Masaharu41/Midi-Bass-Guitar/Images/Midi Waveform.jpg

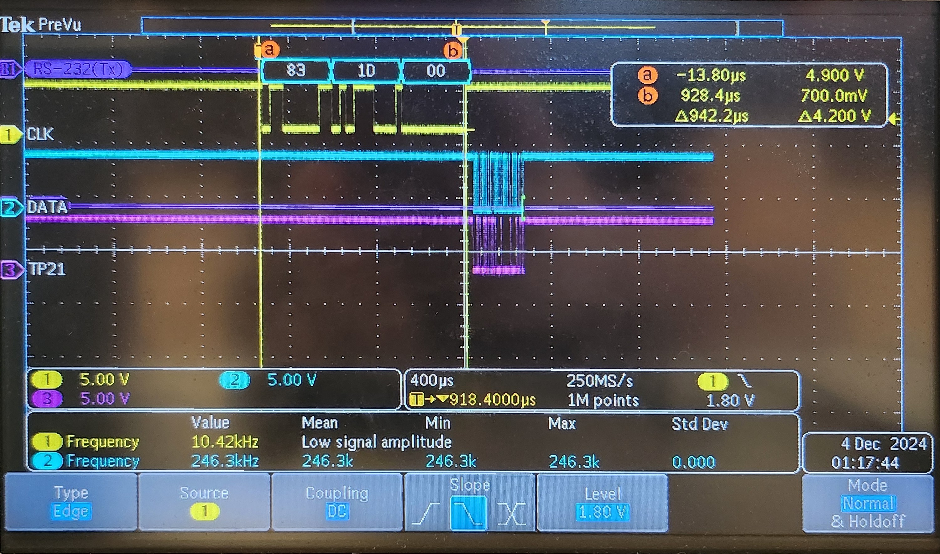
Images/Midi Waveform.jpg
