Masaharu41/Midi-Bass-Guitar/Images/hex switch.jpg

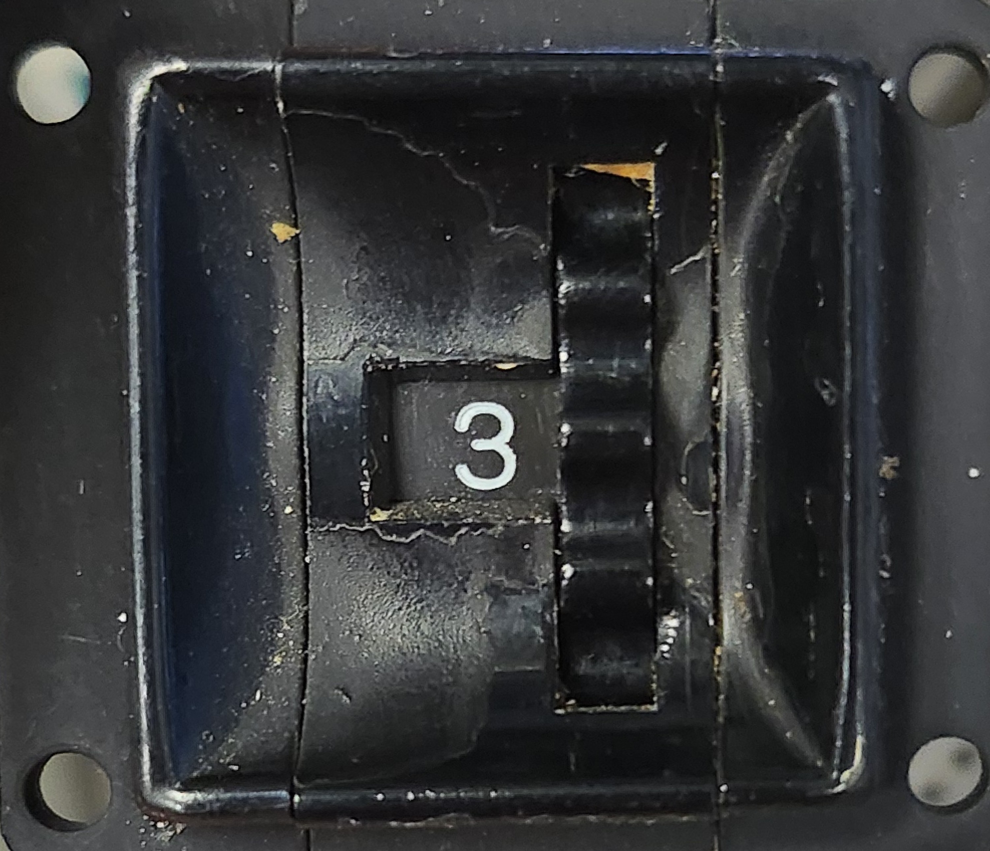
Images/hex switch.jpg
