Masaharu41/Midi-Bass-Guitar/Images/I2C TP.png

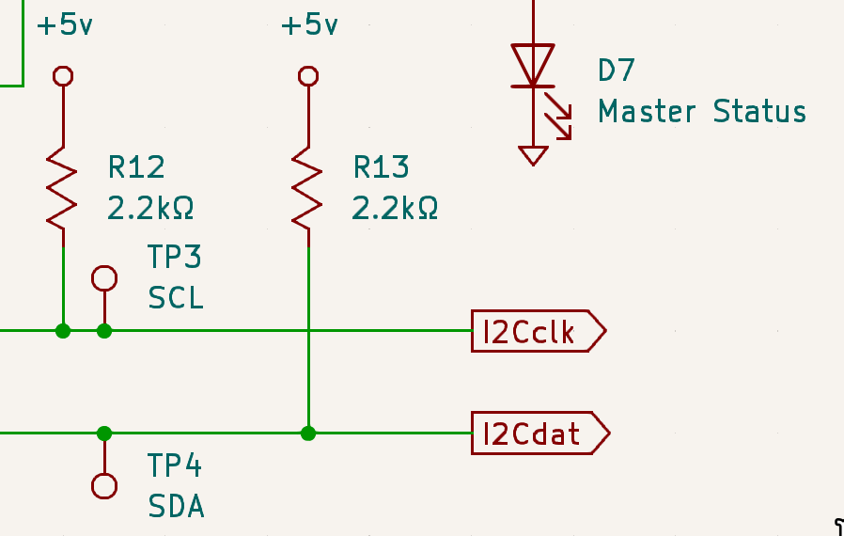
Images/I2C TP.png
