Masaharu41/Midi-Bass-Guitar/Images/I2C waveform.jpg

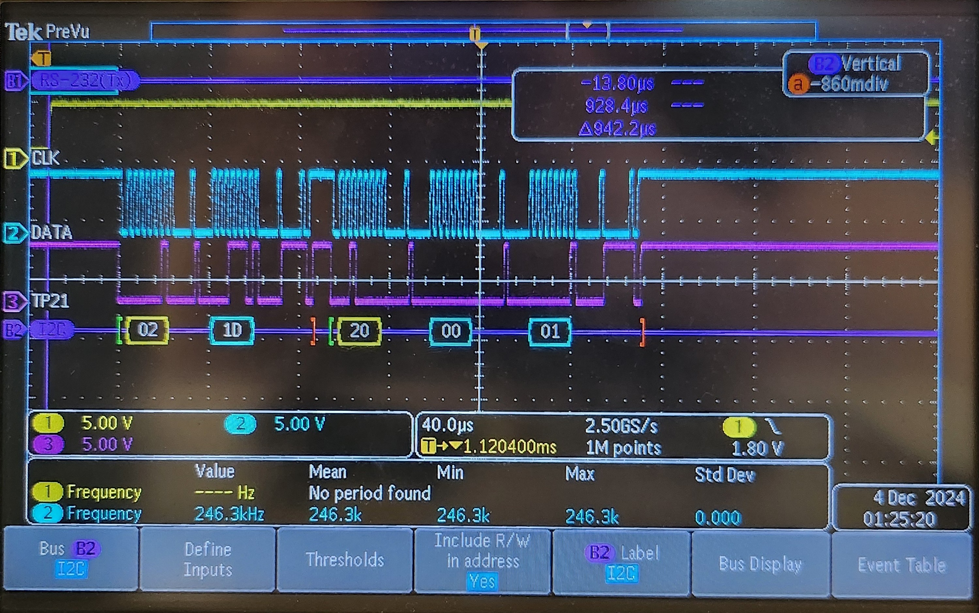
Images/I2C waveform.jpg
