Masaharu41/Midi-Bass-Guitar/Images/MIDI TP.png

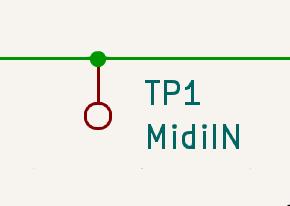
Images/MIDI TP.png
