Masaharu41/Midi-Bass-Guitar/Images/P-bass CAD asm.png

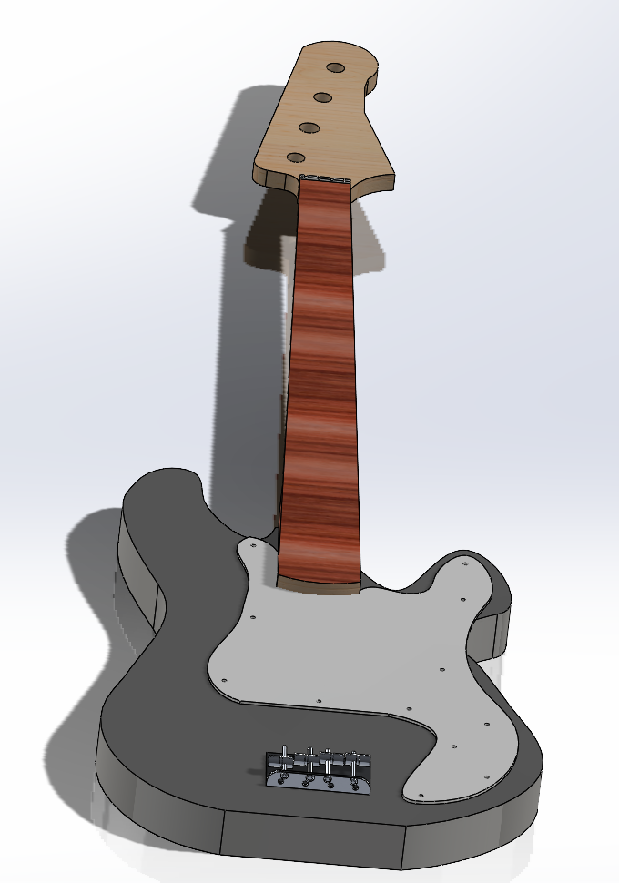
Images/P-bass CAD asm.png
