Masaharu41/Midi-Bass-Guitar/Images/Plucking Output.png

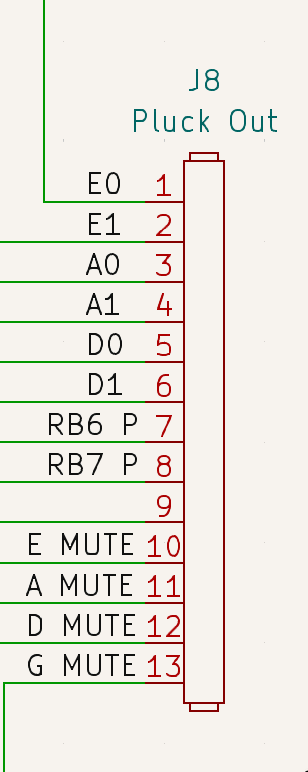
Images/Plucking Output.png
