Masaharu41/Midi-Bass-Guitar/Images/Plucking Program Flowchart.png

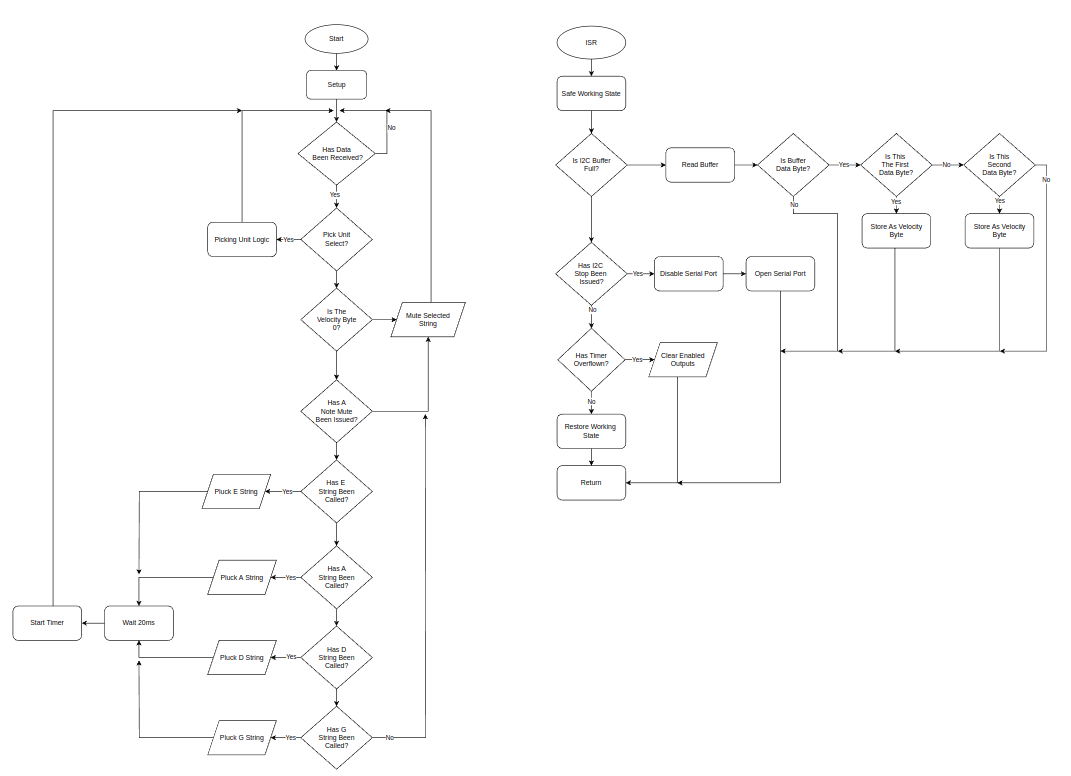
Images/Plucking Program Flowchart.png
