Masaharu41/Midi-Bass-Guitar/Images/Plucking Unit Flowchart.png

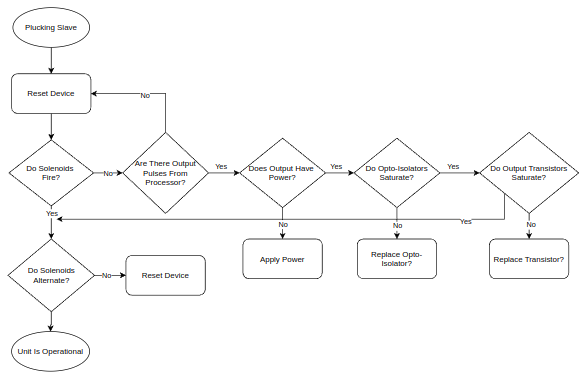
Images/Plucking Unit Flowchart.png
