Masaharu41/Midi-Bass-Guitar/Images/String Output.png

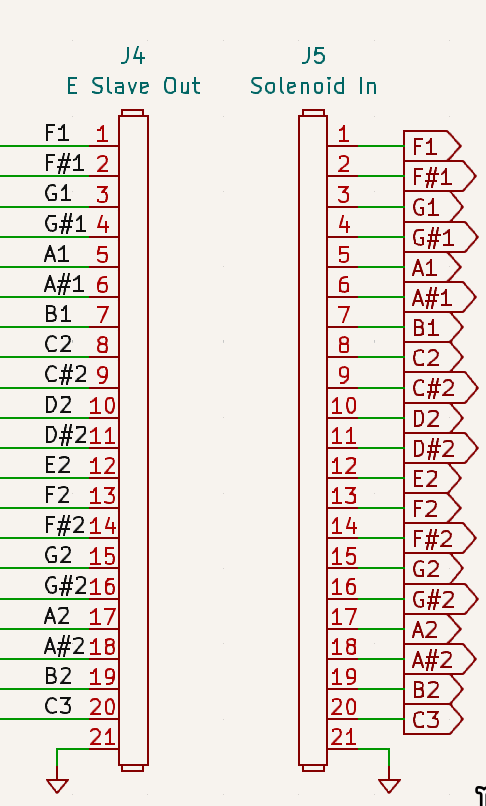
Images/String Output.png
