Masaharu41/Midi-Bass-Guitar/Images/String Slave Flowchart.png

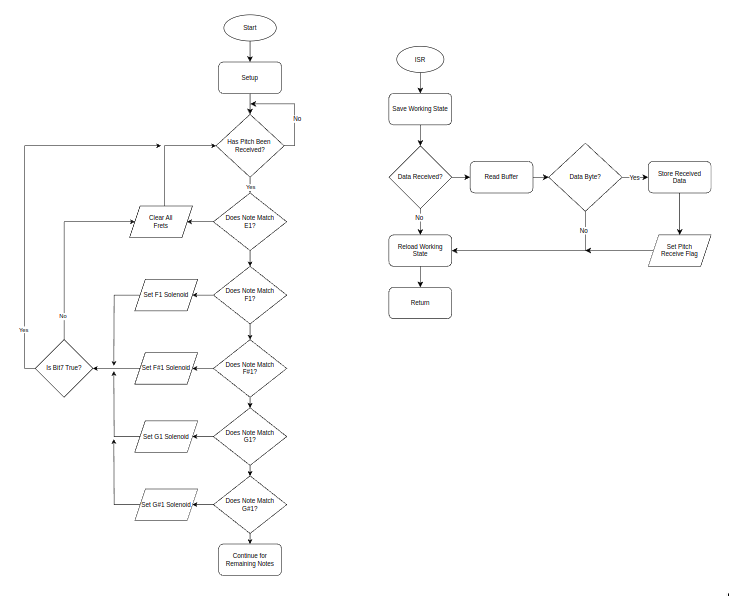
Images/String Slave Flowchart.png
