Masaharu41/Midi-Bass-Guitar/Bass Guitar Cad Models/Electronics/PCB Case Assem.SLDASM

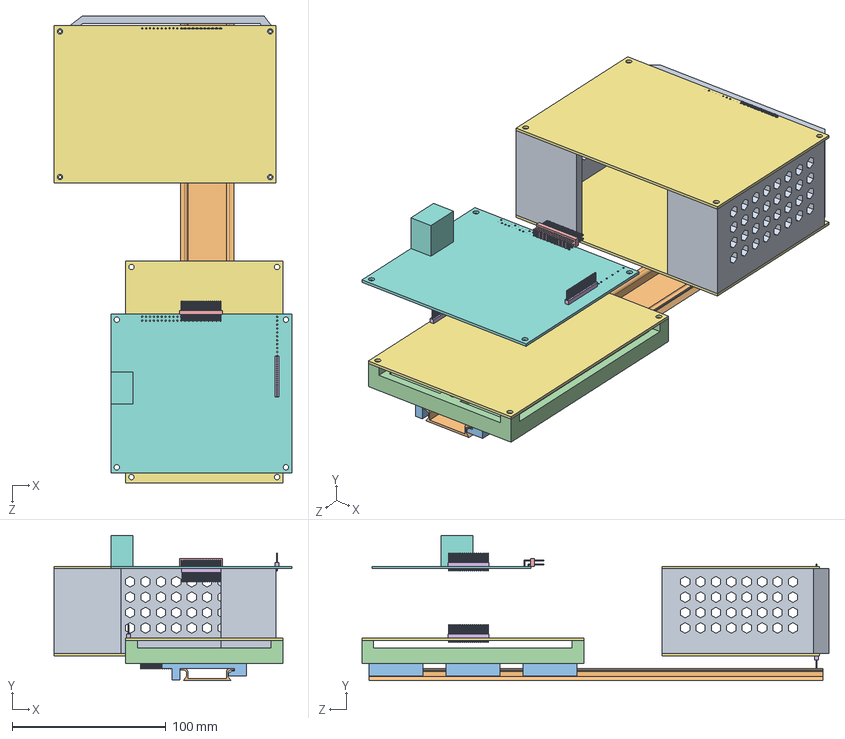
[picture p13: CAD file, 2025-05-04]
Bass Guitar Cad Models/Electronics/PCB Case Assem.SLDASM
154.3 x 94.2 x 303.3 mm
Motherboard PCB BLANK
Solenoid PCB Blank x 3
2.54mm Header 21-pin x 4
2.54mm Right Header 21-pin 2x
Solenoid Hori Mount
DIN Rail Mounts x 3
DIN Mounting Rail
Fret Board Cage
