Masaharu41/Midi-Bass-Guitar/Bass Guitar Cad Models/Electronics/DIN Rail Mounts.SLDPRT

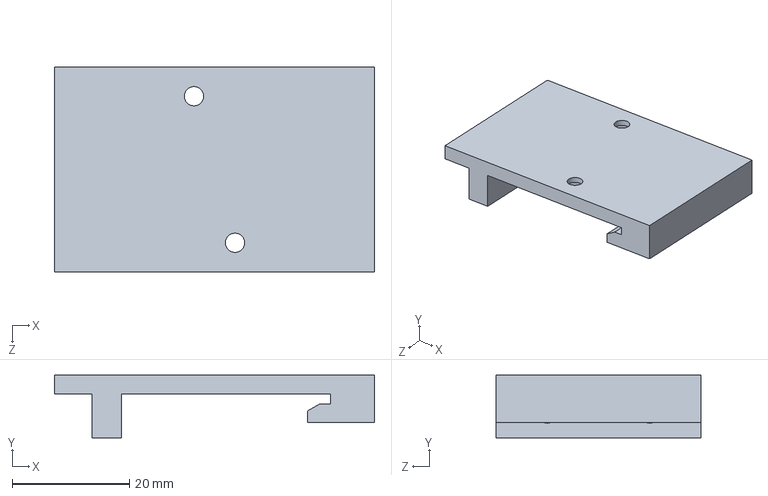
[picture p14: CAD file, 2025-05-07]
Bass Guitar Cad Models/Electronics/DIN Rail Mounts.SLDPRT
54.6 x 10.7 x 35.0 mm
