Masaharu41/Midi-Bass-Guitar/Bass Guitar Cad Models/Fret Bars/20th Fret Bar.SLDPRT

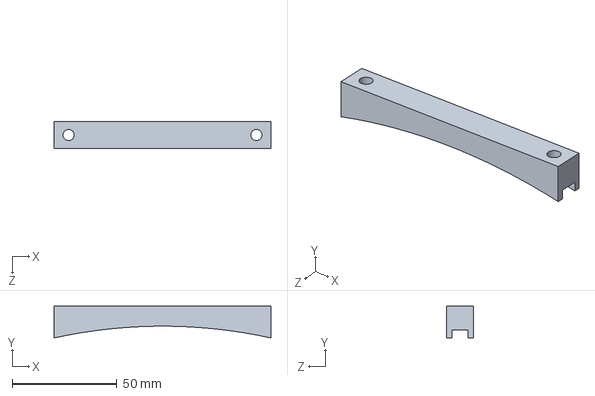
[picture p15: CAD file, 2025-05-01]
Bass Guitar Cad Models/Fret Bars/20th Fret Bar.SLDPRT
103.7 x 15.2 x 12.7 mm
