Masaharu41/Midi-Bass-Guitar/Bass Guitar Cad Models/Small Mounting Bracket A.SLDPRT

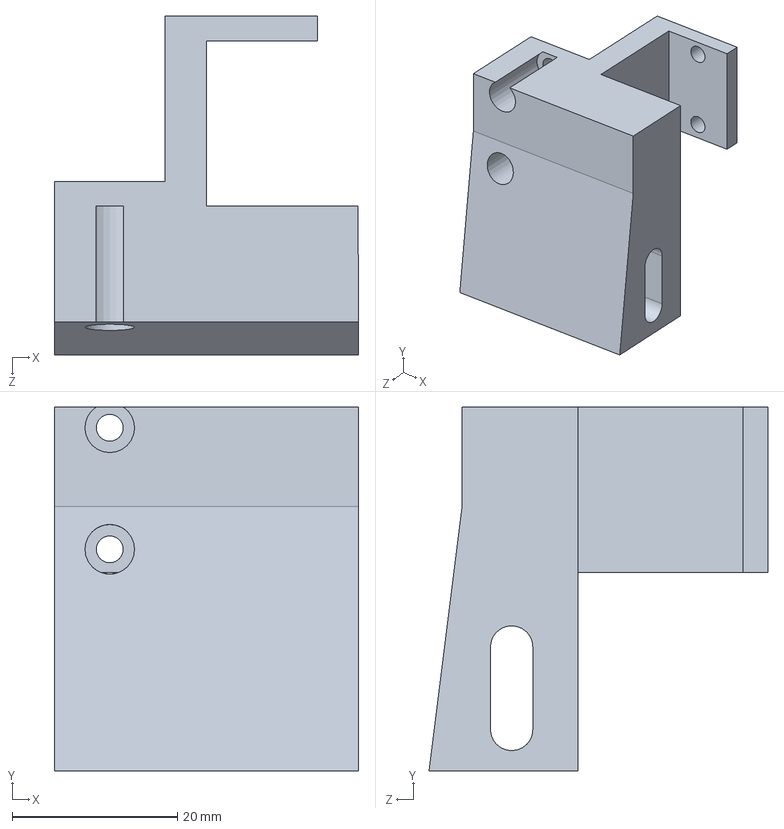
[picture p16: CAD file, 2025-05-07]
Bass Guitar Cad Models/Small Mounting Bracket A.SLDPRT
36.8 x 44.0 x 41.0 mm
