Masaharu41/Midi-Bass-Guitar/Bass Guitar Cad Models/Electronics/Fret Board Cage.SLDPRT

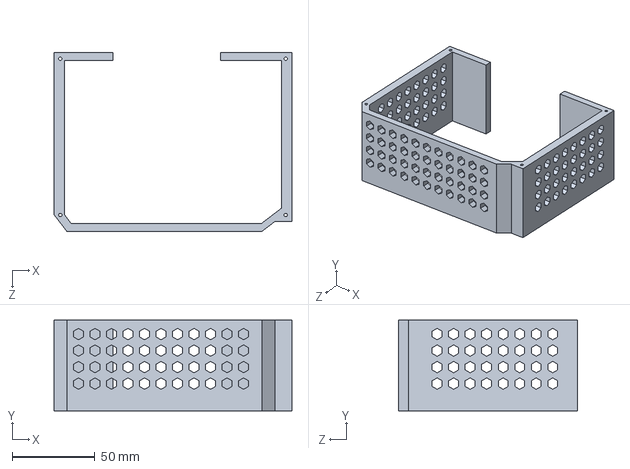
[picture p17: CAD file, 2025-05-04]
Bass Guitar Cad Models/Electronics/Fret Board Cage.SLDPRT
144.1 x 55.0 x 108.4 mm
