Masaharu41/Midi-Bass-Guitar/Bass Guitar Cad Models/Muting Finger.SLDPRT

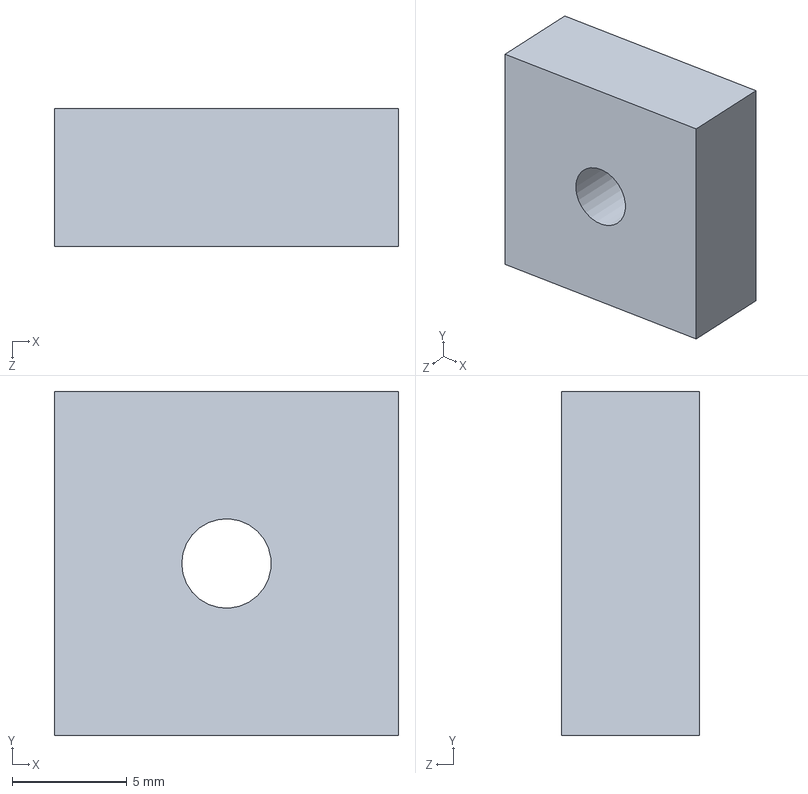
[picture p18: CAD file, 2025-05-07]
Bass Guitar Cad Models/Muting Finger.SLDPRT
15.0 x 15.0 x 6.00 mm
