Masaharu41/Midi-Bass-Guitar/Bass Guitar Cad Models/STLs/Solenoid Hori Mount.STL

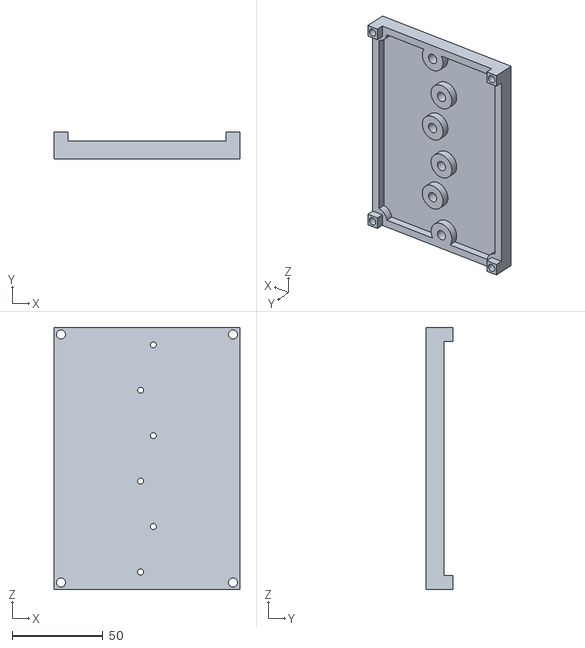
[picture p19: CAD file, 2025-05-04]
Bass Guitar Cad Models/STLs/Solenoid Hori Mount.STL
102.2 x 15.0 x 144.1
