Masaharu41/Midi-Bass-Guitar/Bass Guitar Cad Models/Electronics/DIN Mounting Rail.SLDPRT

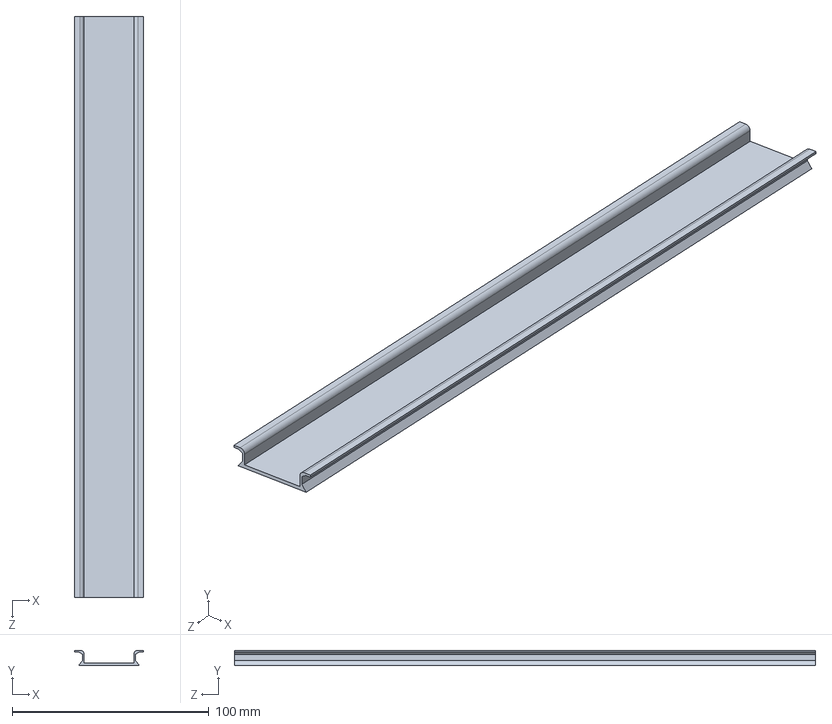
[picture p20: CAD file, 2025-05-04]
Bass Guitar Cad Models/Electronics/DIN Mounting Rail.SLDPRT
34.8 x 7.82 x 295.0 mm
