Masaharu41/Midi-Bass-Guitar/Bass Guitar Cad Models/Muting Bracket.SLDPRT

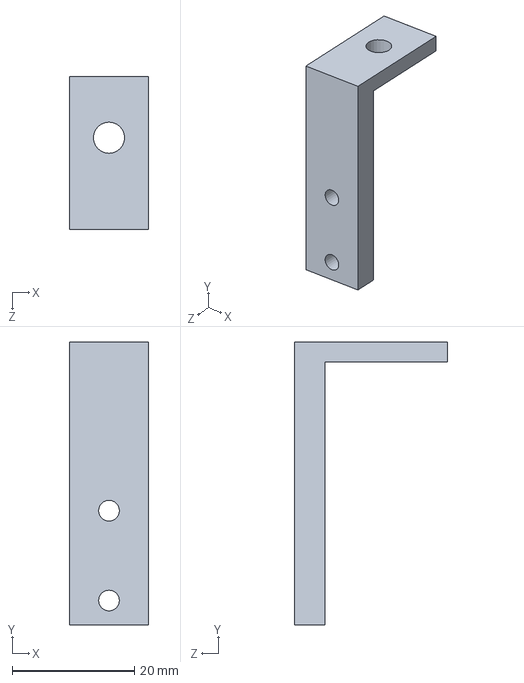
[picture p22: CAD file, 2025-05-07]
Bass Guitar Cad Models/Muting Bracket.SLDPRT
13.0 x 46.3 x 25.0 mm
