Masaharu41/Midi-Bass-Guitar/Bass Guitar Cad Models/Fret Bars/14th Fret Bar.SLDPRT

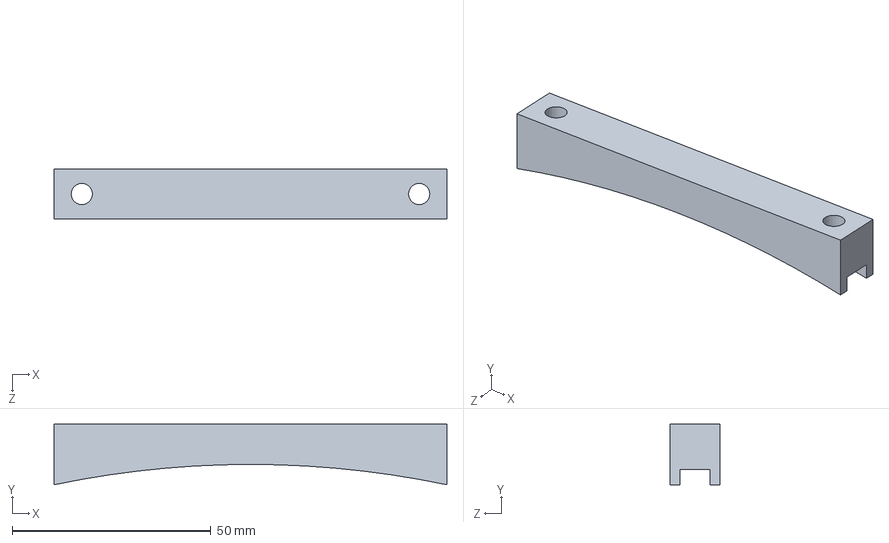
[picture p23: CAD file, 2025-05-01]
Bass Guitar Cad Models/Fret Bars/14th Fret Bar.SLDPRT
98.9 x 15.2 x 12.7 mm
