Masaharu41/Midi-Bass-Guitar/Bass Guitar Cad Models/STLs/PCB Standoff.STL

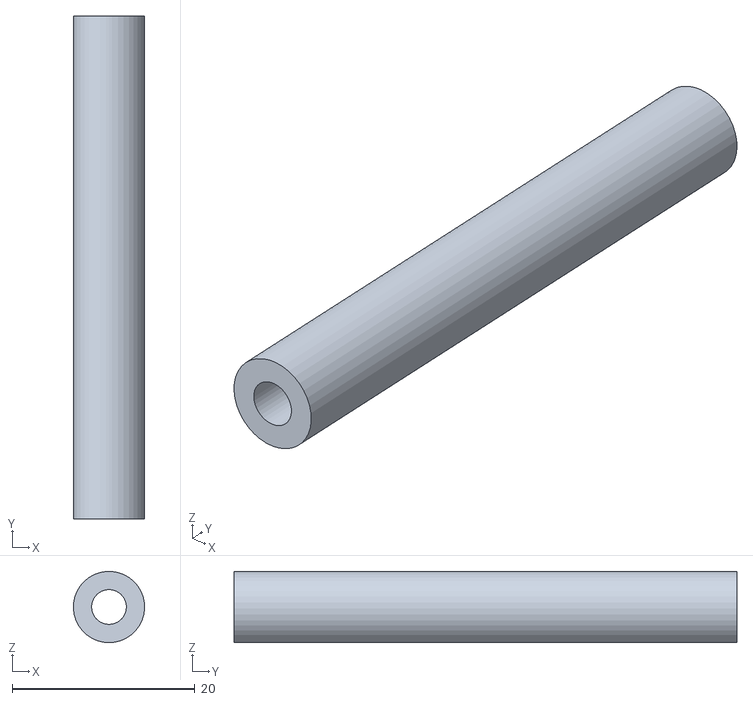
[picture p24: CAD file, 2025-05-03]
Bass Guitar Cad Models/STLs/PCB Standoff.STL
7.79 x 55.0 x 7.80
