Masaharu41/Midi-Bass-Guitar/Bass Guitar Cad Models/2020 Extrusion.SLDPRT

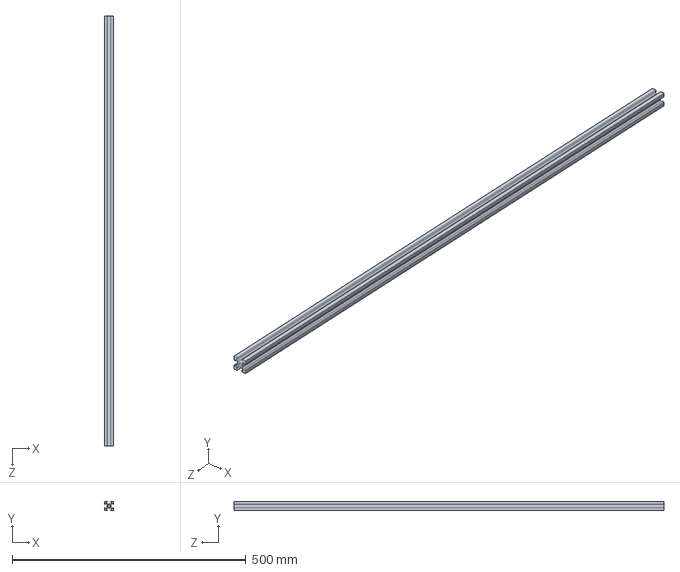
[picture p25: CAD file, 2025-05-06]
Bass Guitar Cad Models/2020 Extrusion.SLDPRT
20.0 x 20.0 x 920.0 mm
