Masaharu41/Midi-Bass-Guitar/Bass Guitar Cad Models/Fret Bars/11th Fret Bar.SLDPRT

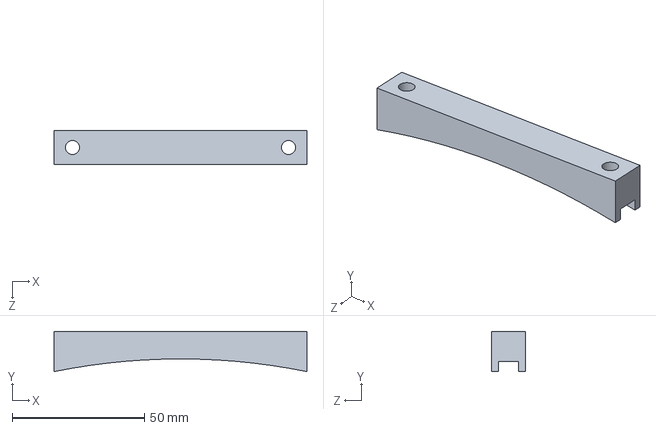
[picture p26: CAD file, 2025-05-01]
Bass Guitar Cad Models/Fret Bars/11th Fret Bar.SLDPRT
95.8 x 15.2 x 12.7 mm
