Masaharu41/Midi-Bass-Guitar/Bass Guitar Cad Models/STLs/14th Fret Bar.STL

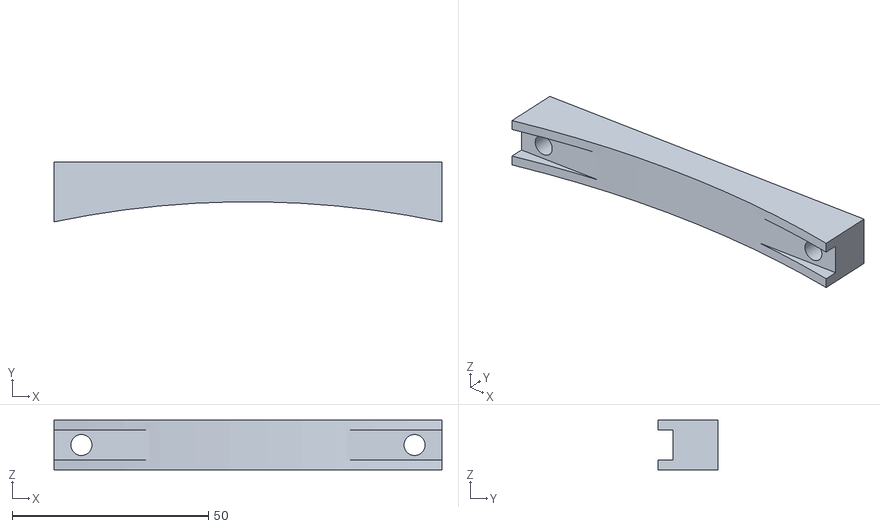
[picture p27: CAD file, 2025-05-02]
Bass Guitar Cad Models/STLs/14th Fret Bar.STL
98.9 x 15.2 x 12.7
