Masaharu41/Midi-Bass-Guitar/Bass Guitar Cad Models/Bottom Support Bracket.SLDPRT

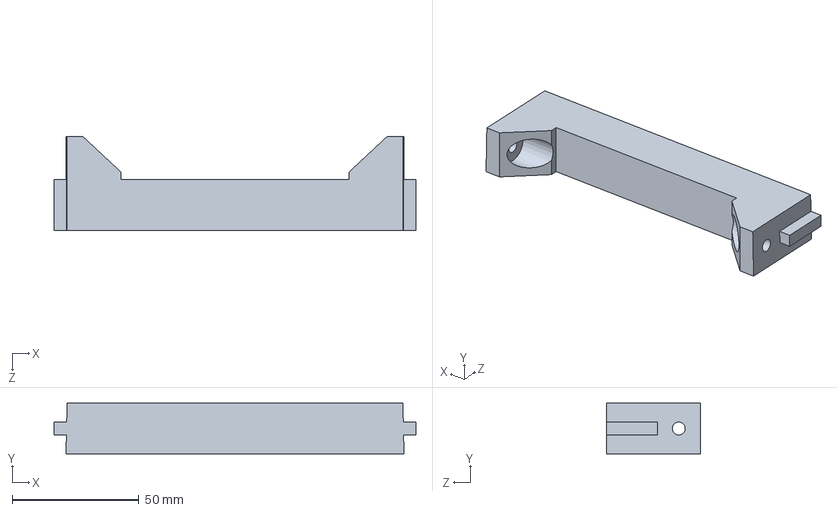
[picture p28: CAD file, 2025-05-06]
Bass Guitar Cad Models/Bottom Support Bracket.SLDPRT
143.0 x 20.0 x 37.0 mm
