Masaharu41/Midi-Bass-Guitar/Bass Guitar Cad Models/Electronics/PCB Mount.SLDPRT

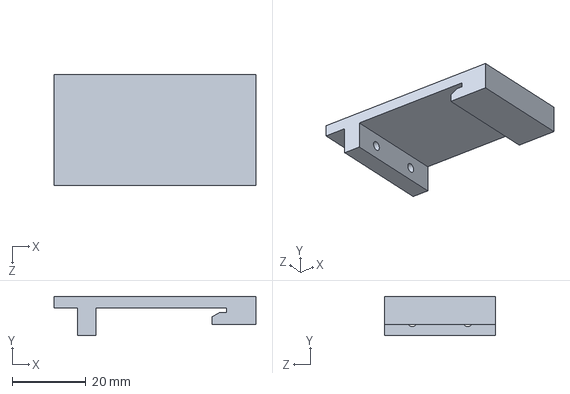
[picture p29: CAD file, 2025-05-04]
Bass Guitar Cad Models/Electronics/PCB Mount.SLDPRT
54.6 x 10.7 x 30.0 mm
