Masaharu41/Midi-Bass-Guitar/Bass Guitar Cad Models/Fret Bars/16th Fret Bar.SLDPRT

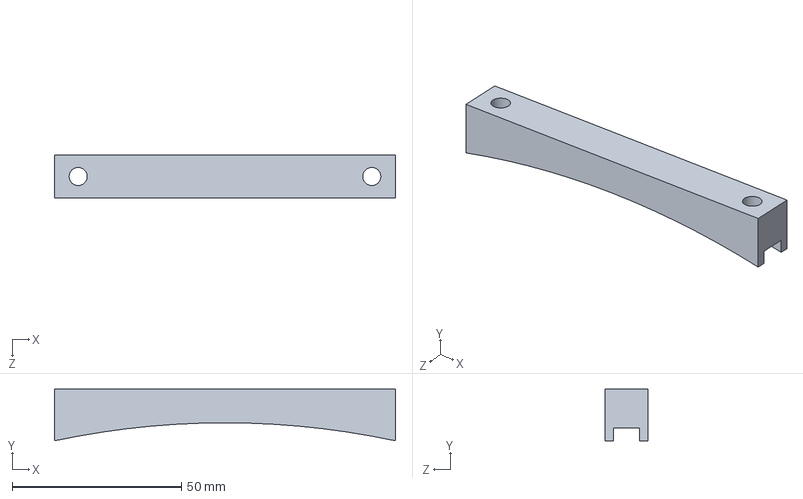
[picture p30: CAD file, 2025-05-01]
Bass Guitar Cad Models/Fret Bars/16th Fret Bar.SLDPRT
100.7 x 15.2 x 12.7 mm
