Masaharu41/Midi-Bass-Guitar/Bass Guitar Cad Models/2020 Extrusion Short.SLDPRT

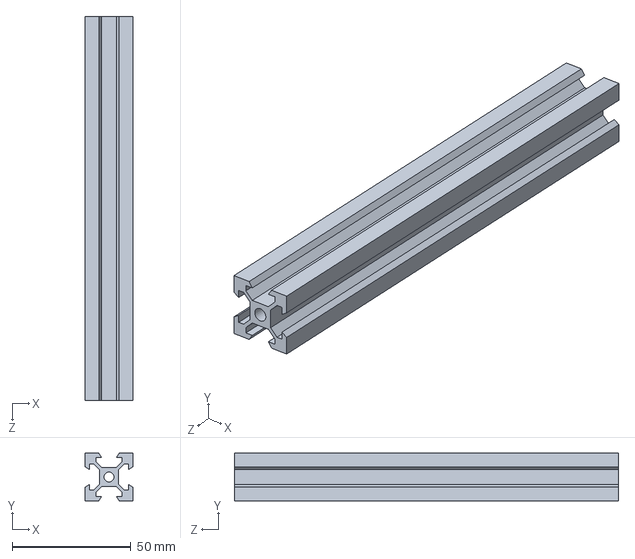
[picture p31: CAD file, 2025-05-06]
Bass Guitar Cad Models/2020 Extrusion Short.SLDPRT
20.0 x 20.0 x 161.5 mm
