Masaharu41/Midi-Bass-Guitar/Bass Guitar Cad Models/Electronics/2.54mm Header Single.SLDPRT

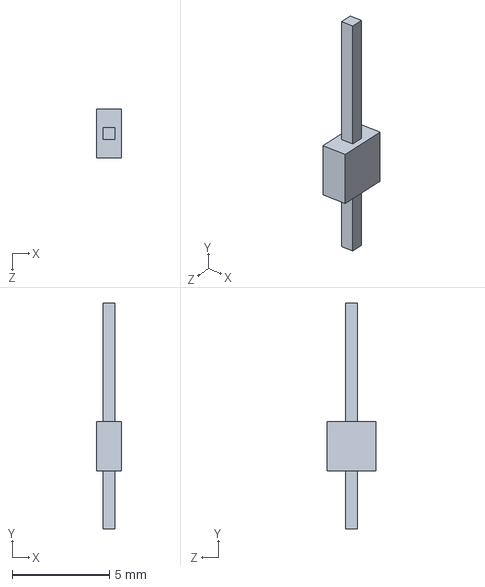
[picture p32: CAD file, 2025-05-03]
Bass Guitar Cad Models/Electronics/2.54mm Header Single.SLDPRT
1.27 x 11.6 x 2.54 mm
