Masaharu41/Midi-Bass-Guitar/Bass Guitar Cad Models/Fret Bars/12th Fret Bar.SLDPRT

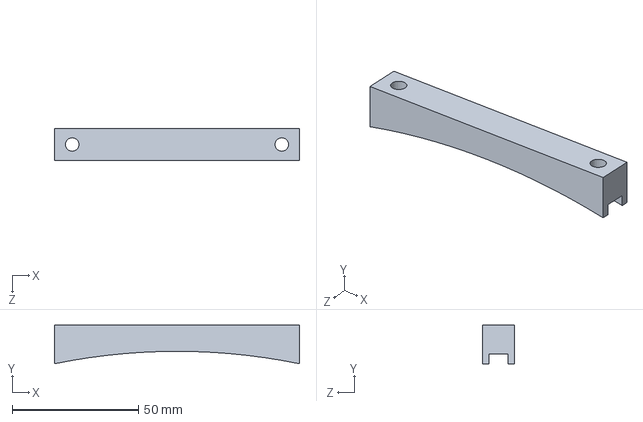
[picture p33: CAD file, 2025-05-01]
Bass Guitar Cad Models/Fret Bars/12th Fret Bar.SLDPRT
97.0 x 15.2 x 12.7 mm
