Masaharu41/Midi-Bass-Guitar/Bass Guitar Cad Models/Bass Mount left.SLDPRT

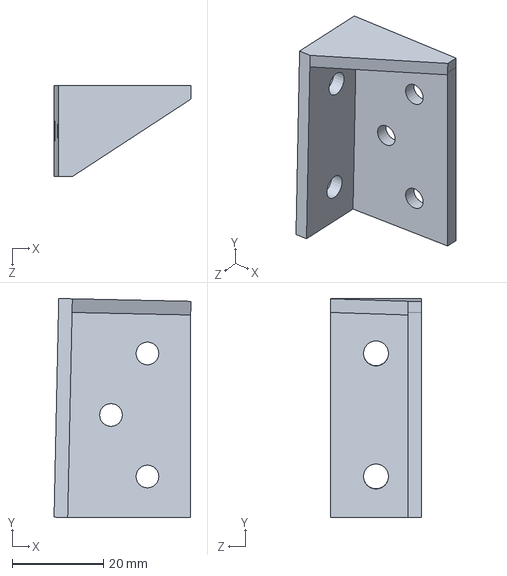
[picture p34: CAD file, 2025-05-06]
Bass Guitar Cad Models/Bass Mount left.SLDPRT
30.1 x 48.1 x 20.0 mm
