Masaharu41/Midi-Bass-Guitar/Bass Guitar Cad Models/Electronics/2.54mm Right Header 21-pin 2x.SLDPRT

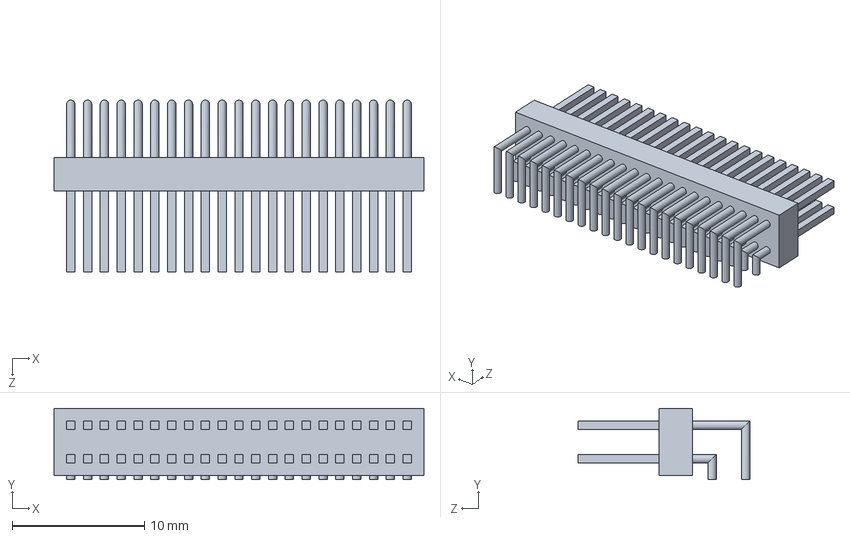
[picture p35: CAD file, 2025-05-03]
Bass Guitar Cad Models/Electronics/2.54mm Right Header 21-pin 2x.SLDPRT
27.9 x 5.38 x 13.0 mm
