Masaharu41/Midi-Bass-Guitar/Bass Guitar Cad Models/Fret Bars/5th Fret Bar.SLDPRT

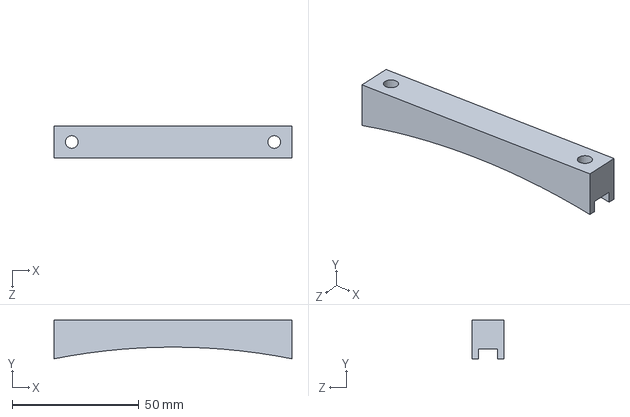
[picture p36: CAD file, 2025-04-30]
Bass Guitar Cad Models/Fret Bars/5th Fret Bar.SLDPRT
93.9 x 15.2 x 12.7 mm
