Masaharu41/Midi-Bass-Guitar/Bass Guitar Cad Models/4n Solenoid Pin.SLDPRT

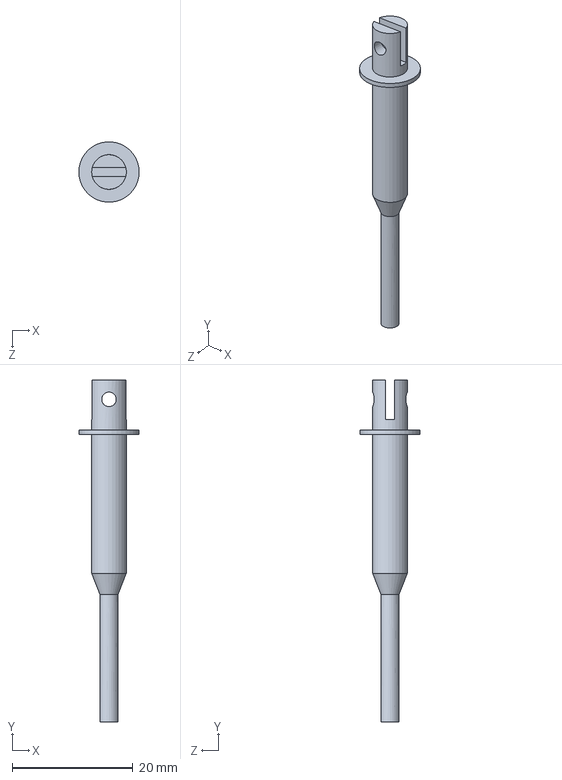
[picture p37: CAD file, 2025-05-06]
Bass Guitar Cad Models/4n Solenoid Pin.SLDPRT
10.0 x 56.6 x 9.97 mm
