Masaharu41/Midi-Bass-Guitar/Bass Guitar Cad Models/Electronics/2.54mm Header 21-pin.SLDPRT

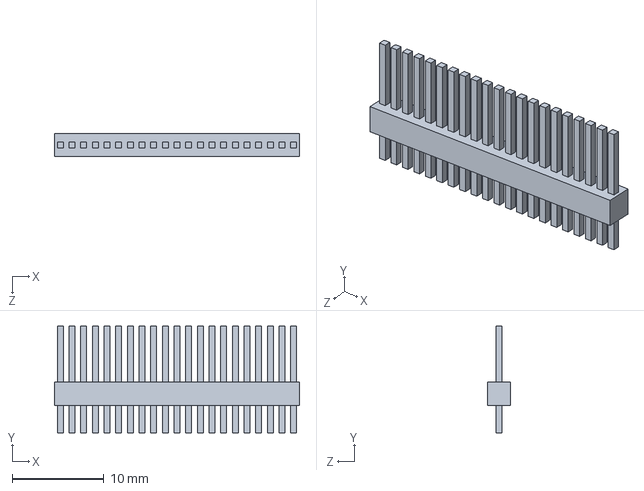
[picture p38: CAD file, 2025-05-03]
Bass Guitar Cad Models/Electronics/2.54mm Header 21-pin.SLDPRT
26.7 x 11.6 x 2.54 mm
