Masaharu41/Midi-Bass-Guitar/Bass Guitar Cad Models/Fret Bars/4th Fret Bar.SLDPRT

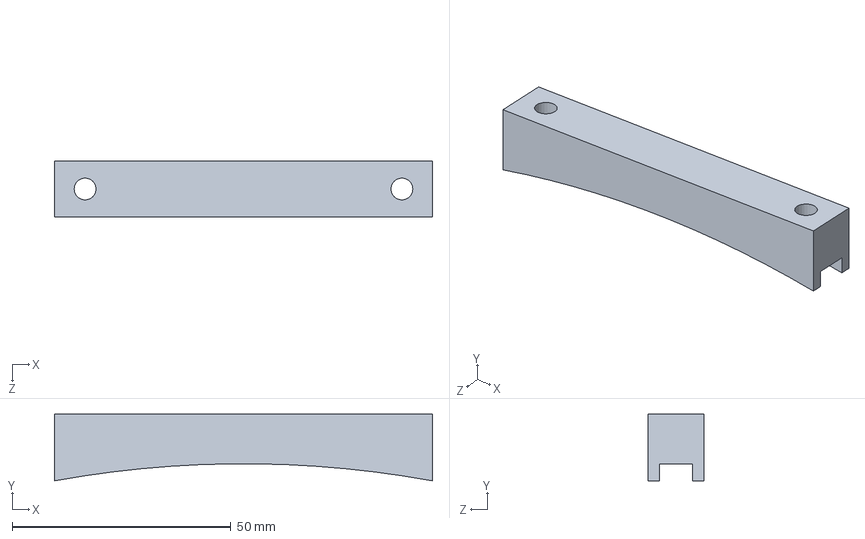
[picture p39: CAD file, 2025-04-30]
Bass Guitar Cad Models/Fret Bars/4th Fret Bar.SLDPRT
86.4 x 15.2 x 12.7 mm
