Masaharu41/Midi-Bass-Guitar/Bass Guitar Cad Models/4n Solenoid Body.SLDPRT

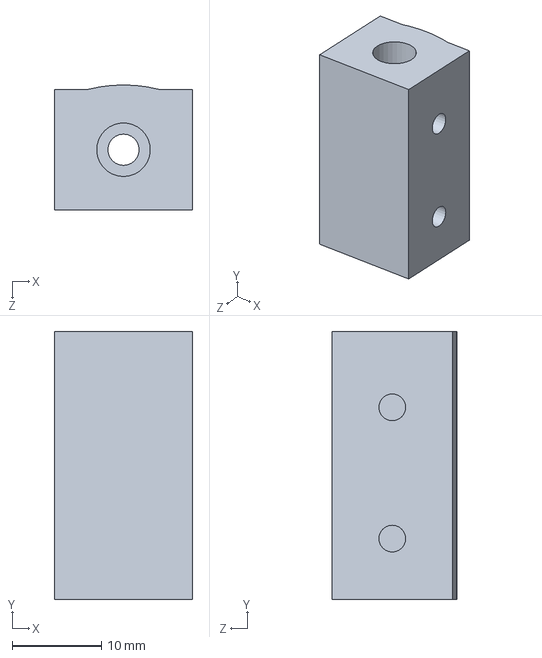
[picture p40: CAD file, 2025-05-06]
Bass Guitar Cad Models/4n Solenoid Body.SLDPRT
15.5 x 30.0 x 14.0 mm
