Masaharu41/Midi-Bass-Guitar/Bass Guitar Cad Models/Fret Bars/7th Fret Bar.SLDPRT

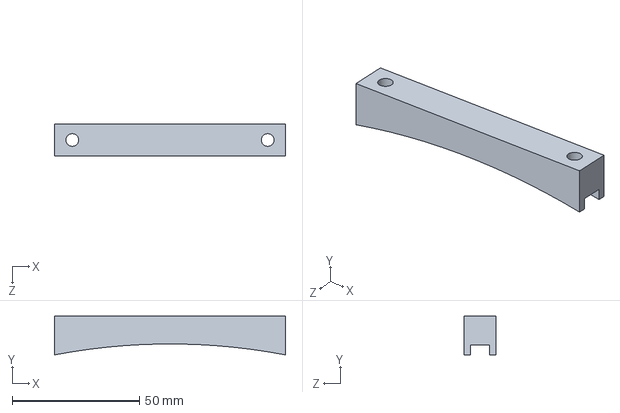
[picture p41: CAD file, 2025-04-30]
Bass Guitar Cad Models/Fret Bars/7th Fret Bar.SLDPRT
90.8 x 15.2 x 12.7 mm
