Masaharu41/Midi-Bass-Guitar/Bass Guitar Cad Models/Electronics/Motherboard PCB BLANK.SLDPRT

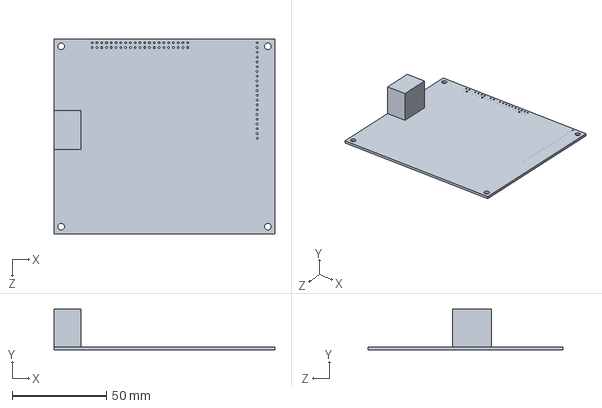
[picture p42: CAD file, 2025-05-03]
Bass Guitar Cad Models/Electronics/Motherboard PCB BLANK.SLDPRT
117.5 x 21.6 x 103.5 mm
