Masaharu41/Midi-Bass-Guitar/Bass Guitar Cad Models/Fret Bars/9th Fret Bar.SLDPRT

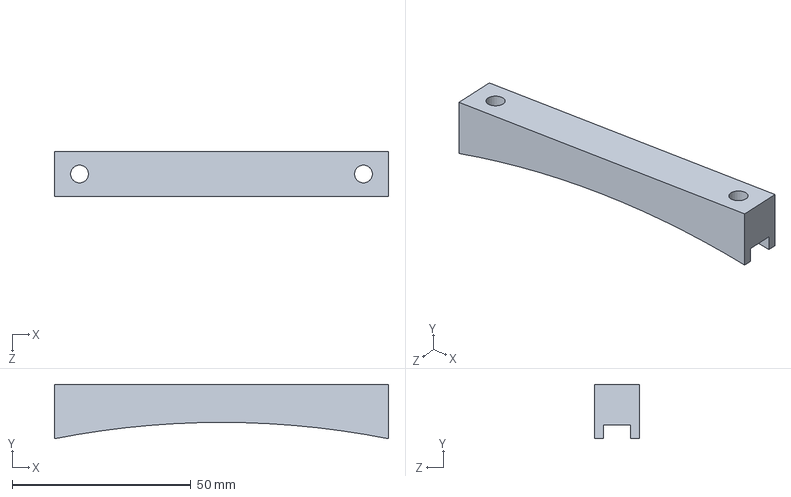
[picture p43: CAD file, 2025-04-30]
Bass Guitar Cad Models/Fret Bars/9th Fret Bar.SLDPRT
93.5 x 15.2 x 12.7 mm
