Masaharu41/Midi-Bass-Guitar/Bass Guitar Cad Models/Small Mounting Bracket.SLDPRT

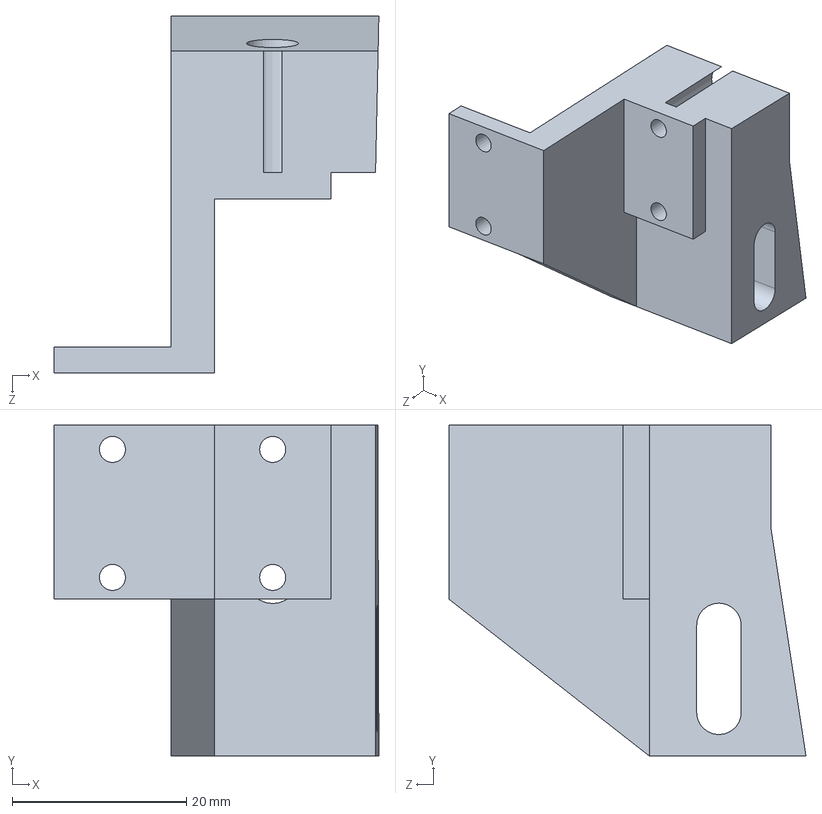
[picture p44: CAD file, 2025-05-06]
Bass Guitar Cad Models/Small Mounting Bracket.SLDPRT
37.3 x 38.0 x 41.0 mm
