Masaharu41/Midi-Bass-Guitar/Bass Guitar Cad Models/Electronics/Solenoid PCB Blank.SLDPRT

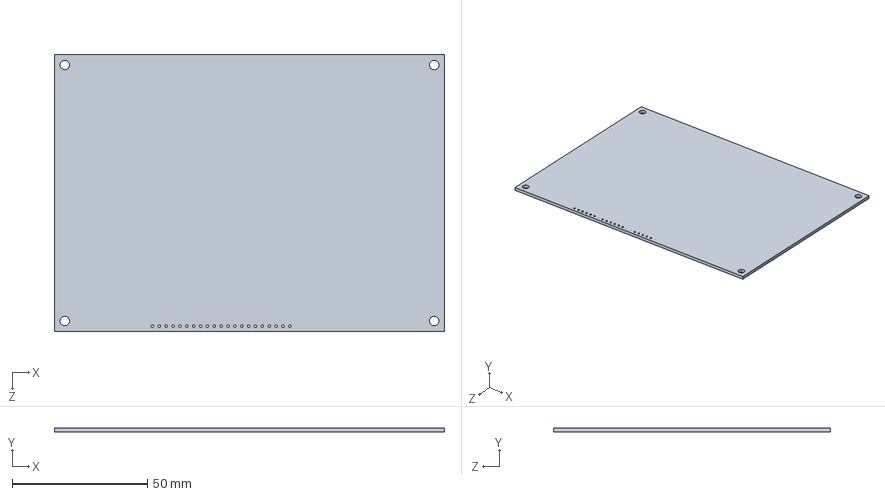
[picture p45: CAD file, 2025-05-03]
Bass Guitar Cad Models/Electronics/Solenoid PCB Blank.SLDPRT
144.1 x 1.60 x 102.2 mm
