Masaharu41/Midi-Bass-Guitar/Bass Guitar Cad Models/STLs/3rd Fret Bar.STL

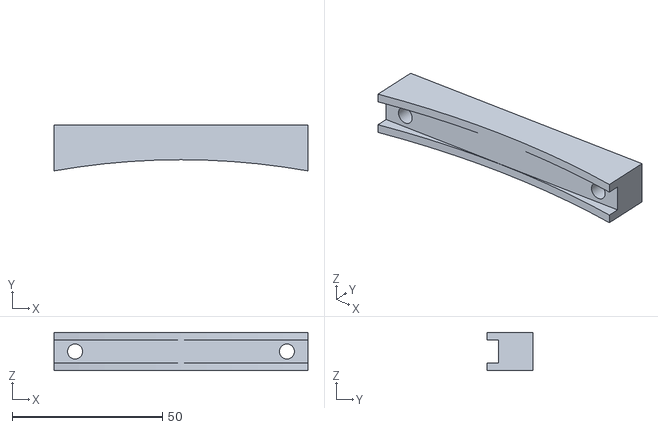
[picture p47: CAD file, 2025-04-30]
Bass Guitar Cad Models/STLs/3rd Fret Bar.STL
84.4 x 15.2 x 12.7
