Masaharu41/Midi-Bass-Guitar/Bass Guitar Cad Models/Top Cross Support.SLDPRT

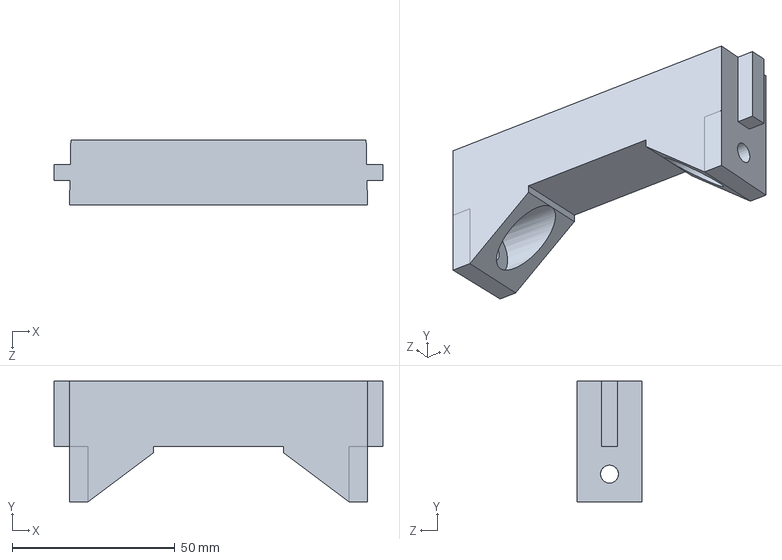
[picture p48: CAD file, 2025-05-06]
Bass Guitar Cad Models/Top Cross Support.SLDPRT
100.9 x 37.0 x 20.0 mm
