Masaharu41/Midi-Bass-Guitar/Bass Guitar Cad Models/Fret Bars/8th Fret Bar.SLDPRT

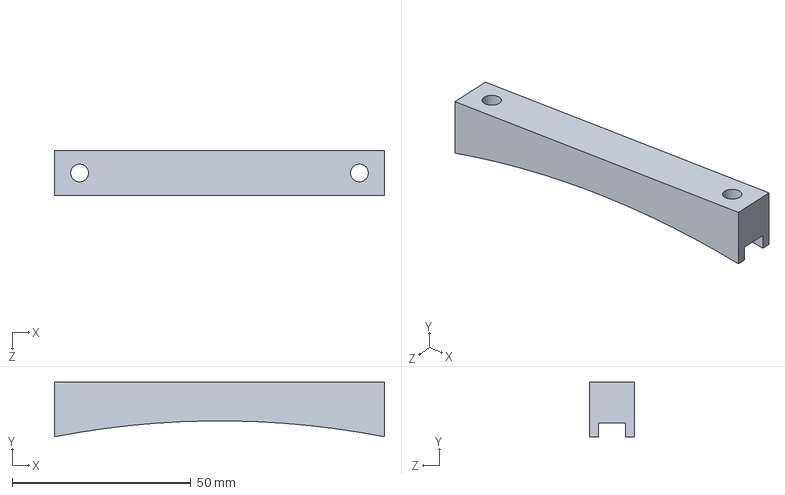
[picture p49: CAD file, 2025-04-30]
Bass Guitar Cad Models/Fret Bars/8th Fret Bar.SLDPRT
92.2 x 15.2 x 12.7 mm
