Masaharu41/Midi-Bass-Guitar/Bass Guitar Cad Models/Neck Support Brace.SLDPRT

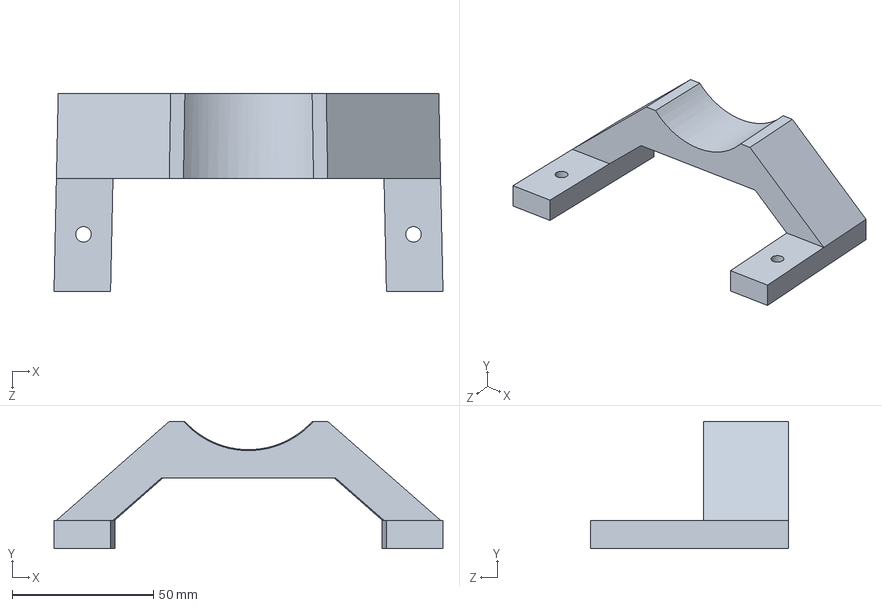
[picture p50: CAD file, 2025-05-06]
Bass Guitar Cad Models/Neck Support Brace.SLDPRT
137.5 x 45.0 x 70.0 mm
