Masaharu41/Midi-Bass-Guitar/Bass Guitar Cad Models/Solenoid 2020 Mount.SLDPRT

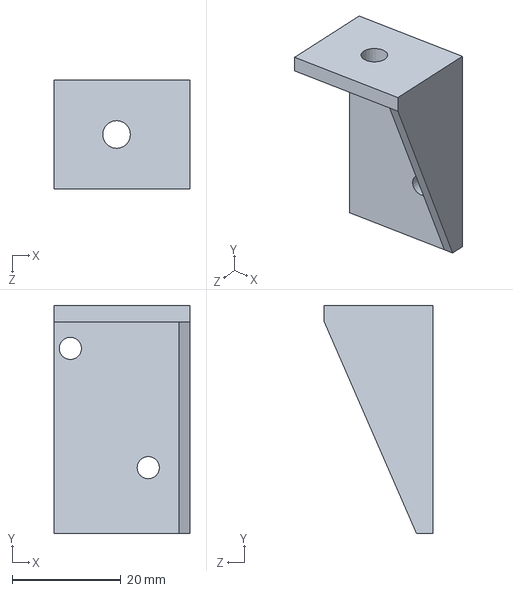
[picture p51: CAD file, 2025-05-06]
Bass Guitar Cad Models/Solenoid 2020 Mount.SLDPRT
25.0 x 42.0 x 20.0 mm
