Masaharu41/Midi-Bass-Guitar/Bass Guitar Cad Models/Fret Bars/2nd Fret Bar.SLDPRT

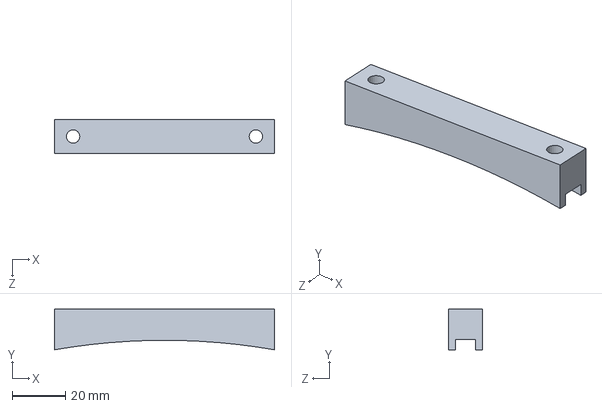
[picture p52: CAD file, 2025-04-29]
Bass Guitar Cad Models/Fret Bars/2nd Fret Bar.SLDPRT
82.6 x 15.2 x 12.7 mm
