Masaharu41/Midi-Bass-Guitar/Bass Guitar Cad Models/Small Mounting Bracket G.SLDPRT

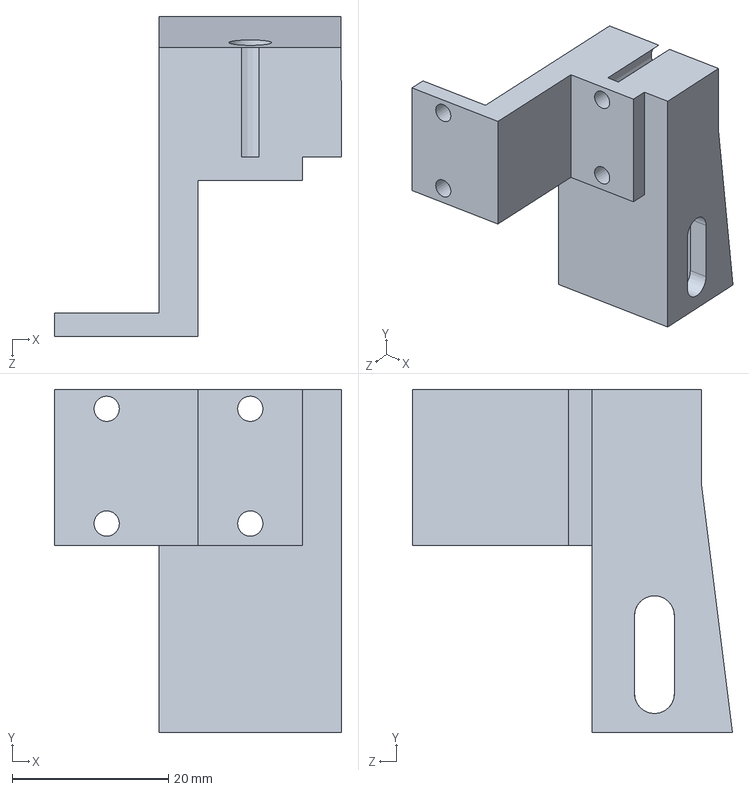
[picture p53: CAD file, 2025-05-01]
Bass Guitar Cad Models/Small Mounting Bracket G.SLDPRT
36.8 x 44.0 x 41.0 mm
