Masaharu41/Midi-Bass-Guitar/Bass Guitar Cad Models/Fret Bars/First Fret Bar.SLDPRT

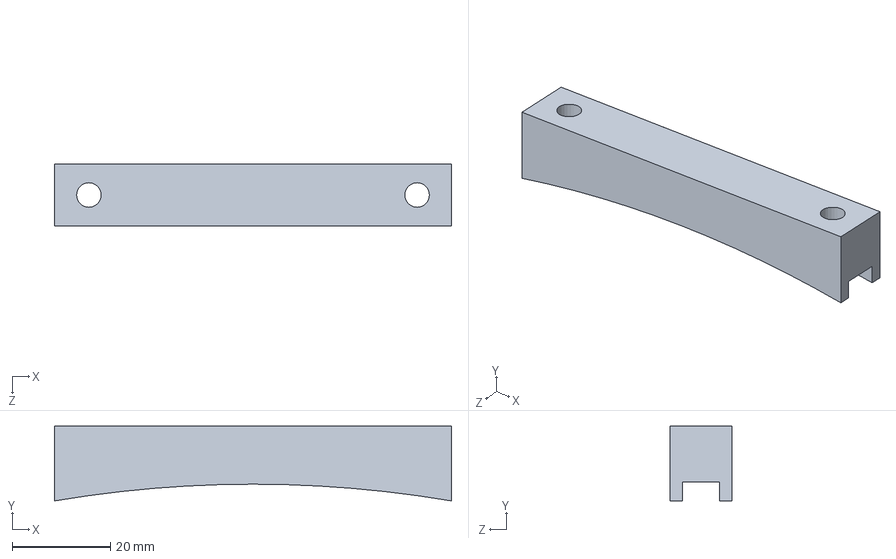
[picture p54: CAD file, 2025-04-16]
Bass Guitar Cad Models/Fret Bars/First Fret Bar.SLDPRT
80.8 x 15.2 x 12.7 mm
