Masaharu41/Midi-Bass-Guitar/Bass Guitar Cad Models/Fret Bars/Sponge Blank.SLDPRT

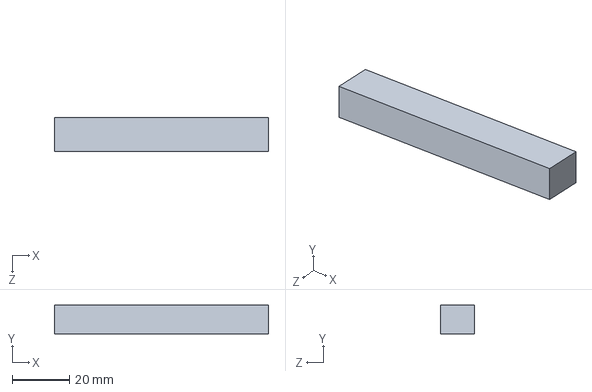
[picture p55: CAD file, 2025-03-18]
Bass Guitar Cad Models/Fret Bars/Sponge Blank.SLDPRT
74.8 x 10.0 x 12.0 mm
