Masaharu41/Midi-Bass-Guitar/Bass Guitar Cad Models/Pick Guard.SLDPRT

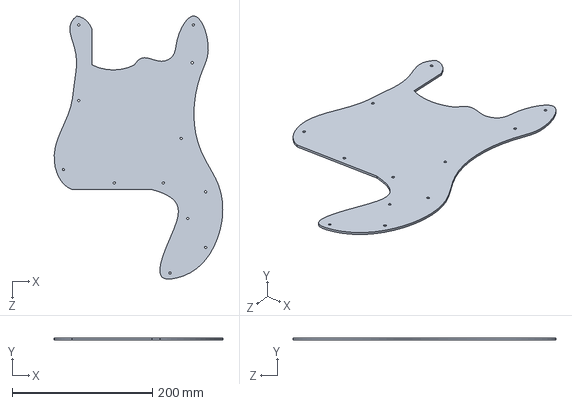
[picture p56: CAD file, 2025-03-18]
Bass Guitar Cad Models/Pick Guard.SLDPRT
240.4 x 2.54 x 375.2 mm
