Masaharu41/Midi-Bass-Guitar/Bass Guitar Cad Models/90 Angle 2020 Bracket.SLDPRT

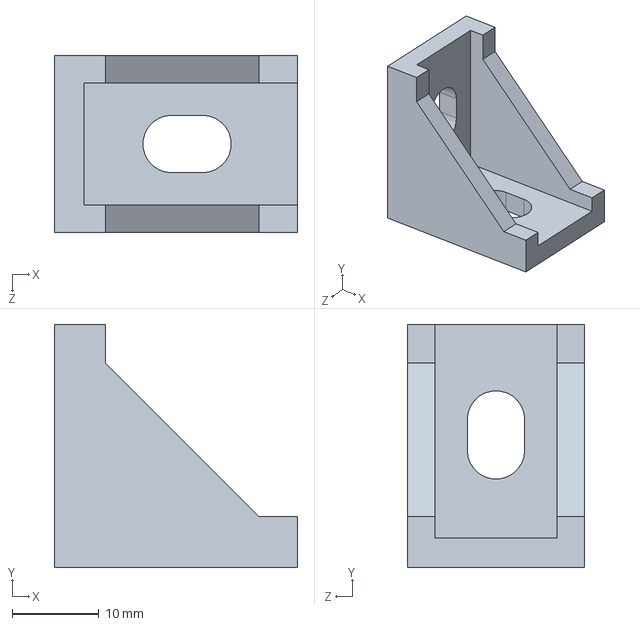
[picture p57: CAD file, 2025-03-14]
Bass Guitar Cad Models/90 Angle 2020 Bracket.SLDPRT
27.9 x 27.9 x 20.3 mm
