Masaharu41/Midi-Bass-Guitar/Bass Guitar Cad Models/STLs/5th Fret Bar.STL

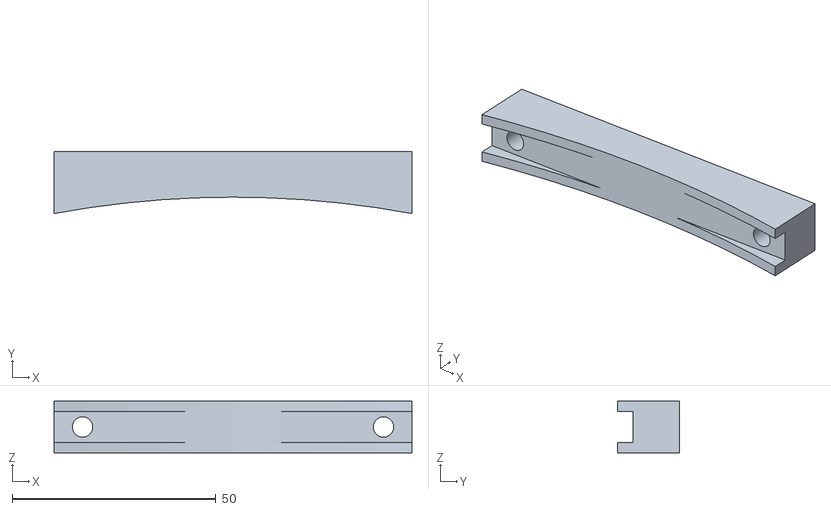
[picture p58: CAD file, 2025-04-30]
Bass Guitar Cad Models/STLs/5th Fret Bar.STL
87.8 x 15.2 x 12.7
