Masaharu41/Midi-Bass-Guitar/Bass Guitar Cad Models/Solenoid Firing pin.SLDPRT

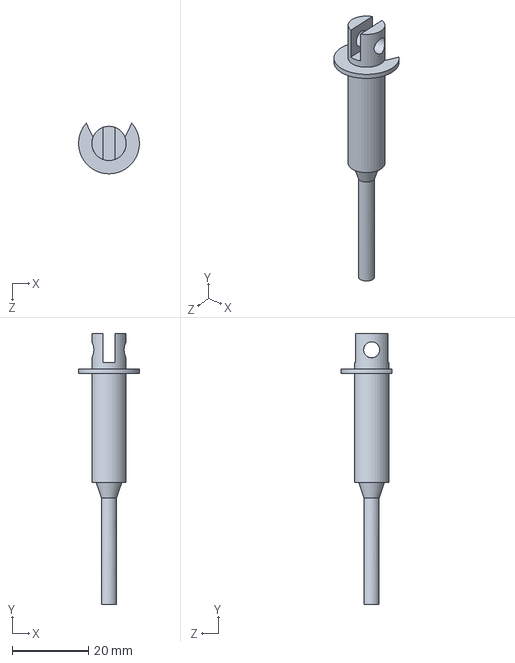
[picture p59: CAD file, 2024-11-15]
Bass Guitar Cad Models/Solenoid Firing pin.SLDPRT
16.0 x 71.1 x 13.3 mm
