Masaharu41/Midi-Bass-Guitar/Bass Guitar Cad Models/25n Solenoid Simple Body.SLDPRT

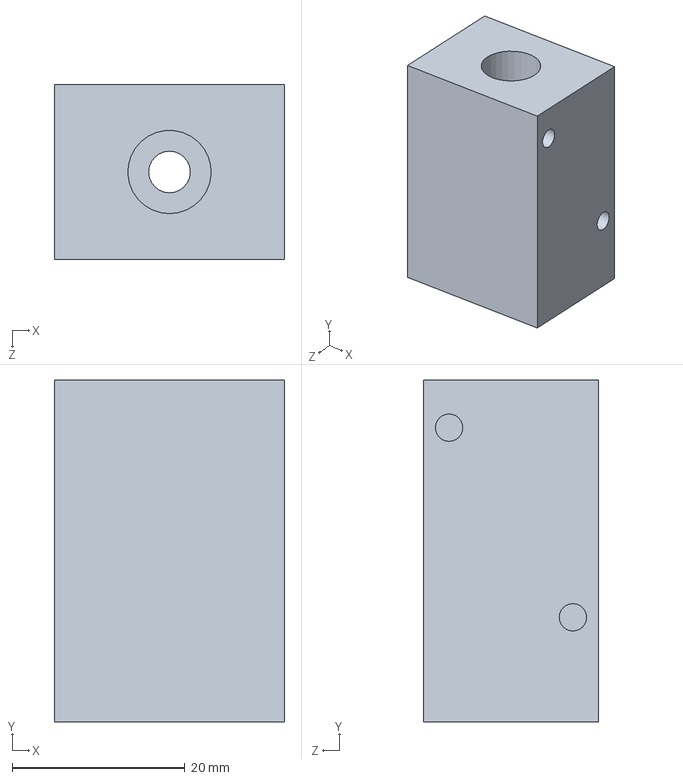
[picture p60: CAD file, 2024-11-15]
Bass Guitar Cad Models/25n Solenoid Simple Body.SLDPRT
26.7 x 39.6 x 20.3 mm
