Masaharu41/Midi-Bass-Guitar/Bass Guitar Cad Models/P-Bass Body.SLDPRT

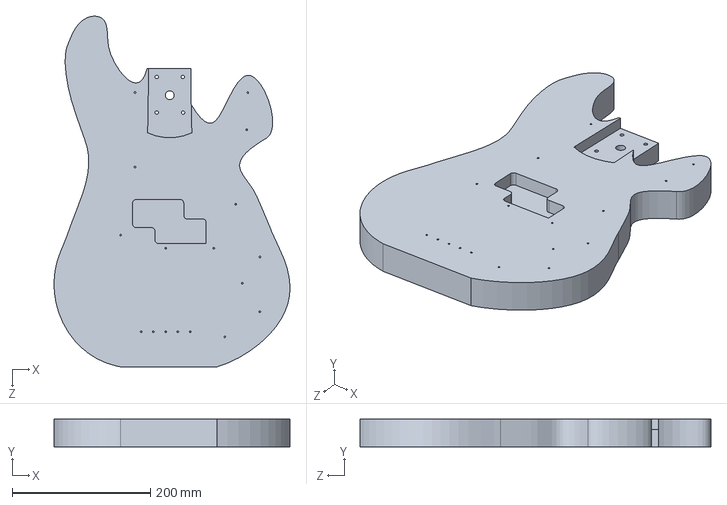
[picture p61: CAD file, 2024-11-14]
Bass Guitar Cad Models/P-Bass Body.SLDPRT
341.8 x 40.0 x 507.9 mm
