Masaharu41/Midi-Bass-Guitar/Bass Guitar Cad Models/P-Bass Neck.SLDPRT

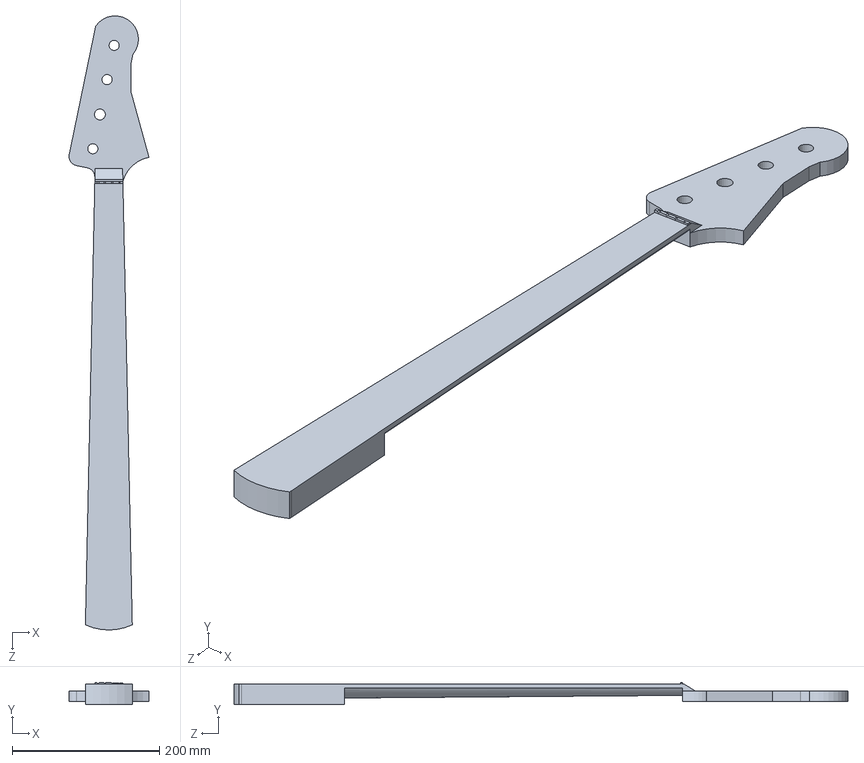
[picture p62: CAD file, 2024-11-12]
Bass Guitar Cad Models/P-Bass Neck.SLDPRT
108.5 x 30.2 x 832.8 mm
