Masaharu41/Midi-Bass-Guitar/Bass Guitar Cad Models/Simplified Bridge.SLDPRT

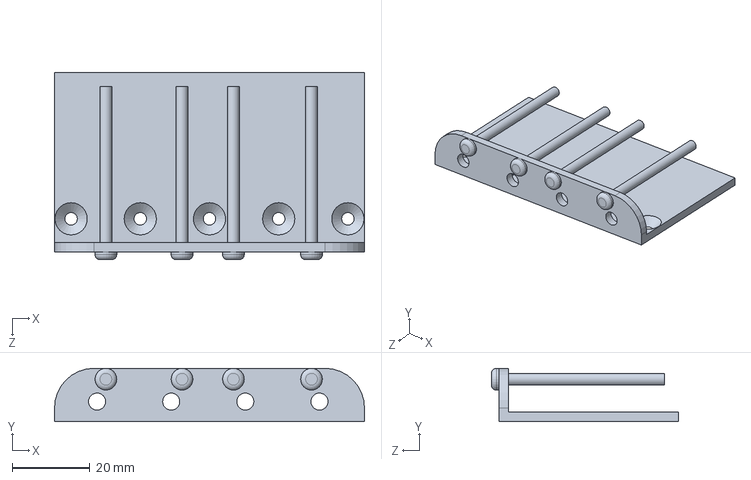
[picture p63: CAD file, 2024-11-12]
Bass Guitar Cad Models/Simplified Bridge.SLDPRT
79.7 x 13.7 x 48.1 mm
