Masaharu41/Midi-Bass-Guitar/Bass Guitar Cad Models/Bridge Saddle.SLDPRT

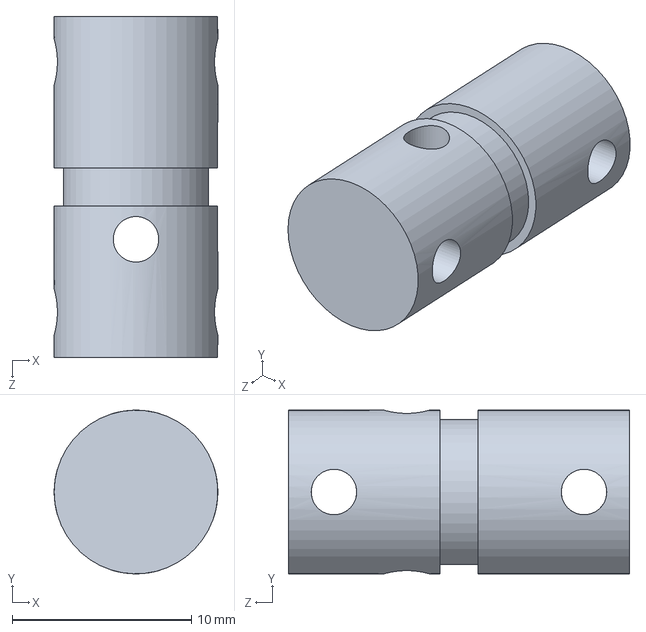
[picture p64: CAD file, 2024-11-11]
Bass Guitar Cad Models/Bridge Saddle.SLDPRT
9.14 x 9.14 x 19.1 mm
