Masaharu41/Midi-Bass-Guitar/(list of files, cad)

Other CAD files:
Bass Guitar Cad Models/STLs/DIN Rail Mounts.STL
Bass Guitar Cad Models/Fret Bars/18th Fret Bar.SLDPRT
Bass Guitar Cad Models/STLs/Fret Board Cage.STL
Bass Guitar Cad Models/Electronics/Solenoid Hori Mount.SLDPRT
Bass Guitar Cad Models/STLs/16th Fret Bar.STL
Bass Guitar Cad Models/STLs/20th Fret Bar.STL
Bass Guitar Cad Models/STLs/18th Fret Bar.STL
Bass Guitar Cad Models/STLs/11th Fret Bar.STL
Bass Guitar Cad Models/Electronics/PCB Standoff.SLDPRT
Bass Guitar Cad Models/STLs/10th Fret Bar.STL
Bass Guitar Cad Models/STLs/12th Fret Bar.STL
Bass Guitar Cad Models/STLs/6th Fret Bar.STL
Bass Guitar Cad Models/Fret Bars/3rd Fret Bar.SLDPRT
Bass Guitar Cad Models/STLs/7th Fret Bar.STL
Bass Guitar Cad Models/STLs/4th Fret Bar.STL
Bass Guitar Cad Models/Small Mounting Bracket D.SLDPRT
Bass Guitar Cad Models/STLs/8th Fret Bar.STL
Bass Guitar Cad Models/STLs/2nd Fret Bar.STL
Bass Guitar Cad Models/STLs/9th Fret Bar.STL
Bass Guitar Cad Models/STLs/First Fret Bar.STL
Bass Guitar Cad Models/STLs/Bass Mount.STL
Bass Guitar Cad Models/Drawings/2020 Extrusion 970mm Drawing.SLDDRW
Bass Guitar Cad Models/Drawings/2020 Extrusion Short Drawing.SLDDRW
Bass Guitar Cad Models/Drawings/25n Solenoid Simple Body Drawing.SLDDRW
Bass Guitar Cad Models/Drawings/4n Solenoid Body Drawing.SLDDRW
Bass Guitar Cad Models/Drawings/4n Solenoid Pin Drawings.SLDDRW
Bass Guitar Cad Models/Drawings/Bass Mount Drawing.SLDDRW
Bass Guitar Cad Models/Drawings/Bottom Support Bracket Drawing.SLDDRW
Bass Guitar Cad Models/Drawings/Bridge Saddle Drawing.SLDDRW
Bass Guitar Cad Models/Drawings/Muting Bracket Drawing.SLDDRW
Bass Guitar Cad Models/Drawings/Neck Support Brace Drawing.SLDDRW
Bass Guitar Cad Models/Drawings/P-Bass Body Drawing.SLDDRW
Bass Guitar Cad Models/Drawings/P-Bass Neck Drawing.SLDDRW
Bass Guitar Cad Models/Drawings/Pick Guard Drawing.SLDDRW
Bass Guitar Cad Models/Drawings/Simplified Bridge Drawing.SLDDRW
Bass Guitar Cad Models/Drawings/Small Mounting Bracket Drawing.SLDDRW
Bass Guitar Cad Models/Drawings/Solenoid 2020 Mount Drawing.SLDDRW
Bass Guitar Cad Models/Drawings/Solenoid Firing pin Drawing.SLDDRW
Bass Guitar Cad Models/Drawings/Top Cross Support Drawing.SLDDRW
Bass Guitar Cad Models/STLs/90 Angle 2020 Bracket.STL
Bass Guitar Cad Models/STLs/Bottom Support Bracket.STL
Bass Guitar Cad Models/STLs/Muting Bracket.STL
Bass Guitar Cad Models/STLs/Muting Finger.STL
Bass Guitar Cad Models/STLs/Neck Support Brace.STL
Bass Guitar Cad Models/STLs/Small Mounting Bracket A.STL
Bass Guitar Cad Models/STLs/Small Mounting Bracket D.STL
Bass Guitar Cad Models/STLs/Small Mounting Bracket G.STL
Bass Guitar Cad Models/STLs/Small Mounting Bracket.STL
Bass Guitar Cad Models/STLs/Solenoid 2020 Mount.STL
Bass Guitar Cad Models/STLs/Top Cross Support.STL
