Masaharu41/Midi-Bass-Guitar/Images/High Level Troubleshooting.png

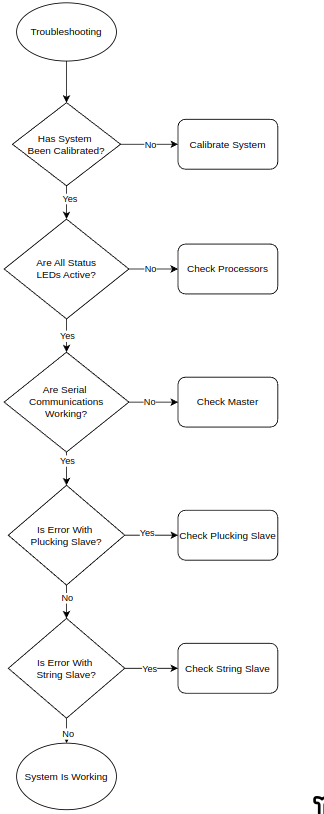
Images/High Level Troubleshooting.png
