Masaharu41/Midi-Bass-Guitar/Images/Processor Troubleshooting.png

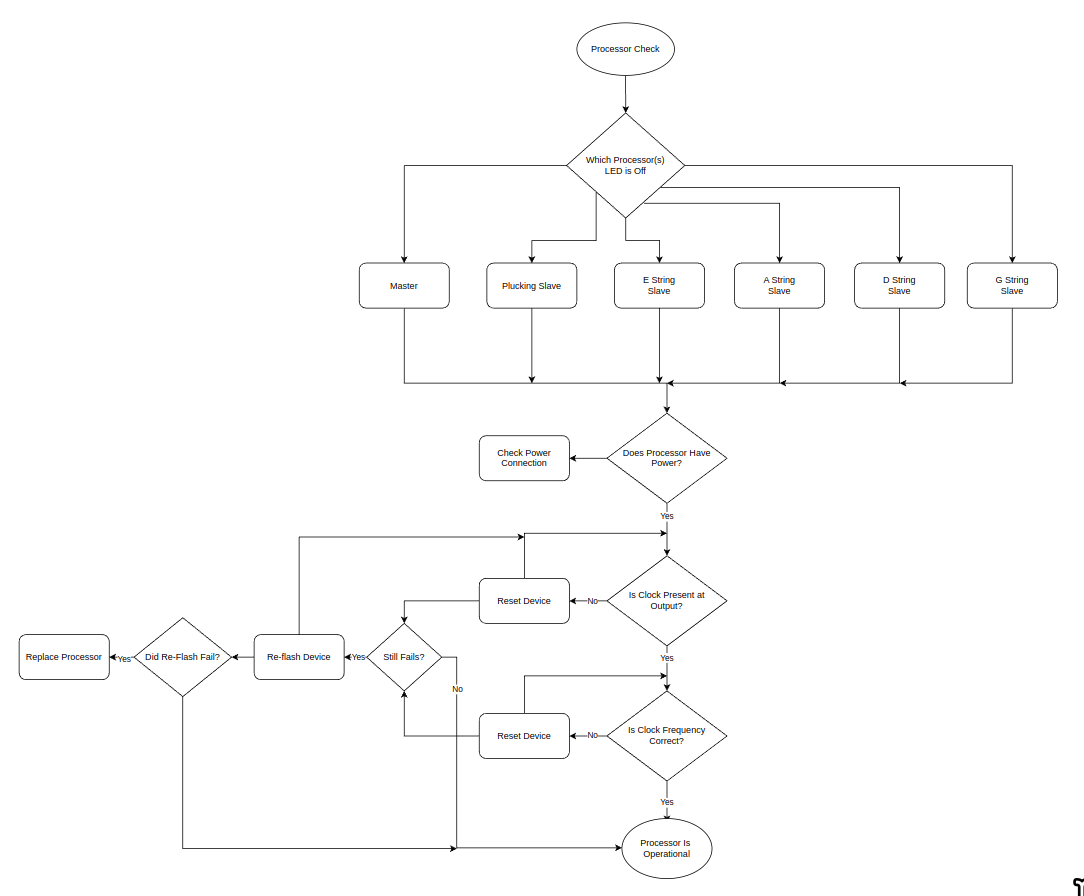
Images/Processor Troubleshooting.png
