Masaharu41/Midi-Bass-Guitar/Images/Serial Troubleshooting.png

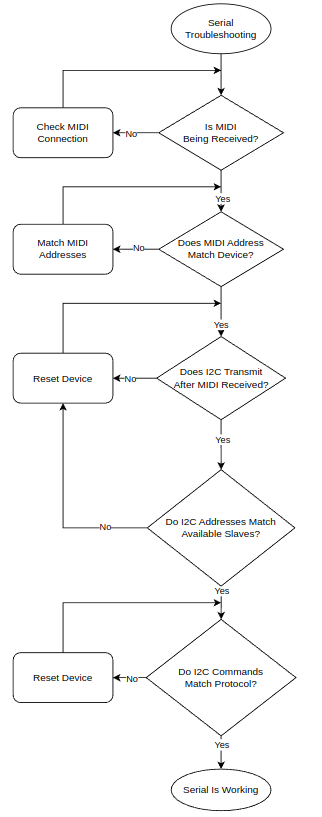
Images/Serial Troubleshooting.png
