Masaharu41/Midi-Bass-Guitar/Images/String Unit Troubleshooting.png

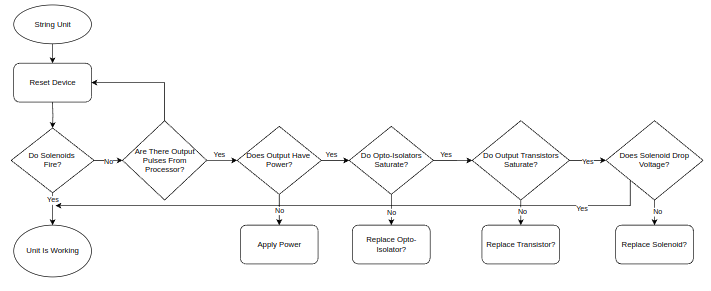
Images/String Unit Troubleshooting.png
