Masaharu41/Midi-Bass-Guitar/Bass Guitar Cad Models/Drawing PDFs/4n Solenoid Pin Drawings.pdf

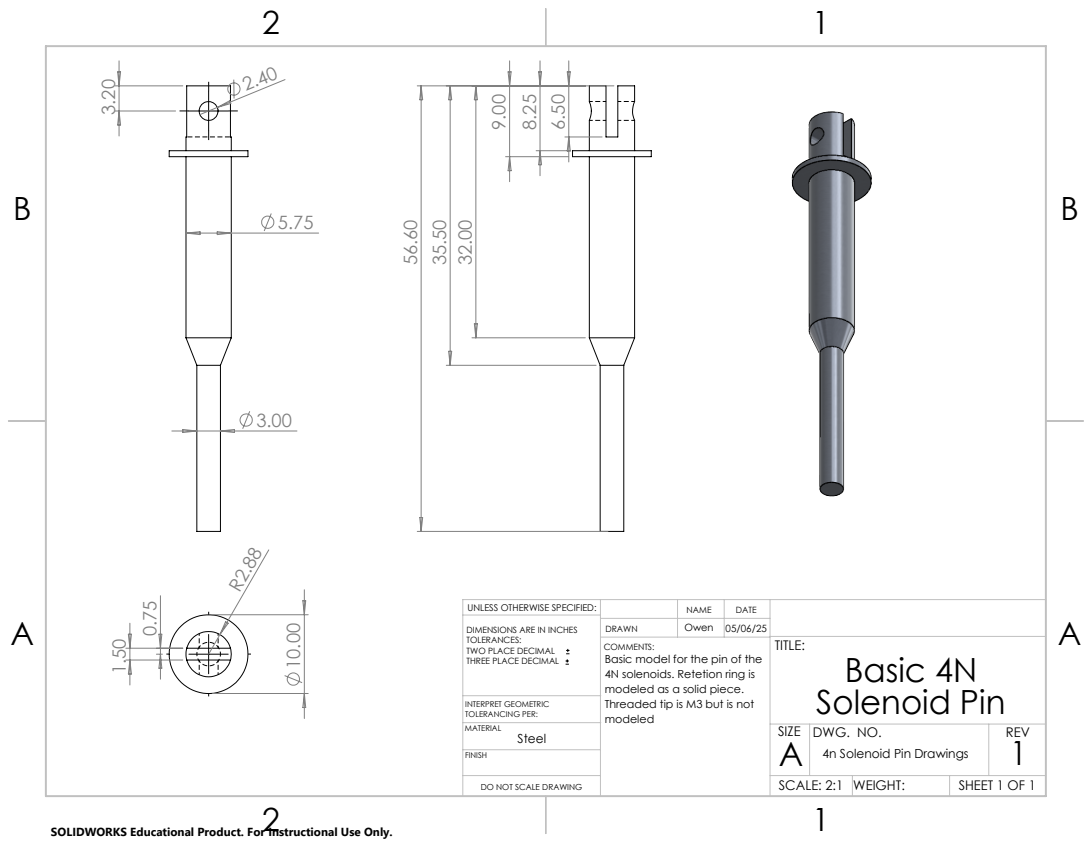
[picture p73: page 1]
SHEET 1 OF 1; SCALE: 2:1; WEIGHT:; INTERPRET GEOMETRIC TOLERANCING PER:

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

COMMENTS: Basic model for the pin of the 4N solenoids. Retetion ring is modeled as a solid piece. Threaded tip is M3 but is not modeled | | | TITLE: Basic 4N Solenoid Pin

MATERIAL Steel | | SIZE A | DWG. NO. 4n Solenoid Pin Drawings | REV 1

DO NOT SCALE DRAWING

SOLIDWORKS Educational Product. For Instructional Use Only.
