Masaharu41/Midi-Bass-Guitar/Bass Guitar Cad Models/Drawing PDFs/Top Cross Support Drawing.pdf

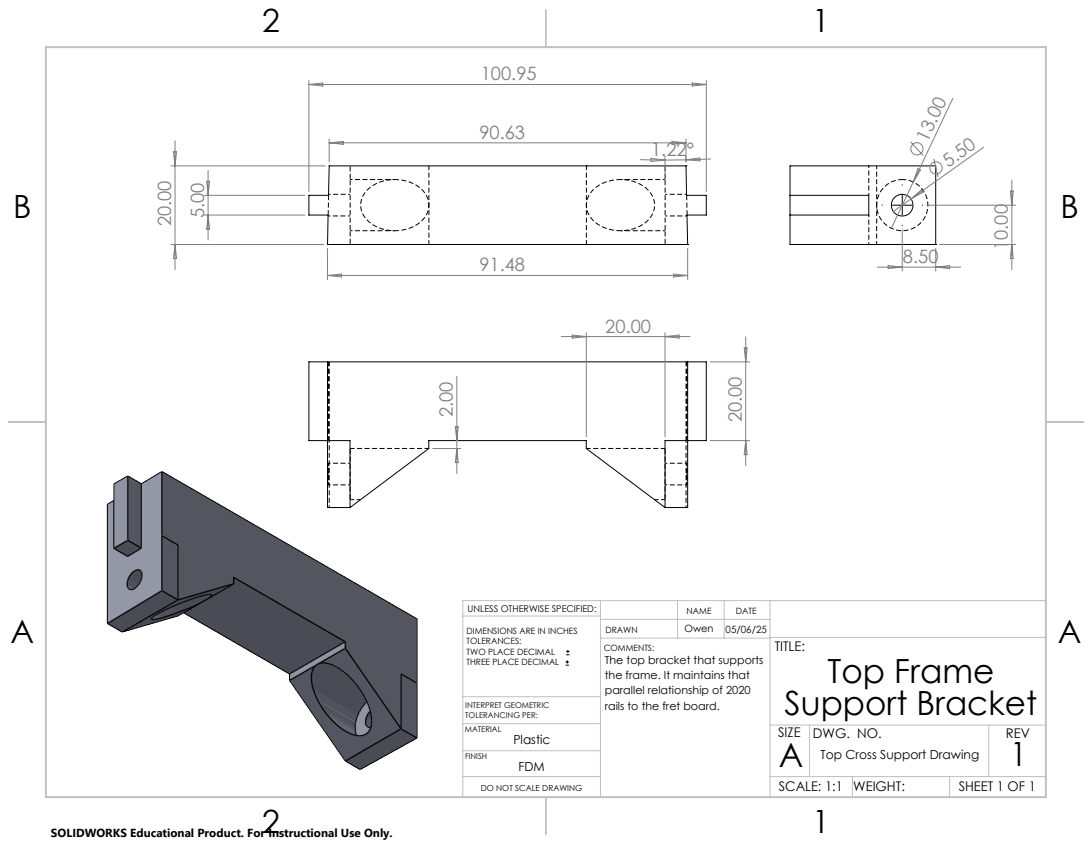
[picture p74: page 1]
SHEET 1 OF 1; SCALE: 1:1; WEIGHT:; FDM FINISH; INTERPRET GEOMETRIC TOLERANCING PER:

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

COMMENTS: The top bracket that supports the frame. It maintains that parallel relationship of 2020 rails to the fret board. | | | TITLE: Top Frame Support Bracket

MATERIAL Plastic | | SIZE A | DWG. NO. Top Cross Support Drawing | REV 1

DO NOT SCALE DRAWING

SOLIDWORKS Educational Product. For Instructional Use Only.
