Masaharu41/Midi-Bass-Guitar/Bass Guitar Cad Models/Drawing PDFs/Muting Bracket Drawing.pdf

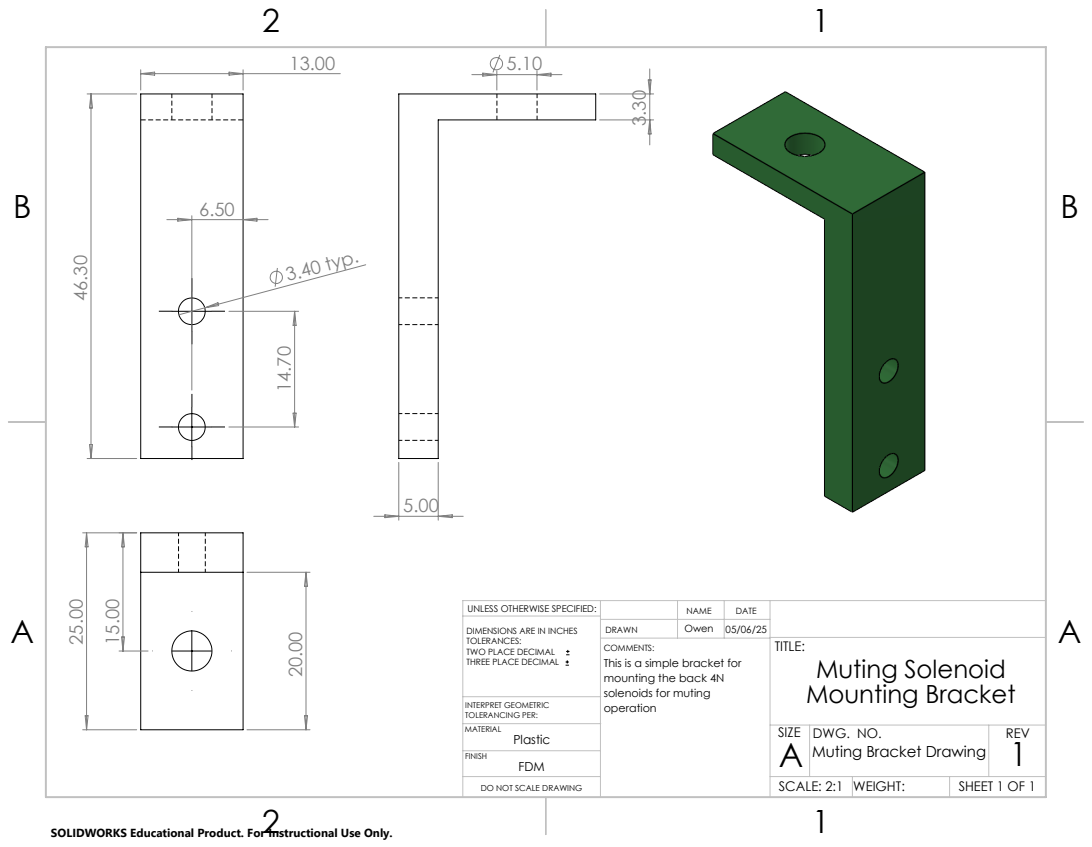
[picture p75: page 1]
3.40 typ.; SHEET 1 OF 1; SCALE: 2:1; WEIGHT:; FDM FINISH; INTERPRET GEOMETRIC TOLERANCING PER:

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

COMMENTS: This is a simple bracket for mounting the back 4N solenoids for muting operation | | | TITLE: Muting Solenoid Mounting Bracket

MATERIAL Plastic | | SIZE A | DWG. NO. Muting Bracket Drawing | REV 1

DO NOT SCALE DRAWING

SOLIDWORKS Educational Product. For Instructional Use Only.
