Masaharu41/Midi-Bass-Guitar/Bass Guitar Cad Models/Drawing PDFs/25n Solenoid Simple Body Drawing.pdf

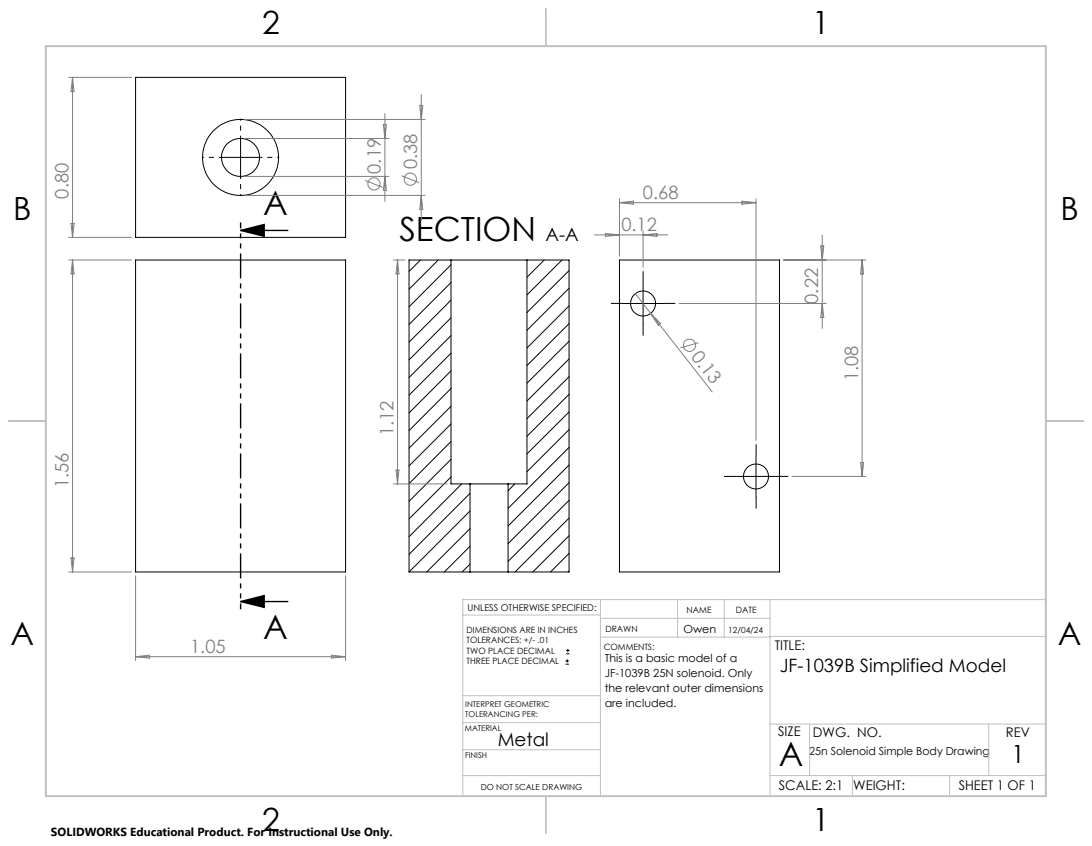
[picture p77: page 1]
SECTION A-A; SHEET 1 OF 1; SCALE: 2:1; WEIGHT:; INTERPRET GEOMETRIC TOLERANCING PER:

UNLESS OTHERWISE SPECIFIED:

DIMENSIONS ARE IN INCHES TOLERANCES: +/- .01 TWO PLACE DECIMAL THREE PLACE DECIMAL | DRAWN | Owen | 12/04/24

COMMENTS: This is a basic model of a JF-1039B 25N solenoid. Only the relevant outer dimensions are included. | TITLE: JF-1039B Simplified Model

MATERIAL Metal | | SIZE A | DWG. NO. 25n Solenoid Simple Body Drawing | REV 1

DO NOT SCALE DRAWING

SOLIDWORKS Educational Product. For Instructional Use Only.
