Masaharu41/Midi-Bass-Guitar/Solenoid Breakout Board/PCB Sheet.pdf

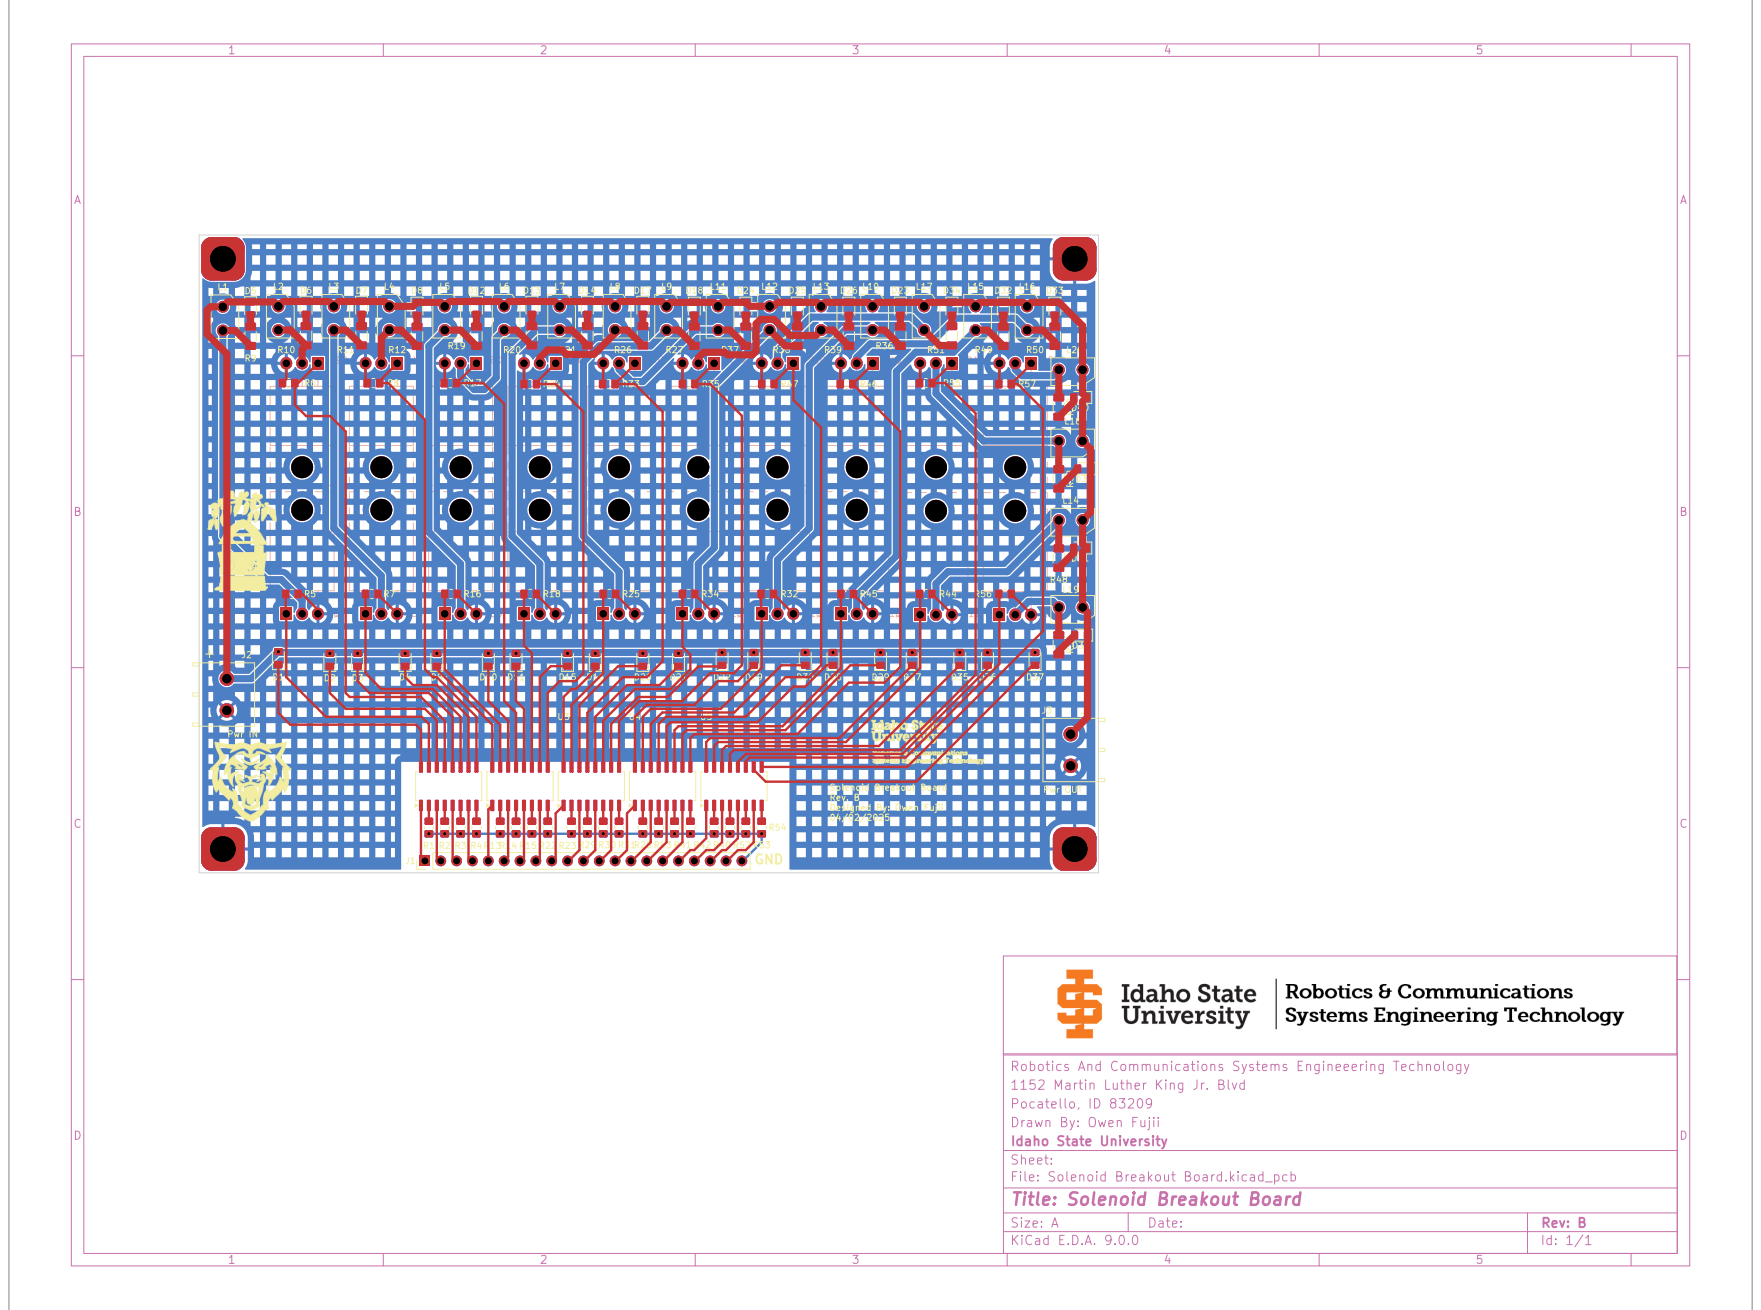
[picture p82: page 1]
