Masaharu41/Midi-Bass-Guitar/Solenoid Breakout Board/Breakout P1.pdf

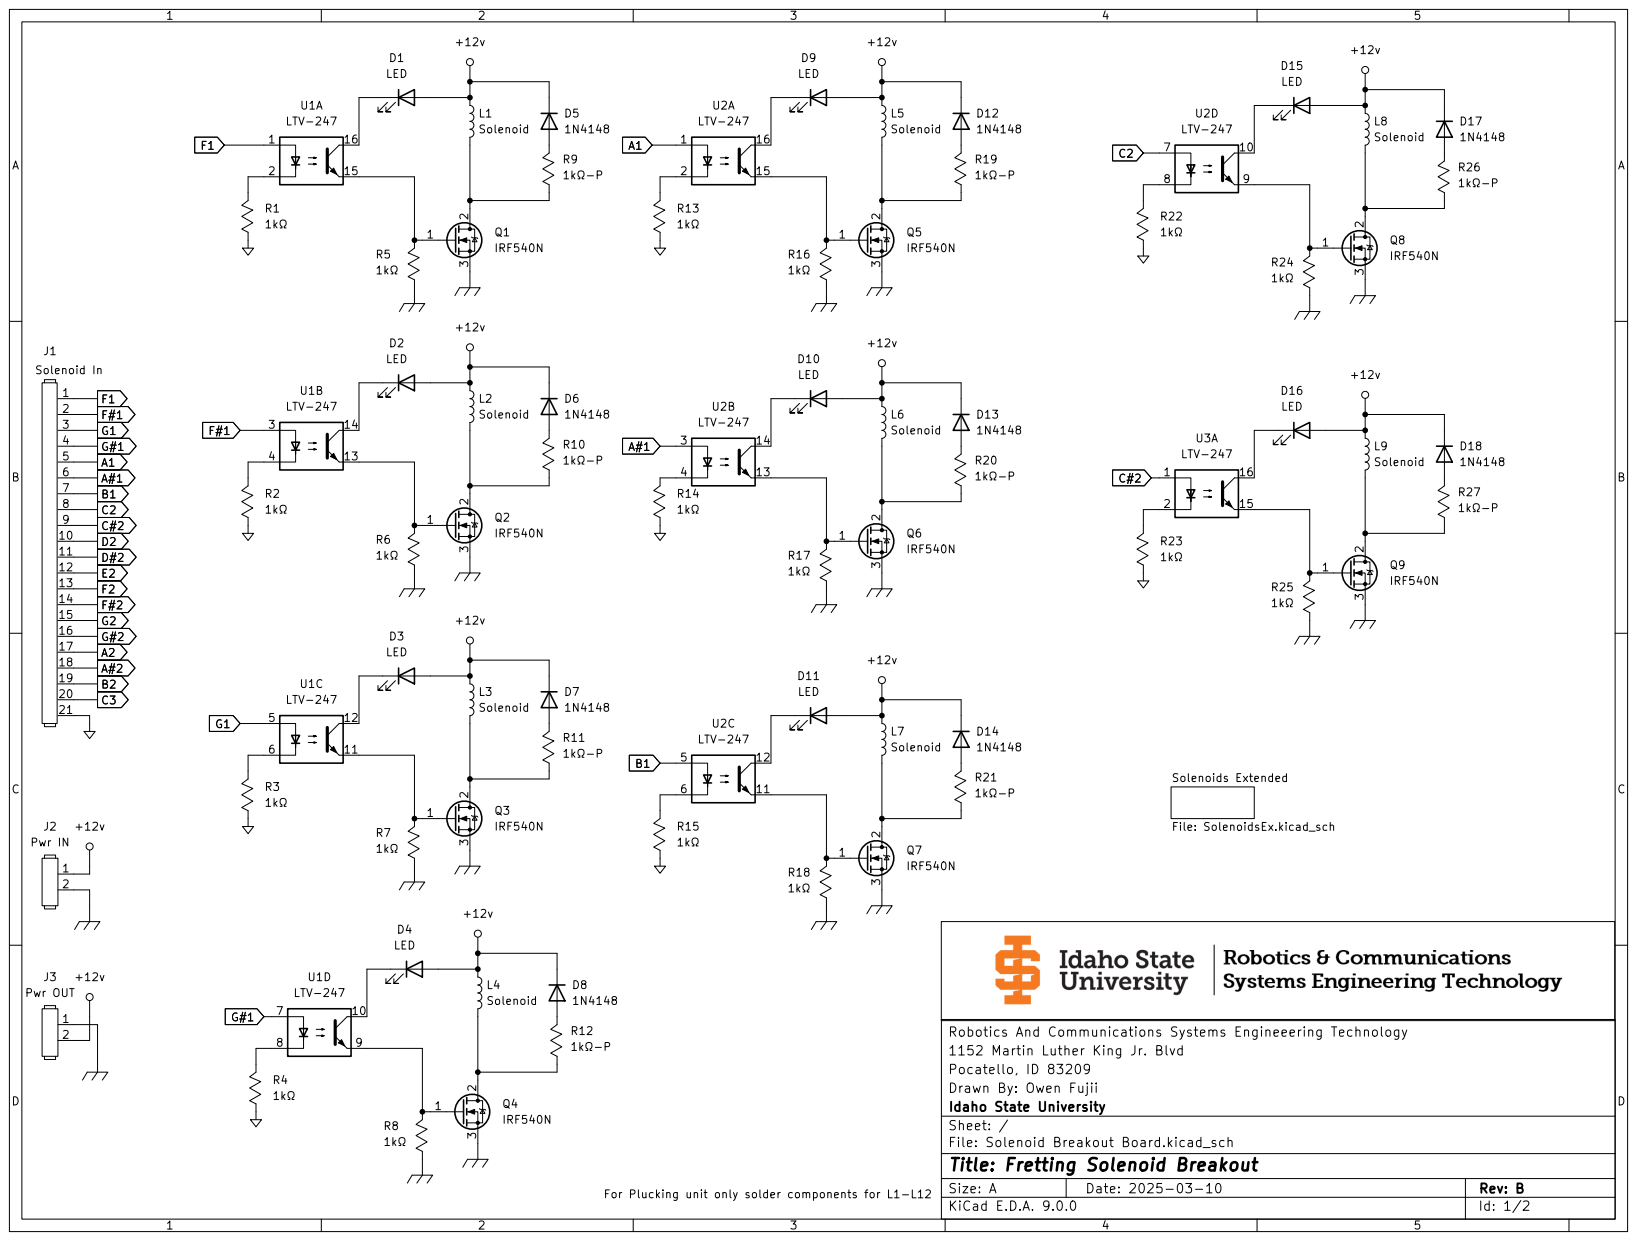
[picture p83: page 1]
