Masaharu41/Midi-Bass-Guitar/Solenoid Breakout Board/Breakout P2.pdf

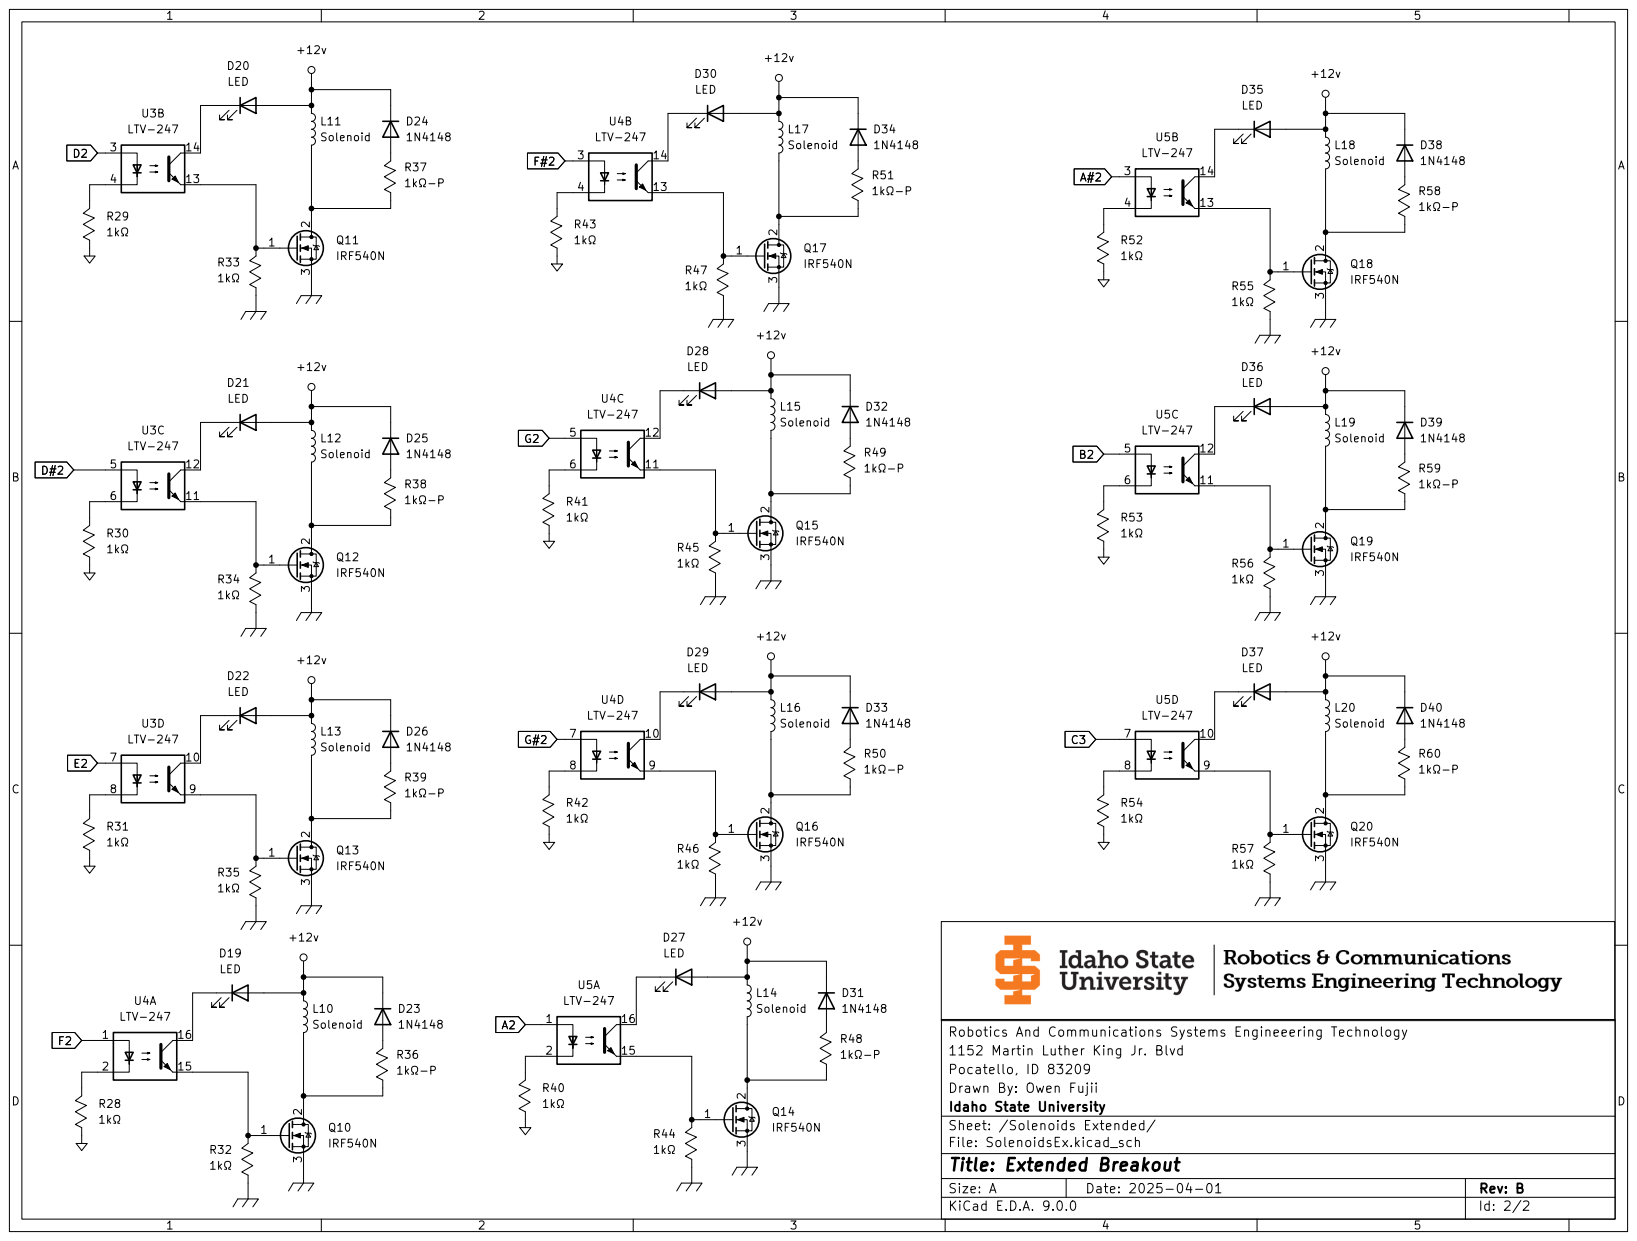
[picture p84: page 1]
