Masaharu41/Midi-Bass-Guitar/Small Unit Breakout/Small Breakout.pdf

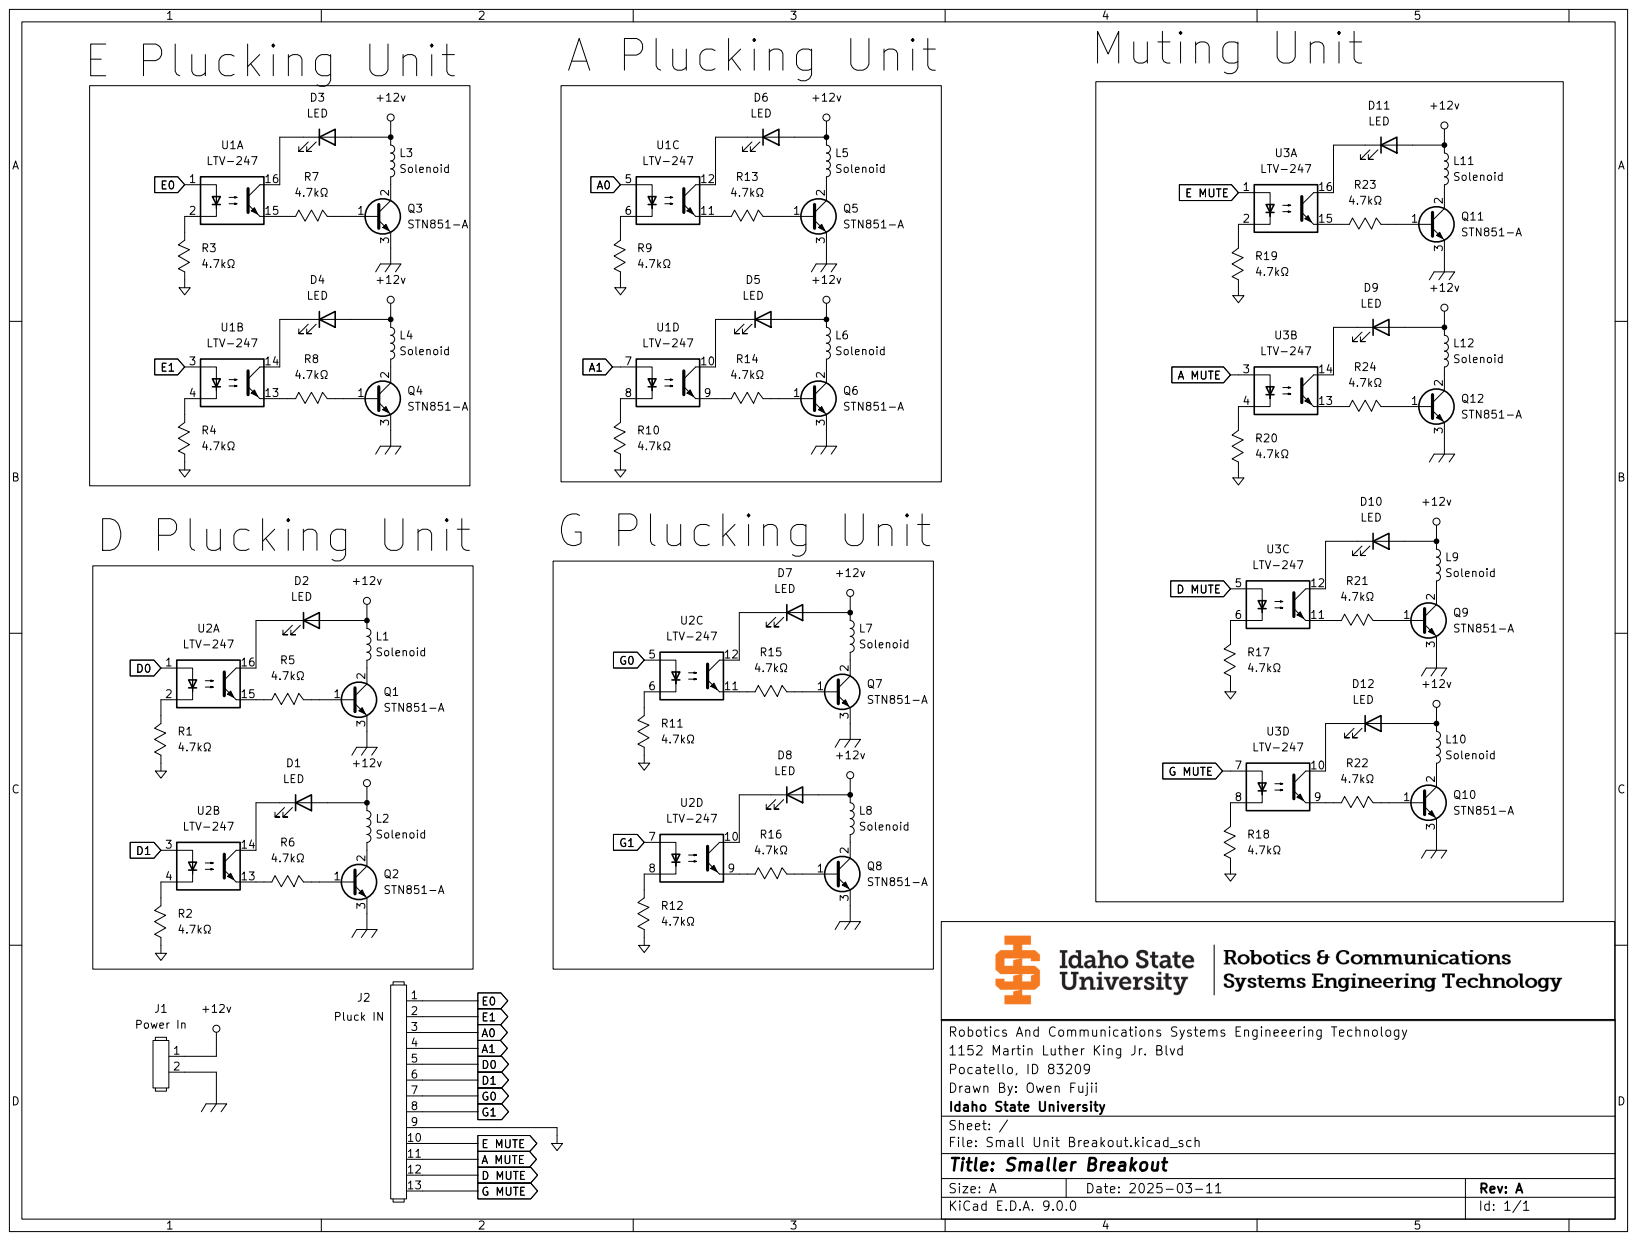
[picture p85: page 1]
