Masaharu41/Midi-Bass-Guitar/Solenoid Breakout Board/Single Slave Out.pdf

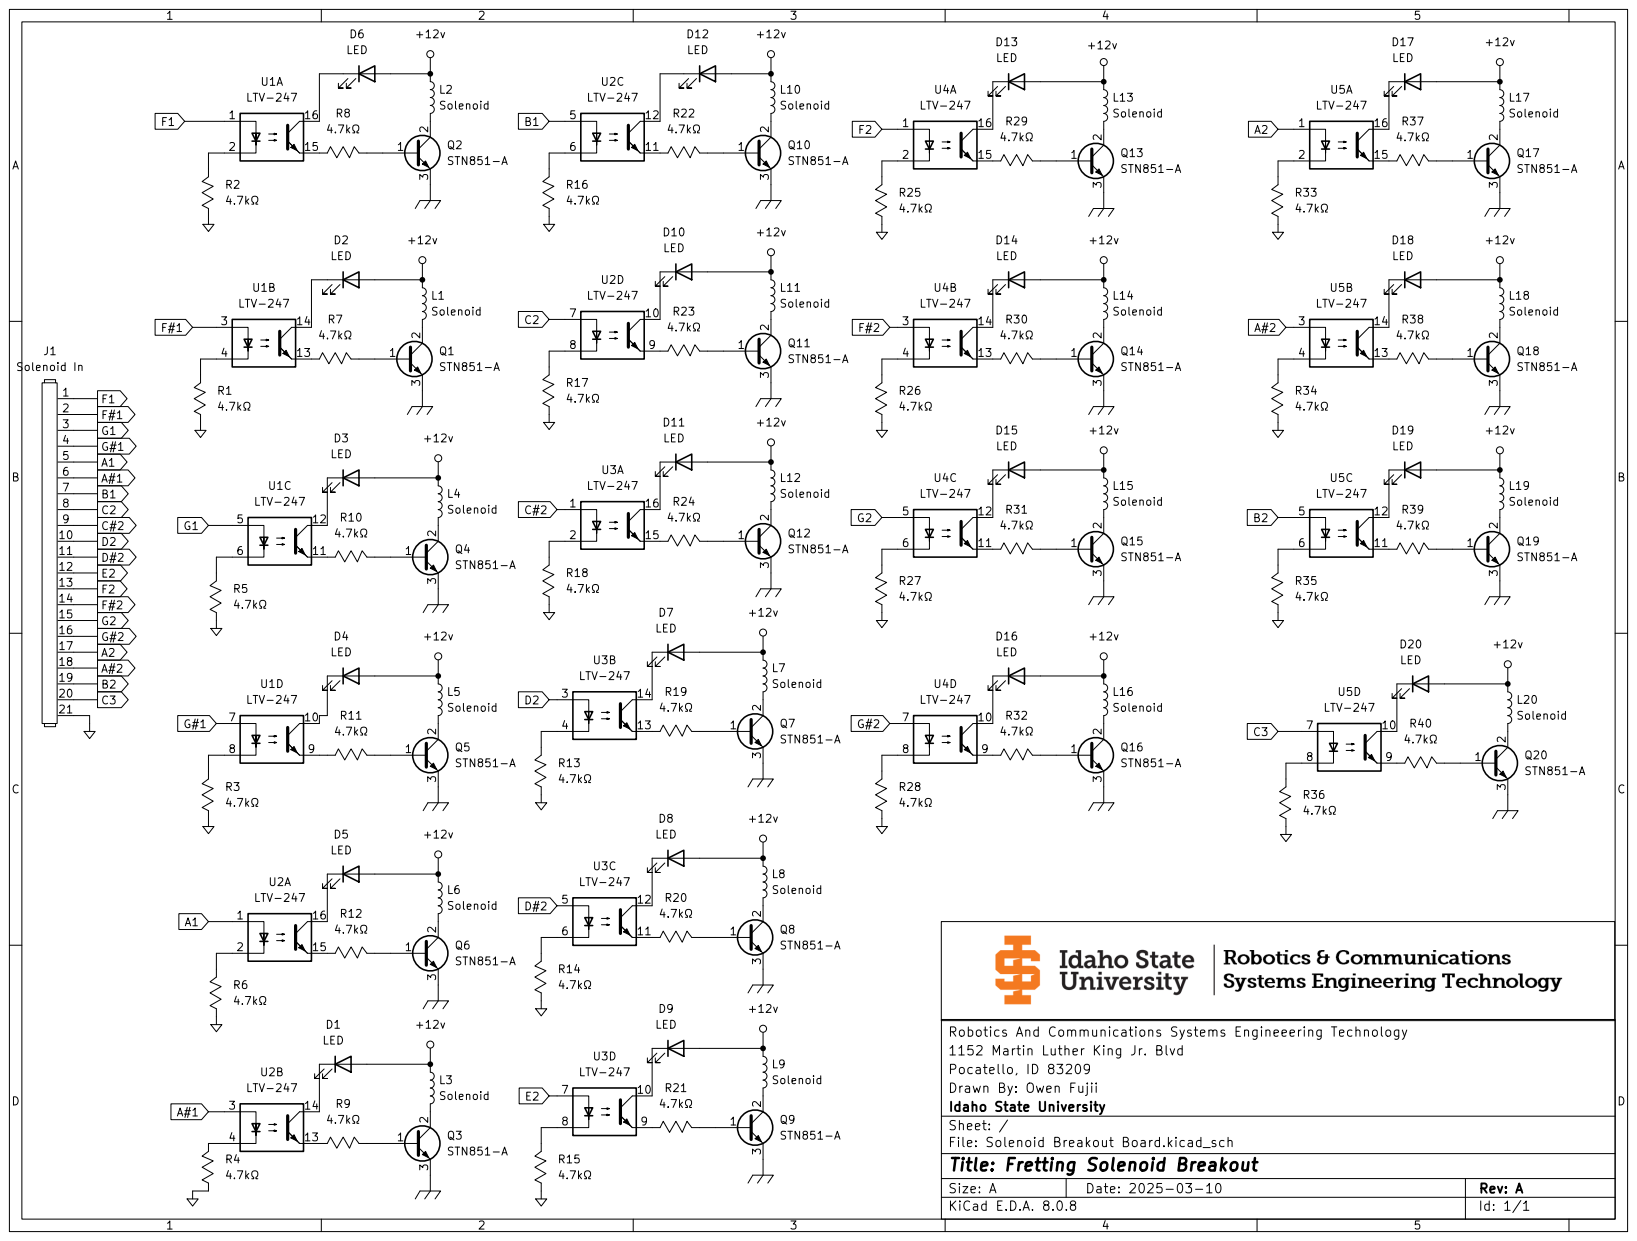
[picture p86: page 1]
