Masaharu41/Midi-Bass-Guitar/Motherboard Sch/Single Pages/Cover Page.pdf

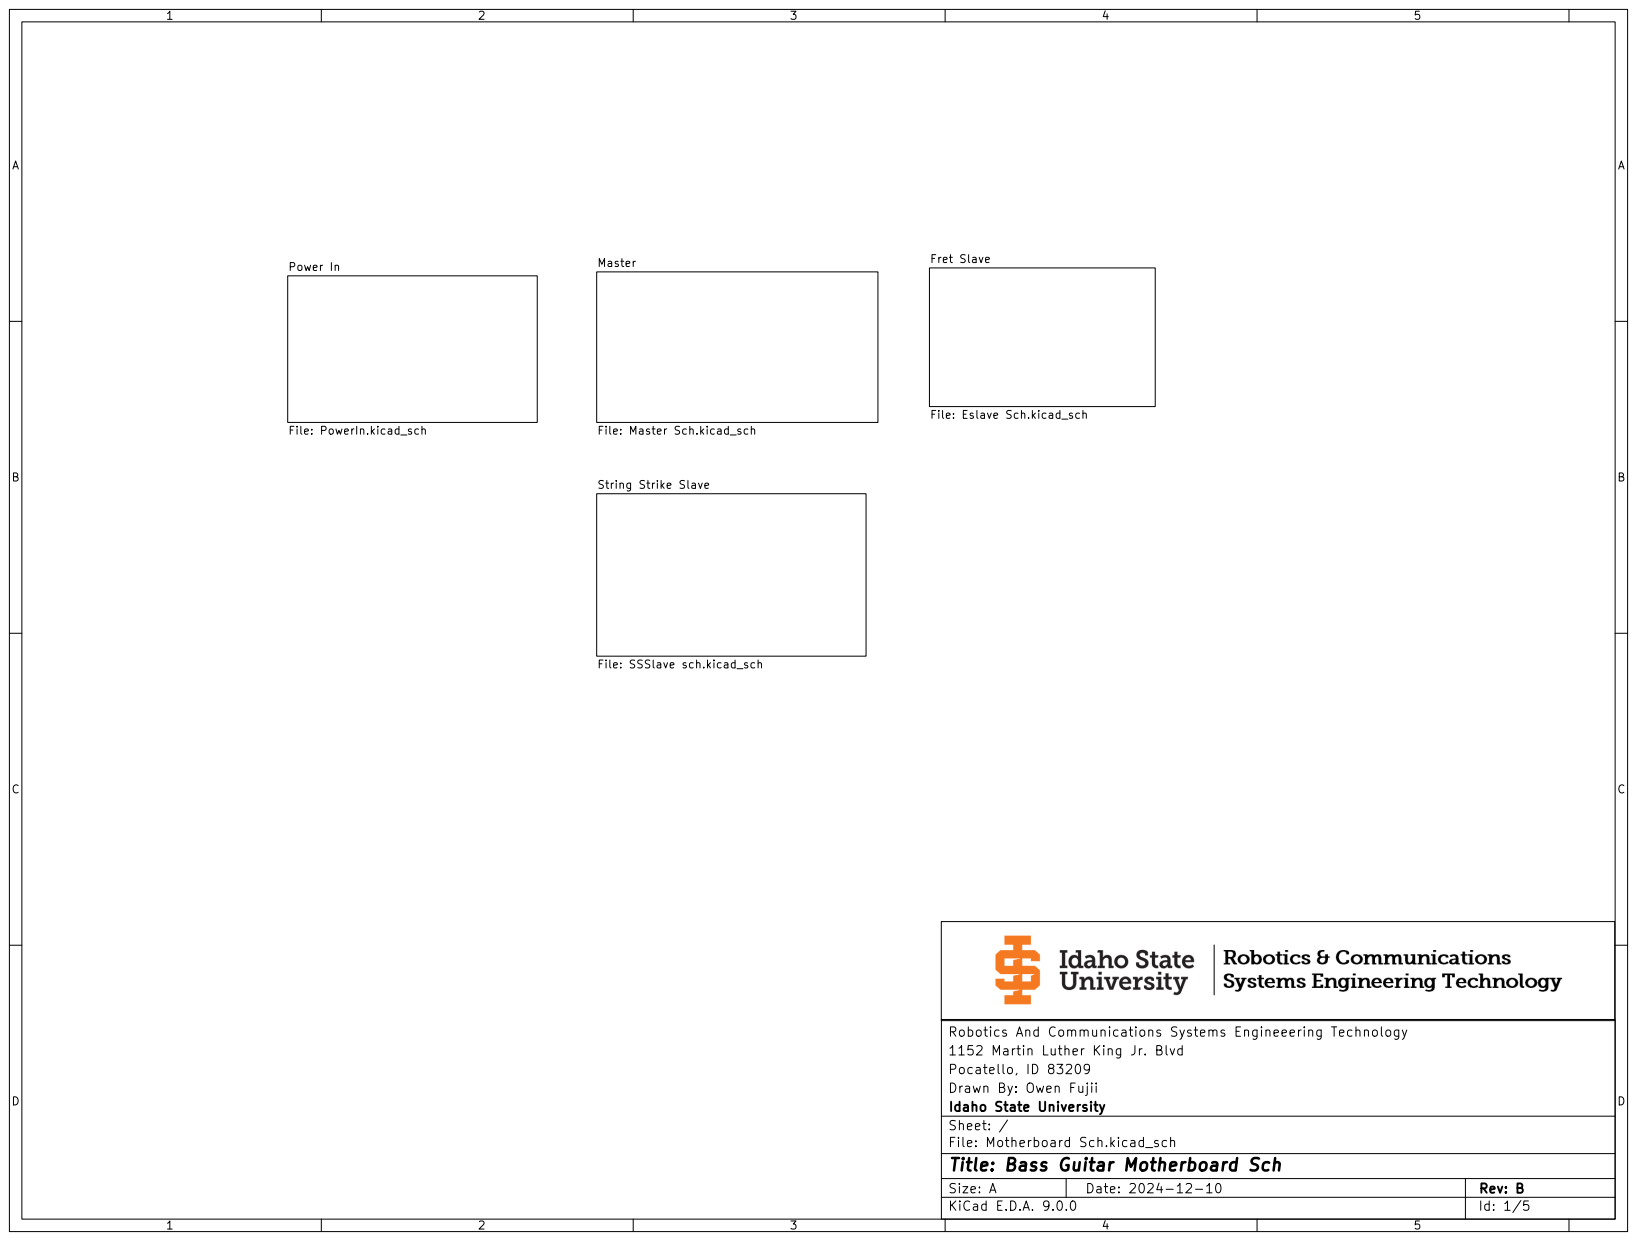
[picture p87: page 1]
