Masaharu41/Midi-Bass-Guitar/Motherboard Sch/Single Pages/Fret Sch.pdf

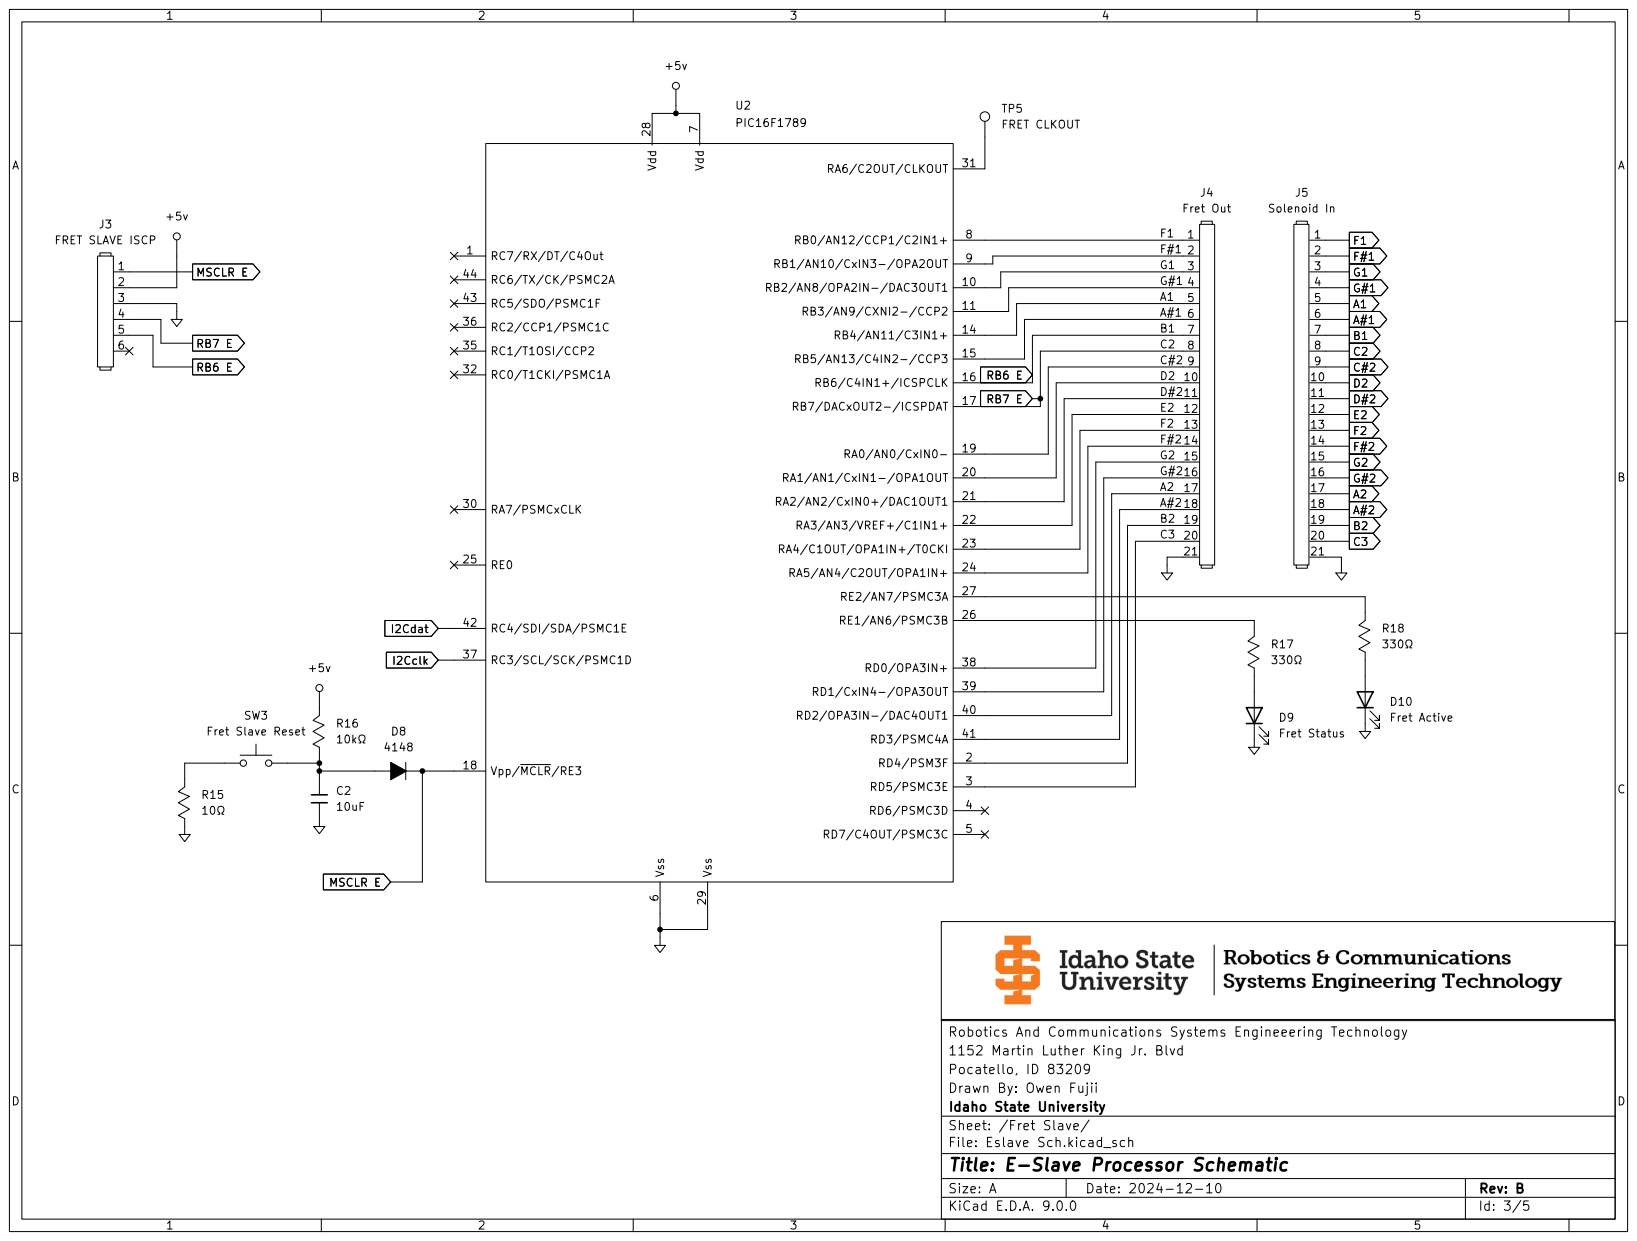
[picture p88: page 1]
