Masaharu41/Midi-Bass-Guitar/Motherboard Sch/Single Pages/Master Sch.pdf

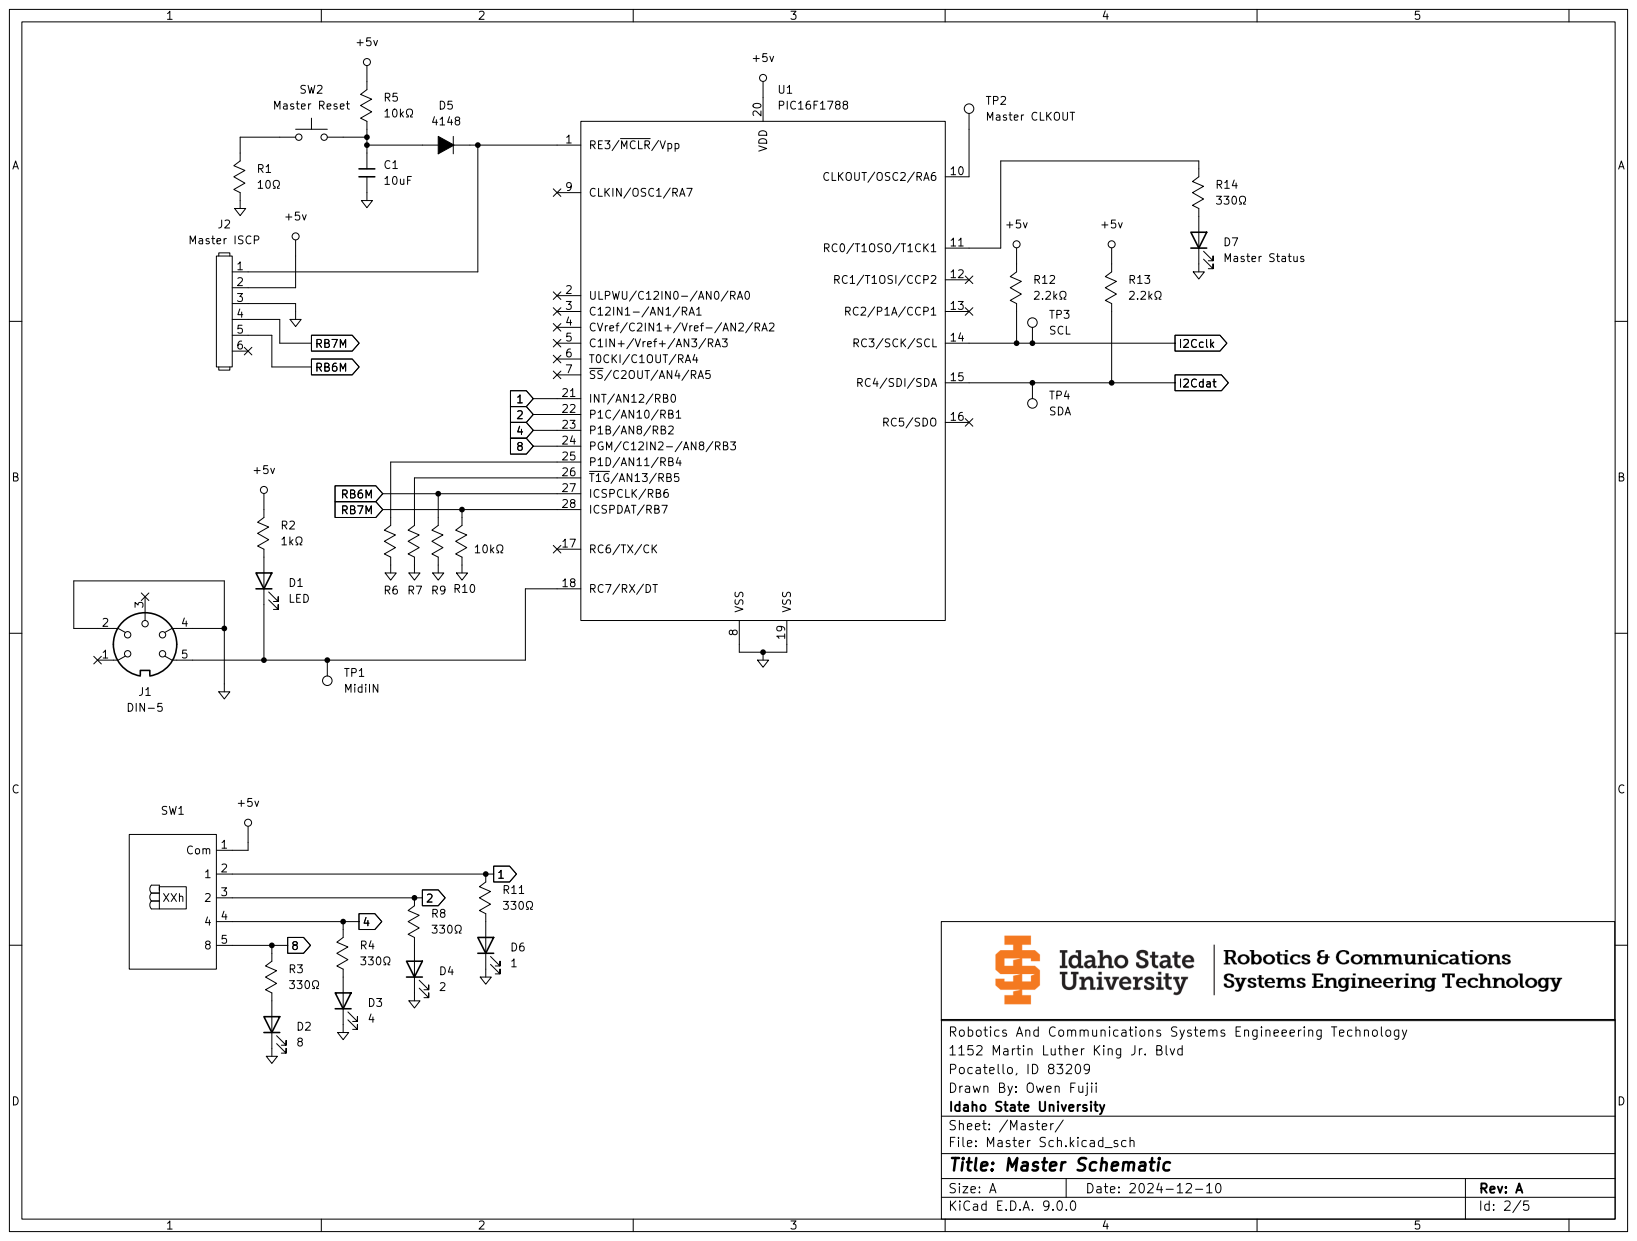
[picture p89: page 1]
