Masaharu41/Midi-Bass-Guitar/Motherboard Sch/Single Pages/Pluck Sch.pdf

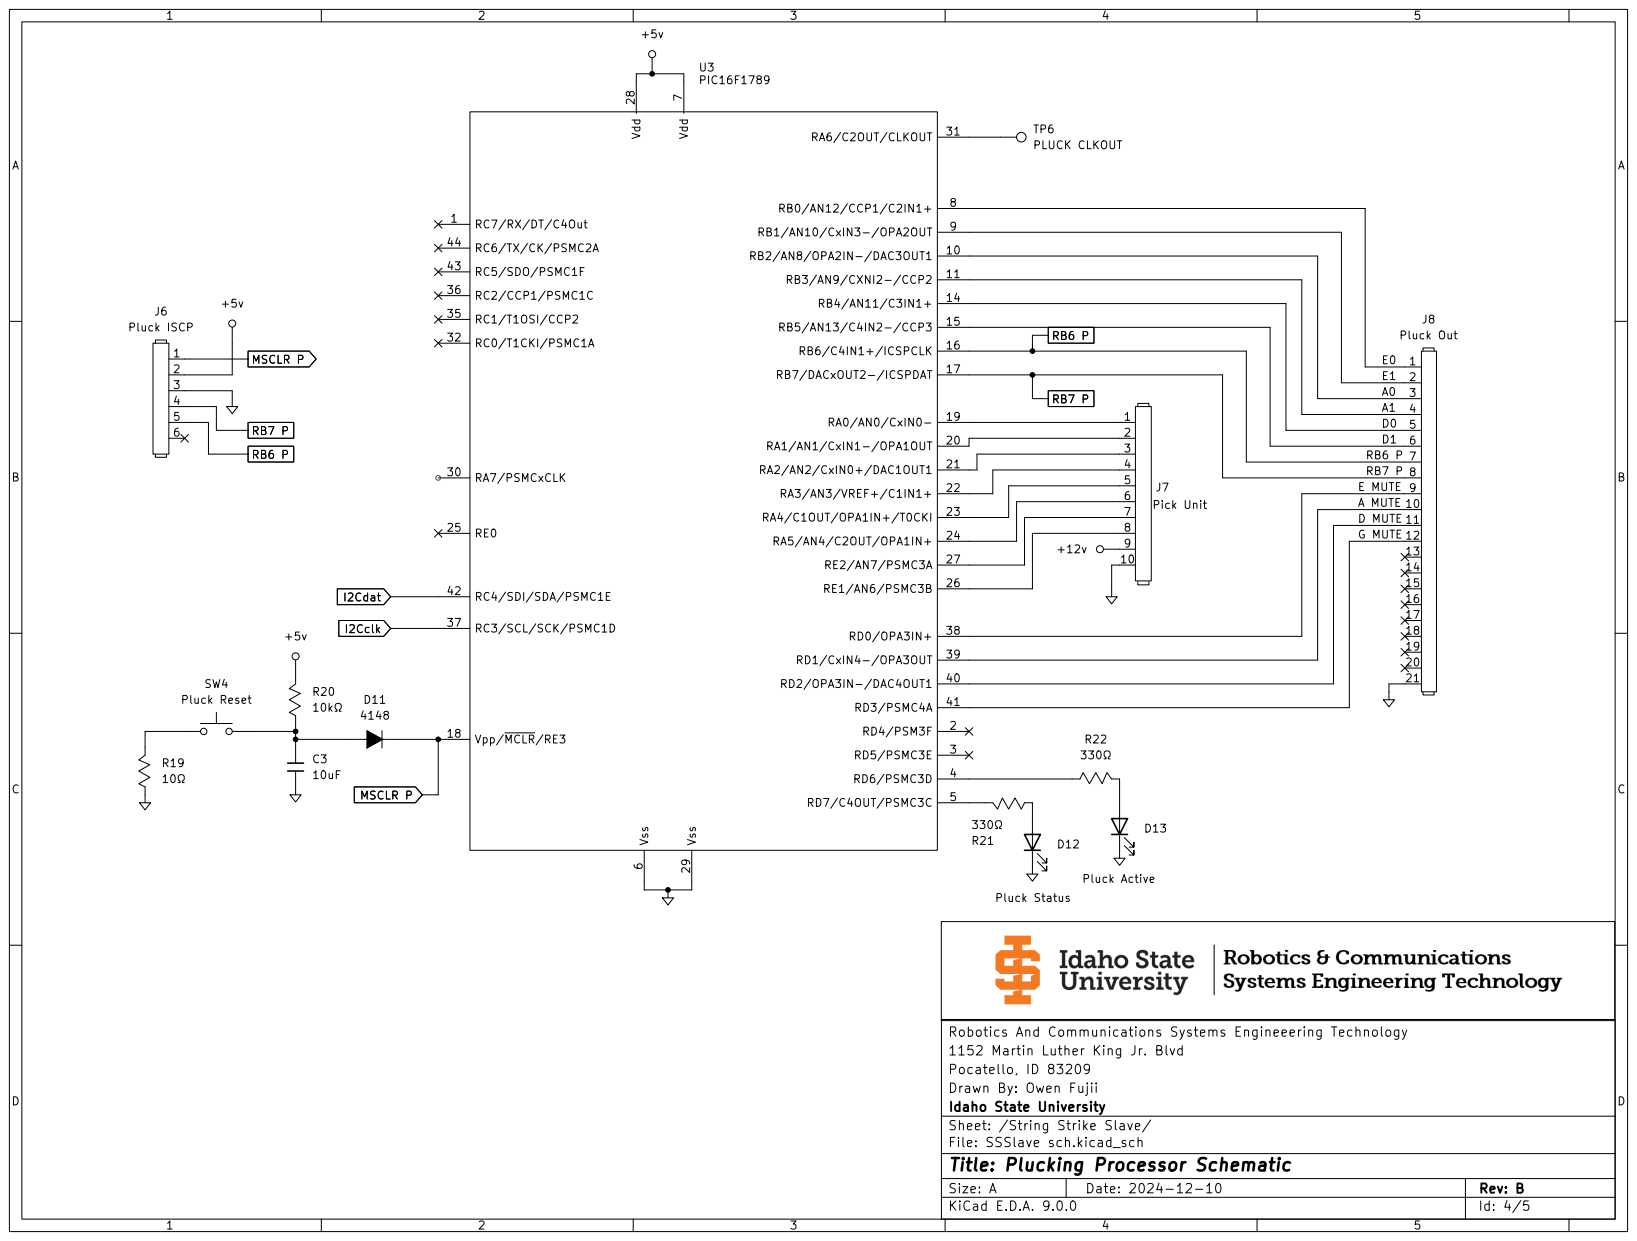
[picture p90: page 1]
