Masaharu41/Midi-Bass-Guitar/Motherboard Sch/Single Pages/Power Sch.pdf

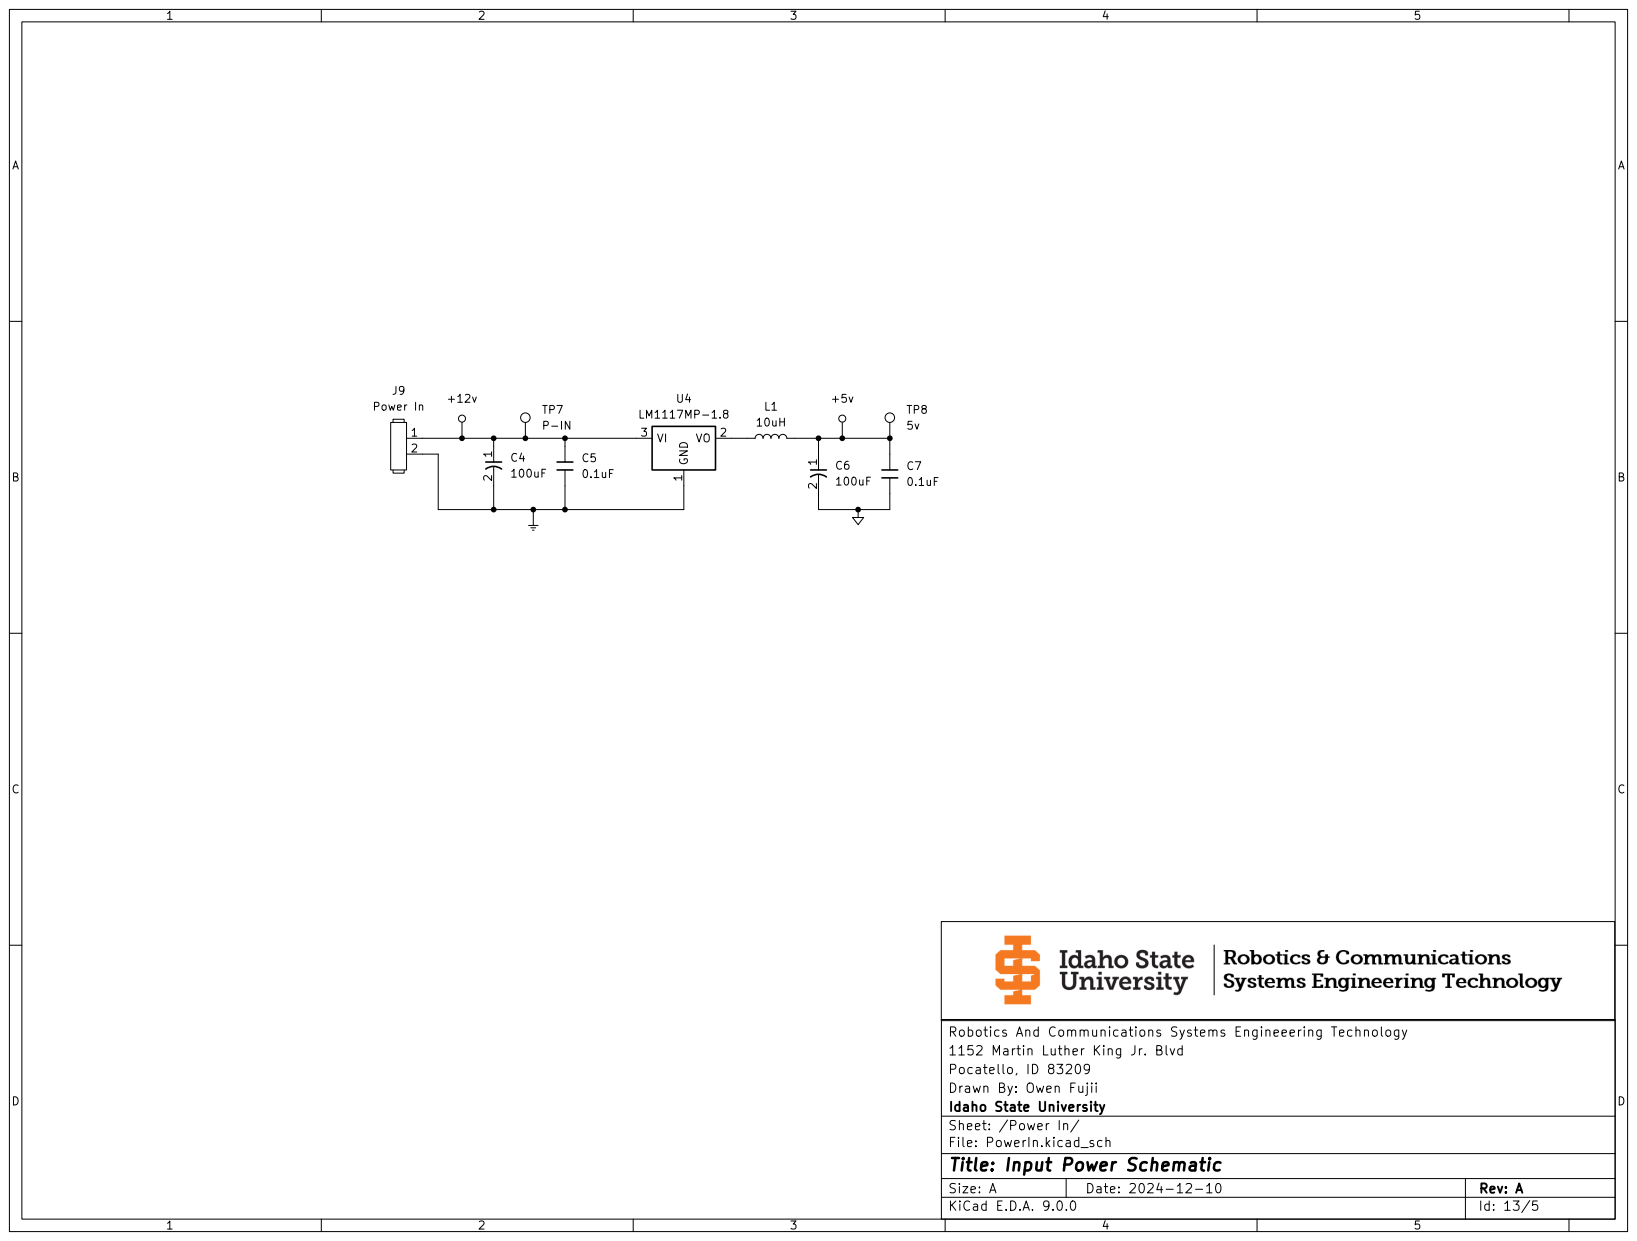
[picture p91: page 1]
