Masaharu41/Midi-Bass-Guitar/IR_MIDI/Midi_IR_Rx/IR_MIDI_Rx.pdf

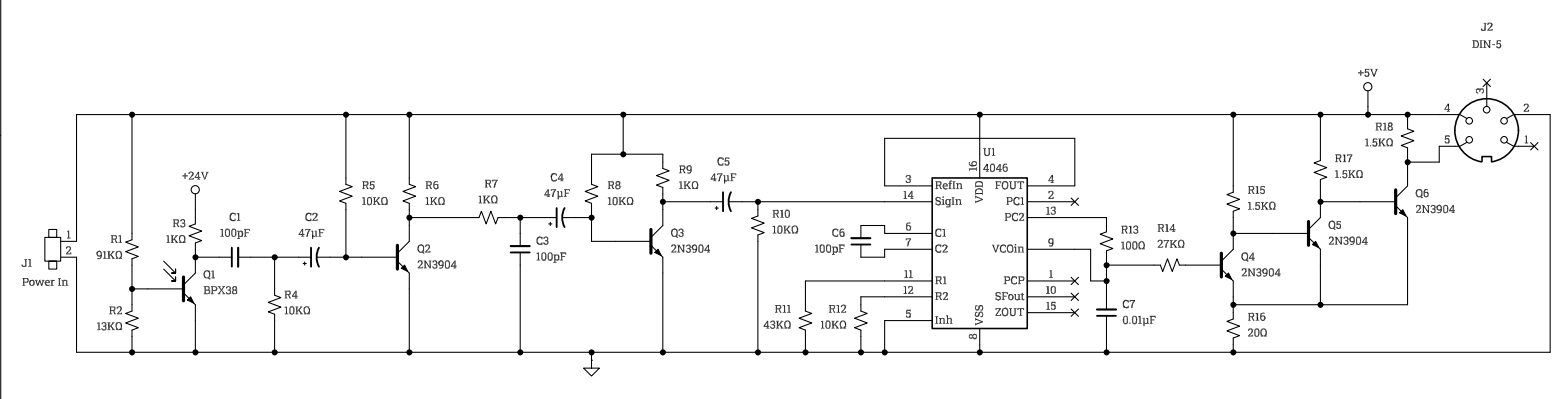
[picture p92: page 1]
