Masaharu41/Midi-Bass-Guitar/IR_MIDI/Midi_IR_Tx/IR_MIDI_Tx.pdf

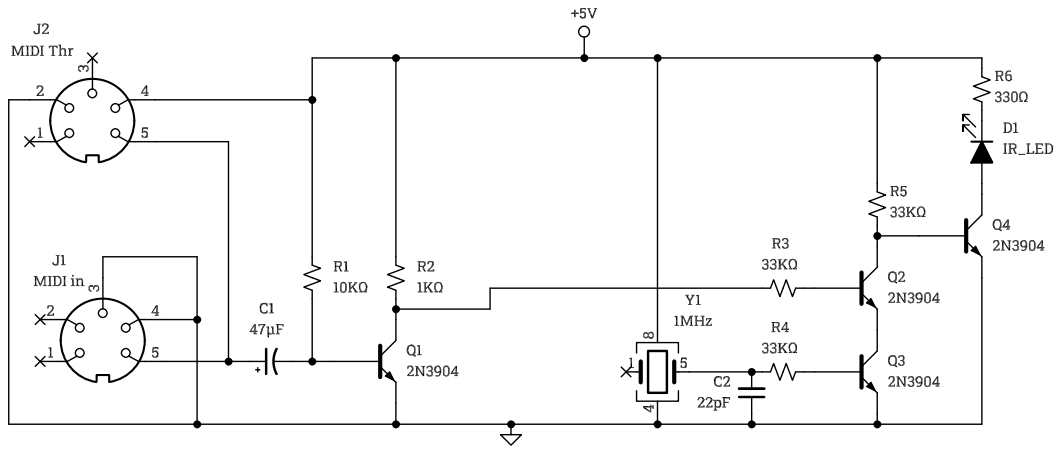
[picture p93: page 1]
