Masaharu41/Midi-Bass-Guitar/Motherboard Sch/Motherboard Sch.kicad_pcb

## KiCad design Motherboard Sch/Motherboard Sch.kicad_pcb (2025-05-07)

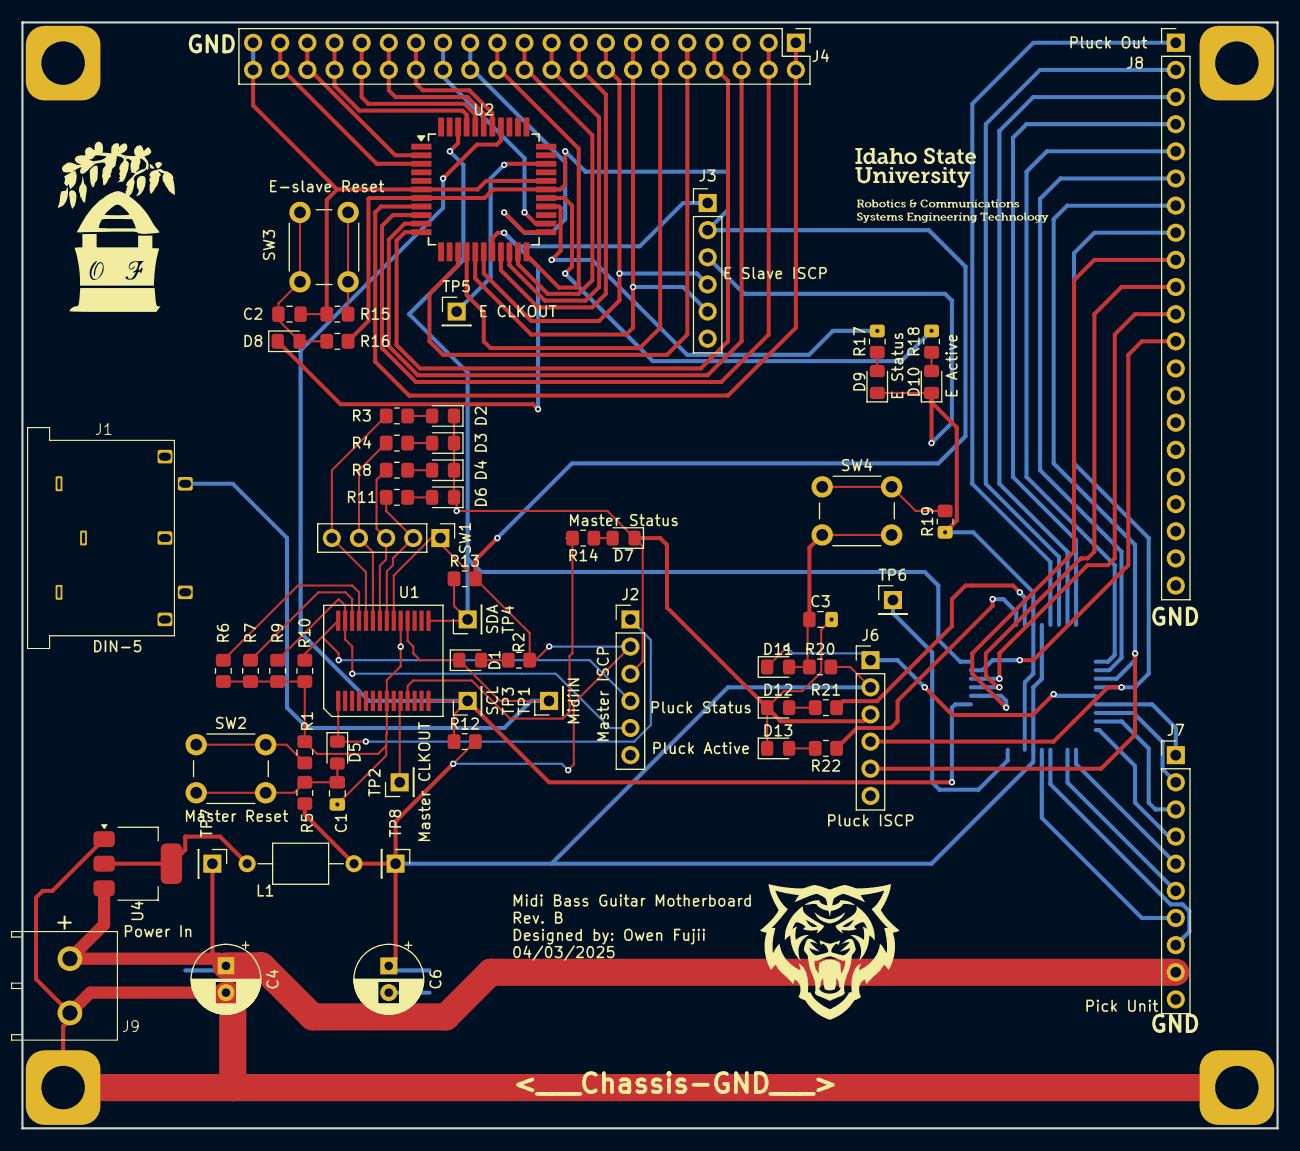
[picture p94: board Motherboard Sch.kicad_pcb from above]

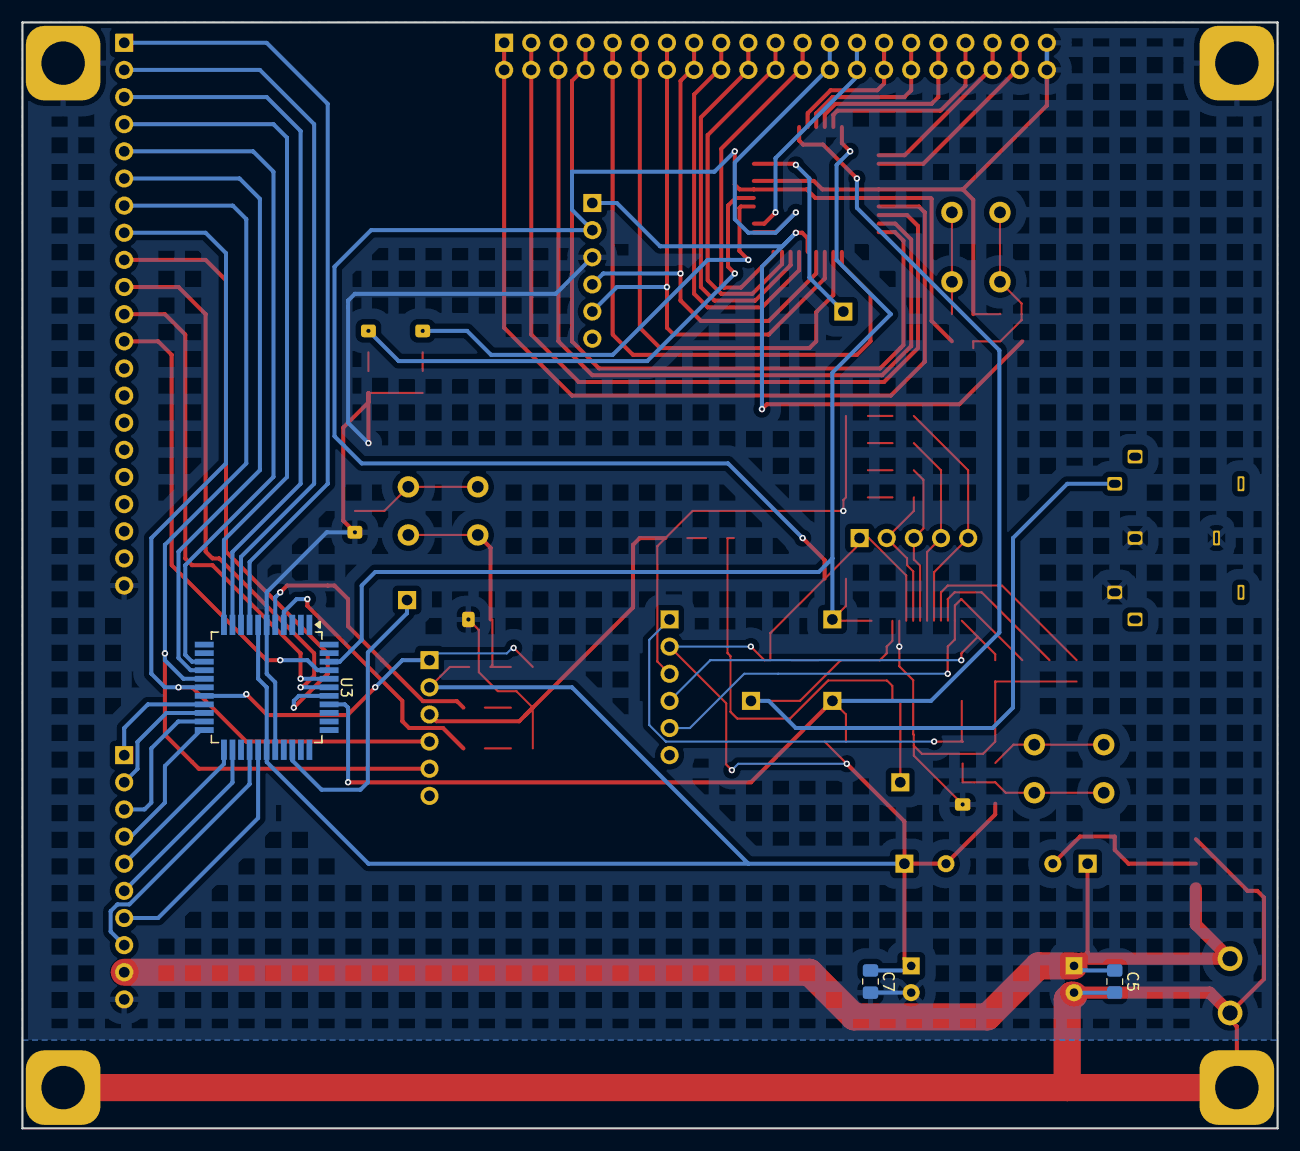
[picture p95: board Motherboard Sch.kicad_pcb from below]

Board: 2 copper layers, 117.5 x 103.5 mm, 67 parts (3 on the bottom side), 83 nets.

Parts:
C1, C2, C3: 10uF; C_0805_2012Metric_Pad1.18x1.45mm_HandSolder
C4, C6: 100uF; CP_Radial_D6.3mm_P2.50mm
C5, C7: 0.1uF; C_0805_2012Metric_Pad1.18x1.45mm_HandSolder
D1: LED; D_0805_2012Metric_Pad1.15x1.40mm_HandSolder
D2: 8; D_0805_2012Metric_Pad1.15x1.40mm_HandSolder
D3: 4; D_0805_2012Metric_Pad1.15x1.40mm_HandSolder
D4: 2; D_0805_2012Metric_Pad1.15x1.40mm_HandSolder
D5, D8, D11: 4148; D_0805_2012Metric_Pad1.15x1.40mm_HandSolder
D6: 1; D_0805_2012Metric_Pad1.15x1.40mm_HandSolder
D7: Master Status; D_0805_2012Metric_Pad1.15x1.40mm_HandSolder
D9: E Status; D_0805_2012Metric_Pad1.15x1.40mm_HandSolder
D10: E Active; D_0805_2012Metric_Pad1.15x1.40mm_HandSolder
D12: Pluck Status; D_0805_2012Metric_Pad1.15x1.40mm_HandSolder
D13: Pluck Active; D_0805_2012Metric_Pad1.15x1.40mm_HandSolder
J1: DIN-5; Din_5 Connector
J2: Master ISCP; PinHeader_1x06_P2.54mm_Vertical
J3: E SLAVE ISCP; PinHeader_1x06_P2.54mm_Vertical
J4: E Slave Out; PinHeader_2x21_P2.54mm_Vertical
J6: Pluck ISCP; PinHeader_1x06_P2.54mm_Vertical
J7: Pick Unit; PinHeader_1x10_P2.54mm_Vertical
J8: Pluck Out; PinHeader_1x21_P2.54mm_Vertical
J9: Power In; Two_Pin_Screw_Terminal
L1: 10uH; L_Axial_L5.0mm_D3.6mm_P10.00mm_Horizontal_Murata_BL01RN1A2A2
R1, R15, R19: 10Ω; R_0805_2012Metric_Pad1.20x1.40mm_HandSolder
R2: 1kΩ; R_0805_2012Metric_Pad1.20x1.40mm_HandSolder
R3, R4, R8, R11, R14, R17, R18, R21, R22: 330Ω; R_0805_2012Metric_Pad1.20x1.40mm_HandSolder
R5, R6, R7, R9, R10, R16, R20: 10kΩ; R_0805_2012Metric_Pad1.20x1.40mm_HandSolder
R12, R13: 2.2kΩ; R_0805_2012Metric_Pad1.20x1.40mm_HandSolder
SW1: PinHeader_1x05_P2.54mm_Vertical
SW2: Master Reset; SW_PUSH_6mm_H5mm
SW3: E-slave Reset; SW_PUSH_6mm_H5mm
SW4: Pluck Reset; SW_PUSH_6mm_H5mm
TP1: MidiIN; PinHeader_1x01_P2.54mm_Vertical
TP2: Master CLKOUT; PinHeader_1x01_P2.54mm_Vertical
TP3: SCL; PinHeader_1x01_P2.54mm_Vertical
TP4: SDA; PinHeader_1x01_P2.54mm_Vertical
TP5: E CLKOUT; PinHeader_1x01_P2.54mm_Vertical
TP6: PLUCK CLKOUT; PinHeader_1x01_P2.54mm_Vertical
TP7: P-IN; PinHeader_1x01_P2.54mm_Vertical
TP8: 5v; PinHeader_1x01_P2.54mm_Vertical
U1: PIC16F1788; SSOP-28
U2, U3: PIC16F1789; TQFP-44_10x10mm_P0.8mm_Handsolder
U4: LM1117MP-1.8; SOT-223-3_TabPin2

Connections:
1: R11.2, SW1.2 (1), U1.21 (INT/AN12/RB0)
2: R8.2, SW1.3 (2), U1.22 (P1C/AN10/RB1)
4: R4.2, SW1.4, U1.23 (P1B/AN8/RB2)
8: R3.2, SW1.5 (8), U1.24 (PGM/C12IN2-/AN8/RB3)
+5v: C6.1, C7.1, J2.2, J3.2, J6.2, L1.2, R2.2, R5.2, R12.2, R13.2, R16.2, R20.2, SW1.1 (Com), TP8.1, U1.20 (VDD), U2.7 (Vdd), U2.28 (Vdd), U3.7 (Vdd), U3.28 (Vdd)
+12v: C4.1, C5.1, J7.9, J9.1, TP7.1, U4.3 (VI)
/String Strike Slave/A0: J8.3, U3.10 (RB2/AN8/OPA2IN-/DAC3OUT1)
/String Strike Slave/A1: J8.4, U3.11 (RB3/AN9/CXNI2-/CCP2)
/String Strike Slave/A MUTE: J8.10, U3.39 (RD1/CxIN4-/OPA3OUT)
/String Strike Slave/D0: J8.5, U3.14 (RB4/AN11/C3IN1+)
/String Strike Slave/D1: J8.6, U3.15 (RB5/AN13/C4IN2-/CCP3)
/String Strike Slave/D MUTE: J8.11, U3.40 (RD2/OPA3IN-/DAC4OUT1)
/String Strike Slave/E0: J8.1, U3.8 (RB0/AN12/CCP1/C2IN1+)
/String Strike Slave/E1: J8.2, U3.9 (RB1/AN10/CxIN3-/OPA2OUT)
/String Strike Slave/E MUTE: J8.9, U3.38 (RD0/OPA3IN+)
/String Strike Slave/G MUTE: J8.12, U3.41 (RD3/PSMC4A)
A1: J4.5, U2.14 (RB4/AN11/C3IN1+)
A2: J4.17, U2.40 (RD2/OPA3IN-/DAC4OUT1)
A#1: J4.6, U2.15 (RB5/AN13/C4IN2-/CCP3)
A#2: J4.18, U2.41 (RD3/PSMC4A)
B1: J3.5, J4.7, U2.16 (RB6/C4IN1+/ICSPCLK)
B2: J4.19, U2.2 (RD4/PSM3F)
C2: J3.4, J4.8, U2.17 (RB7/DACxOUT2-/ICSPDAT)
C3: J4.20, U2.3 (RD5/PSMC3E)
C#2: J4.9, U2.19 (RA0/AN0/CxIN0-)
D2: J4.10, U2.20 (RA1/AN1/CxIN1-/OPA1OUT)
D#2: J4.11, U2.21 (RA2/AN2/CxIN0+/DAC1OUT1)
E2: J4.12, U2.22 (RA3/AN3/VREF+/C1IN1+)
Earth_GND: C4.2, C5.2, J9.2, U4.1 (GND)
F1: J4.1, U2.8 (RB0/AN12/CCP1/C2IN1+)
F2: J4.13, U2.23 (RA4/C1OUT/OPA1IN+/T0CKI)
F#1: J4.2, U2.9 (RB1/AN10/CxIN3-/OPA2OUT)
F#2: J4.14, U2.24 (RA5/AN4/C2OUT/OPA1IN+)
G1: J4.3, U2.10 (RB2/AN8/OPA2IN-/DAC3OUT1)
G2: J4.15, U2.38 (RD0/OPA3IN+)
G#1: J4.4, U2.11 (RB3/AN9/CXNI2-/CCP2)
G#2: J4.16, U2.39 (RD1/CxIN4-/OPA3OUT)
GND: C1.2, C2.2, C3.2, C6.2, C7.2, D2.1 (K), D3.1 (K), D4.1 (K), D6.1 (K), D7.1 (K), D9.1 (K), D10.1 (K), D12.1 (K), D13.1 (K), J1.2, J1.4, J1.6, J2.3, J3.3, J4.21, J6.3, J7.10, J8.21, R1.1, R6.1, R7.1, R9.1, R10.1, R15.1, R19.1, U1.8 (VSS), U1.19 (VSS), U2.6 (Vss), U2.29 (Vss), U3.6 (Vss), U3.29 (Vss)
I2Cclk: R12.1, TP3.1, U1.14 (RC3/SCK/SCL), U2.37 (RC3/SCL/SCK/PSMC1D), U3.37 (RC3/SCL/SCK/PSMC1D)
I2Cdat: R13.1, TP4.1, U1.15 (RC4/SDI/SDA), U2.42 (RC4/SDI/SDA/PSMC1E), U3.42 (RC4/SDI/SDA/PSMC1E)
MSCLR E: D8.1, J3.1, U2.18 (Vpp/~MCLR/RE3)
MSCLR P: D11.1, J6.1, U3.18 (Vpp/~MCLR/RE3)
unnamed: C1.1, D5.2, R5.1, SW2.2
unnamed: C2.1, D8.2, R16.1, SW3.2
unnamed: C3.1, D11.2, R20.1, SW4.2
unnamed: D1.2 (A), R2.1
unnamed: D1.1 (K), J1.5, TP1.1, U1.18 (RC7/RX/DT)
unnamed: D2.2 (A), R3.1
unnamed: D3.2 (A), R4.1
unnamed: D4.2 (A), R8.1
unnamed: D6.2 (A), R11.1
unnamed: D7.2 (A), R14.1
unnamed: D9.2 (A), R17.1
unnamed: D10.2 (A), R18.1
unnamed: D12.2 (A), R21.1
unnamed: D13.2 (A), R22.2
unnamed: R1.2, SW2.1
unnamed: R15.2, SW3.1
unnamed: R19.2, SW4.1
unnamed: TP2.1, U1.10 (CLKOUT/OSC2/RA6)
unnamed: R6.2, U1.25 (P1D/AN11/RB4)
unnamed: R14.2, U1.11 (RC0/T1OSO/T1CK1)
unnamed: D5.1, J2.1, U1.1 (RE3/~MCLR/Vpp)
unnamed: R7.2, U1.26 (~T1G/AN13/RB5)
unnamed: TP5.1, U2.31 (RA6/C2OUT/CLKOUT)
unnamed: R17.2, U2.26 (RE1/AN6/PSMC3B)
unnamed: R18.2, U2.27 (RE2/AN7/PSMC3A)
unnamed: J7.1, U3.19 (RA0/AN0/CxIN0-)
unnamed: J7.2, U3.20 (RA1/AN1/CxIN1-/OPA1OUT)
unnamed: J7.3, U3.21 (RA2/AN2/CxIN0+/DAC1OUT1)
unnamed: J7.4, U3.22 (RA3/AN3/VREF+/C1IN1+)
unnamed: J7.5, U3.23 (RA4/C1OUT/OPA1IN+/T0CKI)
unnamed: J7.6, U3.24 (RA5/AN4/C2OUT/OPA1IN+)
unnamed: TP6.1, U3.31 (RA6/C2OUT/CLKOUT)
unnamed: R22.1, U3.4 (RD6/PSMC3D)
unnamed: R21.2, U3.5 (RD7/C4OUT/PSMC3C)
unnamed: J7.8, U3.26 (RE1/AN6/PSMC3B)
unnamed: J7.7, U3.27 (RE2/AN7/PSMC3A)
unnamed: L1.1, U4.2 (VO)
RB6 P: J6.5, J8.7, U3.16 (RB6/C4IN1+/ICSPCLK)
RB6M: J2.5, R9.2, U1.27 (ICSPCLK/RB6)
RB7 P: J6.4, J8.8, U3.17 (RB7/DACxOUT2-/ICSPDAT)
RB7M: J2.4, R10.2, U1.28 (ICSPDAT/RB7)
