Masaharu41/Midi-Bass-Guitar/High Power Class AB/High Power Class AB.kicad_pcb

## KiCad design High Power Class AB/High Power Class AB.kicad_pcb (2025-04-04)

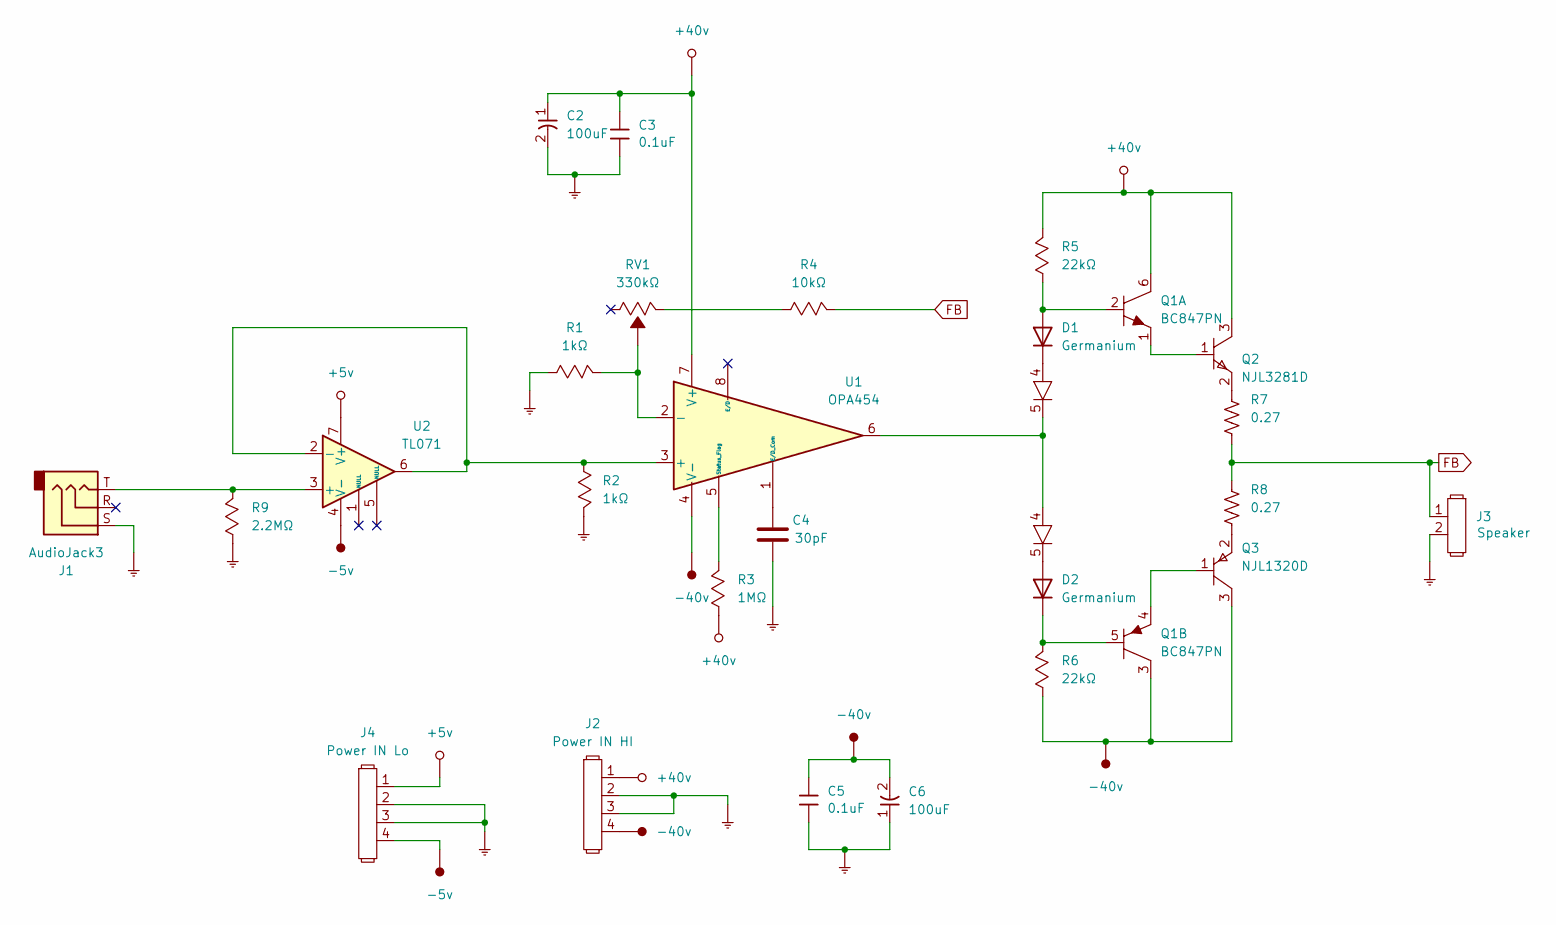
[picture p100: schematic High Power Class AB.kicad_sch]

Parts:
C2, C6: 100uF; CP_Radial_D10.0mm_P5.00mm
C3, C5: 0.1uF; C_0805_2012Metric_Pad1.18x1.45mm_HandSolder
C4: 30pF; C_0805_2012Metric_Pad1.18x1.45mm_HandSolder
D1, D2: Germanium; D_DO-15_P12.70mm_Horizontal
J1: AudioJack3; 1_4-input-TRS
J2: Power IN HI; 4-Pin Screw Terminal
J3: Speaker; Two_Pin_Screw_Terminal
J4: Power IN Lo; 4-Pin Screw Terminal
Q1: BC847PN; SOT-363_SC-70-6_Handsoldering
Q2: NJL3281D; TO-264-5_Vertical
Q3: NJL1320D; TO-264-5_Vertical
R1, R2: 1kΩ; R_0805_2012Metric_Pad1.20x1.40mm_HandSolder
R3: 1MΩ; R_0805_2012Metric_Pad1.20x1.40mm_HandSolder
R4: 10kΩ; R_0805_2012Metric_Pad1.20x1.40mm_HandSolder
R5, R6: 22kΩ; R_0805_2012Metric_Pad1.20x1.40mm_HandSolder
R7, R8: 0.27; R_Axial_Power_L25.0mm_W6.4mm_P27.94mm
R9: 2.2MΩ; R_0805_2012Metric_Pad1.20x1.40mm_HandSolder
RV1: 330kΩ; Potentiometer_Piher_PC-16_Single_Horizontal
U1: OPA454; SOIC-8-1EP_3.9x4.9mm_P1.27mm_EP2.29x3mm
U2: TL071; DIP-8_W7.62mm

Connections:
+5v: J4.1, U2.7 (V+)
+40v: C2.1, C3.1, J2.1, Q1.6, Q2.3, R3.1, R5.2, U1.7 (V+)
-5v: J4.4, U2.4 (V-)
-40v: C5.1, C6.2, J2.4, Q1.3, Q3.3, R6.1, U1.4 (V-)
Earth_GND: C2.2, C3.2, C4.1, C5.2, C6.1, J1.S, J2.2, J2.3, J3.2, J4.2, J4.3, R1.1, R2.2, R9.1
FB: J3.1, R4.2, R7.2, R8.1
unnamed: D1.1 (A), Q1.2, R5.1
unnamed: D1.2 (K), Q2.4
unnamed: D2.1 (A), Q3.5
unnamed: D2.2 (K), Q1.5, R6.2
unnamed: Q1.1, Q2.1
unnamed: Q1.4, Q3.1
unnamed: Q2.2, R7.1
unnamed: Q2.5, Q3.4, U1.6
unnamed: Q3.2, R8.2
unnamed: R4.1, RV1.2
unnamed: R2.1, U1.3 (+), U2.2 (-), U2.6
unnamed: R1.2, RV1.3, U1.2 (-)
unnamed: C4.2, U1.1 (E/D_Com)
unnamed: R3.2, U1.5 (Status_Flag)
unnamed: J1.T, R9.2, U2.3 (+)

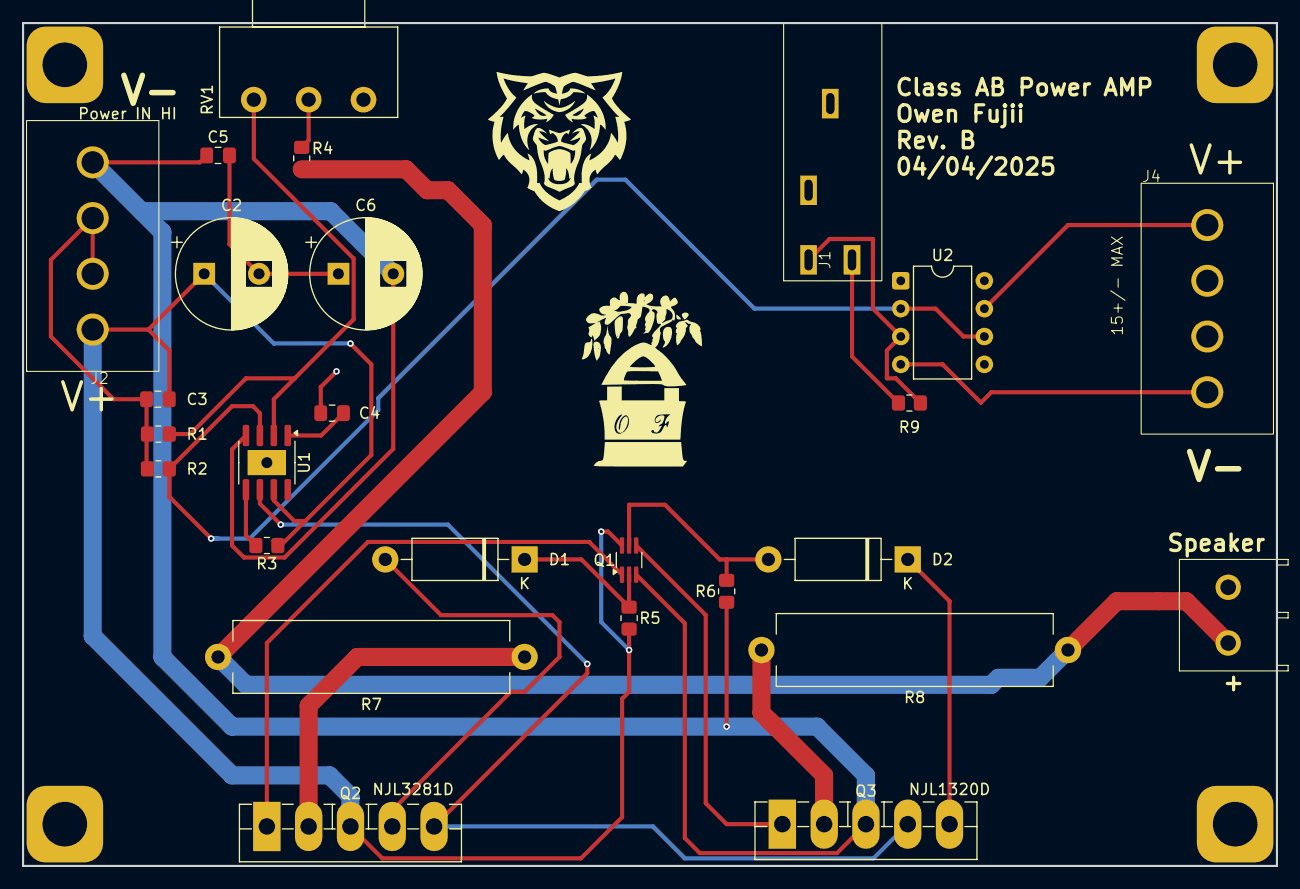
[picture p101: board High Power Class AB.kicad_pcb from above]

Board: 2 copper layers, 114.3 x 76.8 mm, 26 parts (0 on the bottom side), 21 nets.
