Masaharu41/Midi-Bass-Guitar/Small Unit Breakout/Small Unit Breakout.kicad_pcb

## KiCad design Small Unit Breakout/Small Unit Breakout.kicad_pcb (2025-03-14)

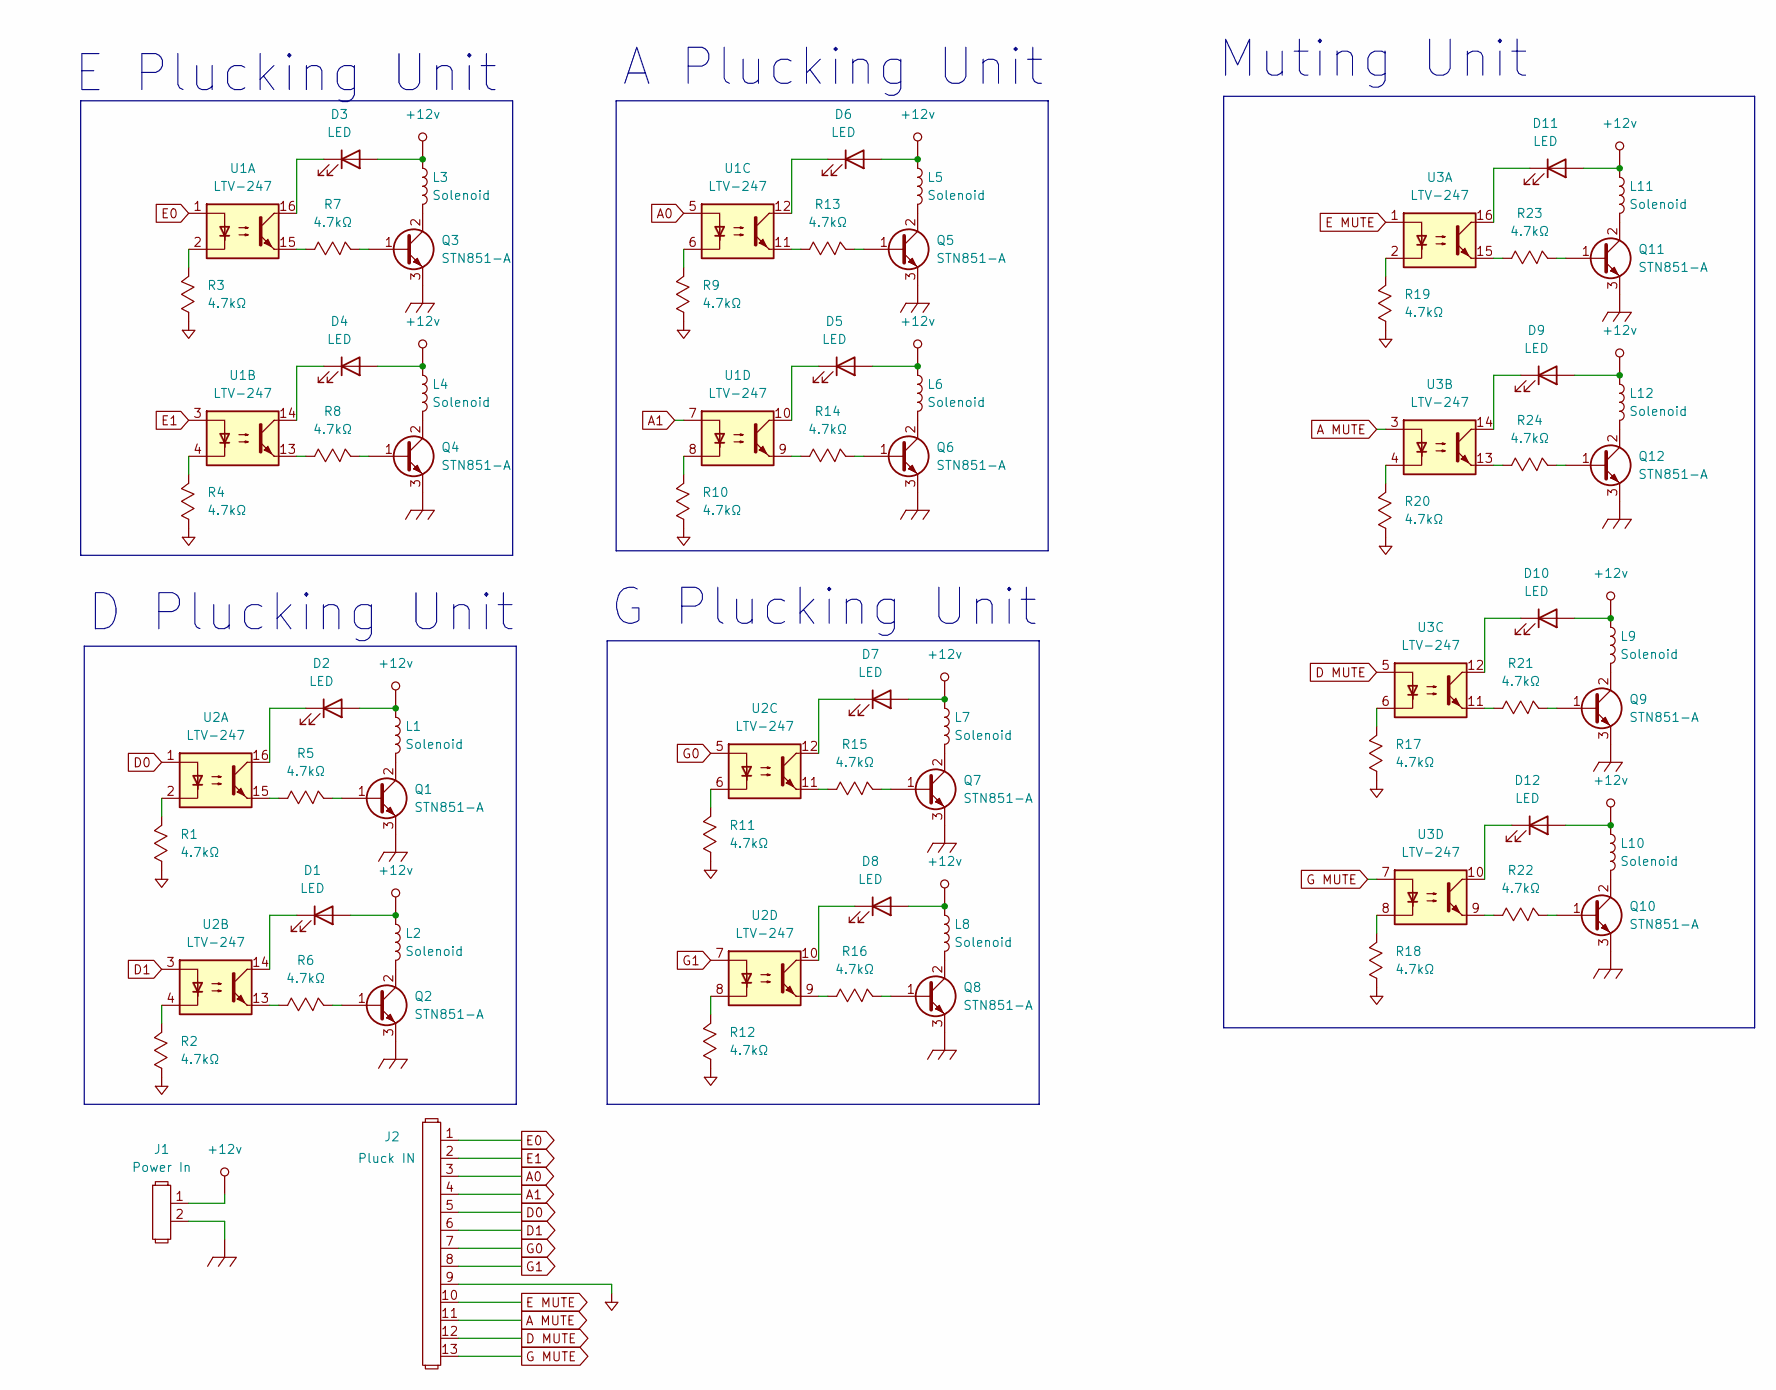
[picture p102: schematic Small Unit Breakout.kicad_sch, Smaller Breakout]

Parts:
D1, D2, D3, D4, D5, D6, D7, D8, D9, D10, D11, D12: LED; LED_0805_2012Metric_Pad1.15x1.40mm_HandSolder
J1: Power In; Two_Pin_Screw_Terminal
J2: Pluck IN; PinHeader_1x13_P2.54mm_Vertical
L1, L2, L3, L4, L5, L6, L7, L8, L9, L10, L11, L12: Solenoid; PinHeader_1x02_P2.54mm_Vertical
Q1, Q2, Q3, Q4, Q5, Q6, Q7, Q8, Q9, Q10, Q11, Q12: STN851-A; SOT-223-3_TabPin2
R1, R2, R3, R4, R5, R6, R7, R8, R9, R10, R11, R12, R13, R14, R15, R16, R17, R18, R19, R20, R21, R22, R23, R24: 4.7kΩ; R_0805_2012Metric_Pad1.20x1.40mm_HandSolder
U1, U2, U3: LTV-247; SOP-16_4.4x10.4mm_P1.27mm

Connections:
+12v: D1.2 (A), D2.2 (A), D3.2 (A), D4.2 (A), D5.2 (A), D6.2 (A), D7.2 (A), D8.2 (A), D9.2 (A), D10.2 (A), D11.2 (A), D12.2 (A), J1.1, L1.1, L2.1, L3.1, L4.1, L5.1, L6.1, L7.1, L8.1, L9.1, L10.1, L11.1, L12.1; also elsewhere on the board
A0: J2.3, U1.5
A1: J2.4, U1.7
A MUTE: J2.11, U3.3
Chassis_GND: J1.2, Q1.3 (E), Q2.3 (E), Q3.3 (E), Q4.3 (E), Q5.3 (E), Q6.3 (E), Q7.3 (E), Q8.3 (E), Q9.3 (E), Q10.3 (E), Q11.3 (E), Q12.3 (E); also elsewhere on the board
D0: J2.5, U2.1
D1: J2.6, U2.3
D MUTE: J2.12, U3.5
E0: J2.1, U1.1
E1: J2.2, U1.3
E MUTE: J2.10, U3.1
G0: J2.7, U2.5
G1: J2.8, U2.7
G MUTE: J2.13, U3.7
GND: J2.9, R1.1, R2.1, R3.1, R4.1, R9.1, R10.1, R11.1, R12.1, R17.1, R18.1, R19.1, R20.1
unnamed: D1.1 (K), U2.14
unnamed: D2.1 (K), U2.16
unnamed: D3.1 (K), U1.16
unnamed: D4.1 (K), U1.14
unnamed: D5.1 (K), U1.10
unnamed: D6.1 (K), U1.12
unnamed: D7.1 (K), U2.12
unnamed: D8.1 (K), U2.10
unnamed: D9.1 (K), U3.14
unnamed: D10.1 (K), U3.12
unnamed: D11.1 (K), U3.16
unnamed: D12.1 (K), U3.10
unnamed: Q1.1 (B), R5.2
unnamed: L1.2, Q1.2 (C)
unnamed: Q2.1 (B), R6.2
unnamed: L2.2, Q2.2 (C)
unnamed: Q3.1 (B), R7.2
unnamed: L3.2, Q3.2 (C)
unnamed: Q4.1 (B), R8.2
unnamed: L4.2, Q4.2 (C)
unnamed: Q5.1 (B), R13.2
unnamed: L5.2, Q5.2 (C)
unnamed: Q6.1 (B), R14.2
unnamed: L6.2, Q6.2 (C)
unnamed: Q7.1 (B), R15.2
unnamed: L7.2, Q7.2 (C)
unnamed: Q8.1 (B), R16.2
unnamed: L8.2, Q8.2 (C)
unnamed: Q9.1 (B), R21.2
unnamed: L9.2, Q9.2 (C)
unnamed: Q10.1 (B), R22.2
unnamed: L10.2, Q10.2 (C)
unnamed: Q11.1 (B), R23.2
unnamed: L11.2, Q11.2 (C)
unnamed: Q12.1 (B), R24.2
unnamed: L12.2, Q12.2 (C)
unnamed: R1.2, U2.2
unnamed: R2.2, U2.4
unnamed: R3.2, U1.2
unnamed: R4.2, U1.4
unnamed: R5.1, U2.15
unnamed: R6.1, U2.13
unnamed: R7.1, U1.15
unnamed: R8.1, U1.13
unnamed: R9.2, U1.6
unnamed: R10.2, U1.8
unnamed: R11.2, U2.6
unnamed: R12.2, U2.8
unnamed: R13.1, U1.11
unnamed: R14.1, U1.9
unnamed: R15.1, U2.11
unnamed: R16.1, U2.9
unnamed: R17.2, U3.6
unnamed: R18.2, U3.8
unnamed: R19.2, U3.2
unnamed: R20.2, U3.4
unnamed: R21.1, U3.11
unnamed: R22.1, U3.9
unnamed: R23.1, U3.15
unnamed: R24.1, U3.13

Notes on the sheet:
Muting Unit
G Plucking Unit
D Plucking Unit
E Plucking Unit
A Plucking Unit

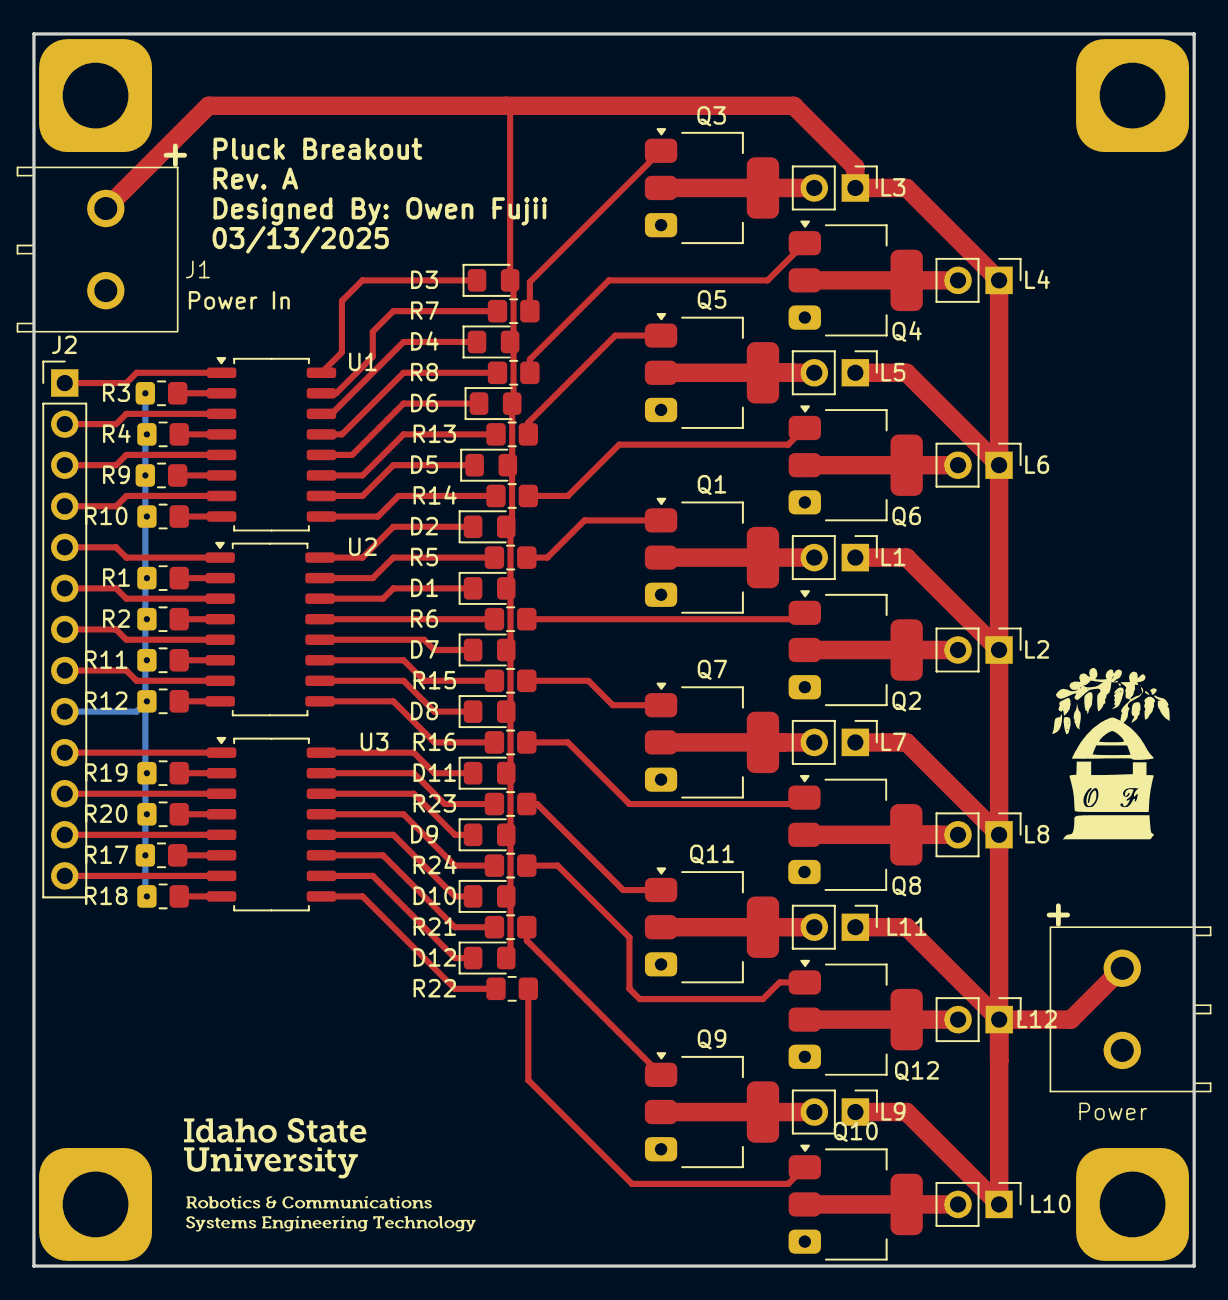
[picture p103: board Small Unit Breakout.kicad_pcb from above]

Board: 2 copper layers, 71.8 x 76.2 mm, 66 parts (0 on the bottom side), 75 nets.

Other parts of the board:
Power: Two_Pin_Screw_Terminal

Their connections:
+12v: Power.2; also elsewhere on the board
Chassis_GND: Power.1; also elsewhere on the board
