Masaharu41/Midi-Bass-Guitar/(commit log)

2024-11-05 readded file
    [Project Hours.ods]
2024-11-05 added schematic files
    [Midi Bass Sch.kicad_pcb, Midi Bass Sch.kicad_sch]
2024-11-05 Added Master Assembly
2024-11-05 added setup for address of I2C slaves
2024-11-05 added include for I2C write
2024-11-05 modified I2C write to be usable with two byte transmit
2024-11-05 adding uart recieve and clean building all files currently successful
2024-11-05 finished basic master communication protocol
    [Project Hours.ods]
2024-11-05 updated hours
    [Project Hours.ods]
2024-11-06 added comments to MidiMaster detailing data
    [Project Hours.ods]
2024-11-06 updated schematic
    [Midi Bass Sch.kicad_sch]
2024-11-06 cleared interrupts for I2C writes
2024-11-06 Fixed issue with 32mhz oscillator setup
    [MidiMaster.asm, Pluck Slave.asm]
2024-11-07 fixed structure of I2C write and Issue in Main program
    [MidiMaster.asm]
2024-11-07 updated hours sheet to current
    [Midi Bass Sch.kicad_sch, Project Hours.ods]
2024-11-07 updated I2C include to assembler preferred labels
2024-11-07 added new comments and working on I2C issue
    [MidiMaster.asm, Pluck Slave.asm]
2024-11-07 added CAD Model for the Neck of the Bass
    [P-Bass Neck.SLDPRT]
2024-11-07 added the basic model for bass body
    [P-Bass Body.SLDPRT]
2024-11-08 updated bass body and hours
    [P-Bass Body.SLDPRT, Project Hours.ods]
2024-11-08 Finished basic outline of bass body
    [P-Bass Body.SLDPRT]
2024-11-09 finished adding all Eslave output selects
    [Project Hours.ods]
2024-11-11 fixed issues with slave recieve and updated hours
    [Project Hours.ods]
2024-11-11 updated body to include neck and pickup cutouts
    [P-Bass Body.SLDPRT, Project Hours.ods]
2024-11-11 added assembly for full bass guitar
    [P-Bass Body.SLDPRT, P-Bass Neck.SLDPRT, P-Bass.SLDASM, Project Hours.ods]
2024-11-11 started basic pickguard solid part
    [Pick Guard.SLDPRT]
2024-11-11 added simplified bridge models
    [Simplified Bridge.SLDPRT]
2024-11-11 added basic bridge saddle solid model
    [Bridge Saddle.SLDPRT]
2024-11-12 updated hours and bass assembly
    [P-Bass Body.SLDPRT, P-Bass.SLDASM, Project Hours.ods, Simplified Bridge.SLDPRT]
2024-11-12 added positions of frets
    [P-Bass Neck.SLDPRT, P-Bass.SLDASM, Pick Guard.SLDPRT]
2024-11-12 modified schematic to include seperate sheets for master and slaves
    [Eslave Sch.kicad_sch, Master Sch.kicad_sch, Midi Bass Sch.kicad_sch, SSSlave sch.kicad_sch]
2024-11-13 added spreadsheet with notes
    [Midi Notes and Real Notes.ods]
2024-11-14 finished rough structure for pitch up selection
2024-11-14 updated basic pick guard and asm
    [P-Bass.SLDASM, Pick Guard.SLDPRT, Project Hours.ods]
2024-11-14 updated appearance in main assembly
    [P-Bass.SLDASM]
2024-11-14 resolved hole misalignment of pickguard and body
    [P-Bass Body.SLDPRT, P-Bass.SLDASM, Pick Guard.SLDPRT]
2024-11-15 added simple solenoid body cad model
    [25n Solenoid Simple Body.SLDPRT]
2024-11-15 added basic cad model for solenoid plunger
    [Solenoid Firing pin.SLDPRT]
2024-11-15 updated solenoid plunger
    [Solenoid Firing pin.SLDPRT]
2024-11-15 added solenoid assembly to main assembly
    [P-Bass.SLDASM]
2024-11-15 working on pluck slave need to analyze trigger circuitry
    [Project Hours.ods]
2024-11-18 began implementing alternating plucking unit control
    [Project Hours.ods]
2024-11-18 finished framework for alternating enable for all strings
2024-11-18 began implementing I2C stop condition properly at this point I2C is broken
    [Pluck Slave.asm]
2024-11-18 working on I2C slave bus release issues
    [Project Hours.ods]
2024-11-19 working on I2C issues with master
    [ESlave.asm, Pluck Slave.asm]
2024-11-19 resolved I2C issues with Master and Slaves
    [Pluck Slave.asm]
2024-11-19 fixed alternating function for each string in pluck slave
    [Pluck Slave.asm]
2024-11-19 reduced time of pulse
    [Eslave Sch.kicad_sch]
2024-11-19 fixed issue with hitting notes on rest
    [MidiMaster.asm, Pluck Slave.asm]
2024-11-19 updated table of values to include hex for E string
    [Midi Notes and Real Notes.ods]
2024-11-19 updated schematic to include solenoid output
    [Eslave Sch.kicad_sch]
2024-11-19 updated schematic to include solenoids for pluck slave
    [Eslave Sch.kicad_sch, Master Sch.kicad_sch, SSSlave sch.kicad_sch]
2024-11-19 added startup clear to schematic
    [Eslave Sch.kicad_sch, SSSlave sch.kicad_sch]
2024-11-19 changed solenoid to a seperate sheet to include all plucking units
    [SSSlave sch.kicad_sch]
2024-11-20 updated schematic to include test points for pics
    [Eslave Sch.kicad_sch, Master Sch.kicad_sch, SSSlave sch.kicad_sch]
2024-11-20 updated schematic to include all slaves
    [Aslave Sch.kicad_sch, Dslave Sch.kicad_sch, Gslave Sch.kicad_sch, Midi Bass Sch.kicad_sch, PluckingPack.kicad_sch]
2024-11-20 fixed issues with string select on master
    [MidiMaster.asm]
2024-11-20 reworking down note algorithm
    [MidiMaster.asm]
2024-11-20 current eval for strings works
2024-11-20 rolling E slave back to a simpler setup system to control string is being changed to a gantry system
2024-11-20 changed schematic for e slave to be a 1788 and now has status leds
    [Eslave Sch.kicad_sch]
2024-11-20 Added stepper controller to E slave
    [Eslave Sch.kicad_sch]
2024-11-21 updated e slave added solenoid for slave added reset button
    [Aslave Sch.kicad_sch, Dslave Sch.kicad_sch, Eslave Sch.kicad_sch, Gslave Sch.kicad_sch, PluckingPack.kicad_sch]
2024-11-21 added new file for stepper drive
2024-11-21 implimented basic stepper output step clock
2024-11-21 added stepper drive to E slave Testing is preliminary and not how it will be fully used
2024-11-21 stepper include does operate as intended
2024-11-21 began adding stepper location calculation into program
2024-11-21 finished first rev of stepper clock section Will now work on demo of stepper operation
2024-11-21 removed old code in e slave and updated schematic will move to new direction with e slave
    [Eslave Sch.kicad_sch]
2024-11-22 updated report to include proprosed problem
    [Project Hours.ods]
2024-11-22 modified system flowchart to include the bass
2024-11-22 added flowchart for basic master program flow
2024-11-22 added flowchart for math section of master program
    [Project Hours.ods]
2024-11-22 added stepper calculation to main function
2024-11-22 updated stepper voltage
    [Eslave Sch.kicad_sch]
2024-11-22 I2C broken as of now
    [ESlave.asm, MidiMaster.asm]
2024-11-22 working on issues with I2C
    [MidiMaster.asm]
2024-11-22 Rolled Master back to older version Will move to use I2C for confirmation
2024-11-22 reverting E slave to main Steppper motor idea ditched Reverting Back to Mass Solenoid system
    [ESlave.asm]
2024-11-23 updated master schematic and block diagram updated hours as well added block diagram to report
    [Master Sch.kicad_sch, Project Hours.ods]
2024-11-23 updated slave to 1789 to reflect new design updated 1789 to reflect thin flat pack
    [Eslave Sch.kicad_sch, Master Sch.kicad_sch]
2024-11-23 added flags to E-slave
    [Eslave Sch.kicad_sch, Master Sch.kicad_sch]
2024-11-23 added schematic page for solenoid array for E-slave
    [Eslave Sch.kicad_sch, EsolenoidA.kicad_sch]
2024-11-23 updated number tables to include hex for all values
    [Midi Notes and Real Notes.ods]
2024-11-23 updated schematic numbers
    [Eslave Sch.kicad_sch, EsolenoidA.kicad_sch]
2024-11-24 updated solenoid array to use opto isolation
    [EsolenoidA.kicad_sch]
2024-11-24 added opto isolation to plucking solenoids
    [Eslave Sch.kicad_sch, Master Sch.kicad_sch, PluckingPack.kicad_sch]
2024-11-24 working on system overview of report
    [EsolenoidA.kicad_sch, Master Sch.kicad_sch, PluckingPack.kicad_sch]
2024-11-29 added basic flowchart for string slave
2024-11-29 added solenoid array for the A slave
    [ASolenoidA.kicad_sch, Aslave Sch.kicad_sch, Dslave Sch.kicad_sch, Eslave Sch.kicad_sch, EsolenoidA.kicad_sch, Gslave Sch.kicad_sch, Master Sch.kicad_sch, Midi Bass Sch.kicad_sch]
2024-11-29 added solenoid array for the D slave
    [DSolenoidA.kicad_sch, Dslave Sch.kicad_sch]
2024-11-29 added solenoid array for the G slave
    [DSolenoidA.kicad_sch, Dslave Sch.kicad_sch, EsolenoidA.kicad_sch, GSolenoidA.kicad_sch, Gslave Sch.kicad_sch]
2024-12-01 added program pins to all processors
    [ASolenoidA.kicad_sch, Aslave Sch.kicad_sch, DSolenoidA.kicad_sch, Dslave Sch.kicad_sch, Eslave Sch.kicad_sch, EsolenoidA.kicad_sch, GSolenoidA.kicad_sch, Gslave Sch.kicad_sch]
2024-12-01 added footprints to kicad schematic still need footprint for din connector
    [ASolenoidA.kicad_sch, Aslave Sch.kicad_sch, DSolenoidA.kicad_sch, Dslave Sch.kicad_sch, Eslave Sch.kicad_sch, EsolenoidA.kicad_sch, GSolenoidA.kicad_sch, Gslave Sch.kicad_sch]
2024-12-01 began working on pcb for project
    [Master Sch.kicad_sch, Midi Bass Sch.kicad_pcb]
2024-12-01 started basic pcb layout for Master pic
    [ASolenoidA.kicad_sch, Aslave Sch.kicad_sch, DSolenoidA.kicad_sch, Dslave Sch.kicad_sch, Eslave Sch.kicad_sch, EsolenoidA.kicad_sch, GSolenoidA.kicad_sch, Gslave Sch.kicad_sch]
2024-12-02 began adding mute application to plucking unit
    [PluckingPack.kicad_sch, SSSlave sch.kicad_sch]
2024-12-02 finished prelim code for mute implementation
    [PluckingPack.kicad_sch]
2024-12-02 updated E slave to match schematic
2024-12-02 updated hours troubleshooting issues with e slave
    [Project Hours.ods]
2024-12-02 added stop interrupt detect for E slave
2024-12-02 rolled master up to include string limit evals master eval works at this moment as does the pluck slave in its current form
2024-12-02 fixed issues with eval on master
    [ESlave.asm, MidiMaster.asm]
2024-12-03 added plucking string flowchart
2024-12-03 updated schematic to reflect code
    [Aslave Sch.kicad_sch, Dslave Sch.kicad_sch, Eslave Sch.kicad_sch, Gslave Sch.kicad_sch, PluckingPack.kicad_sch, SSSlave sch.kicad_sch]
2024-12-03 included schematic and flow chart in report
2024-12-03 began writing calibration procedure
2024-12-03 added drawing for bass body
    [P-Bass Body Drawing.SLDDRW]
2024-12-03 added drawing for p-bass neck
    [P-Bass Neck Drawing.SLDDRW]
2024-12-04 updated pluck schematic
    [PluckingPack.kicad_sch]
2024-12-04 added drawing for bridge saddle
    [Bridge Saddle Drawing.SLDDRW, P-Bass Body Drawing.SLDDRW]
2024-12-04 added drawing for bridge
    [Simplified Bridge Drawing.SLDDRW]
2024-12-04 updated title block of bass body drawing
    [P-Bass Body Drawing.SLDDRW]
2024-12-04 added drawing for pickguard
    [Pick Guard Drawing.SLDDRW]
2024-12-04 added drawing for solenoid body
    [25n Solenoid Simple Body Drawing.SLDDRW]
2024-12-04 added image folder added screenshot for full cad assembly
2024-12-04 added drawing for solenoid firing pin
    [P-Bass.SLDASM, Solenoid Firing pin Drawing.SLDDRW]
2024-12-04 added pdf versions of all drawing sheets
    [P-Bass Neck Drawing.SLDDRW, Simplified Bridge Drawing.SLDDRW]
2024-12-04 working on finishing calibration section added image for hex switch
2024-12-05 added new troubleshooting flowcharts
2024-12-06 added flowchart for serial
2024-12-06 added flowchart for plucking unit added images of flowcharts
2024-12-06 modified flowcharts to use different end figure
2024-12-06 added flowchart for string units
2024-12-06 added schematic page for power
    [Midi Bass Sch.kicad_sch, PowerIn.kicad_sch]
2024-12-06 working on troubleshooting section of report
    [ASolenoidA.kicad_sch, Aslave Sch.kicad_sch, DSolenoidA.kicad_sch, Dslave Sch.kicad_sch, EsolenoidA.kicad_sch, GSolenoidA.kicad_sch, Gslave Sch.kicad_sch, PluckingPack.kicad_sch]
2024-12-06 working on final troubleshooting sections, modified pluck slave to header connections
    [ASolenoidA.kicad_sch, Aslave Sch.kicad_sch, DSolenoidA.kicad_sch, Dslave Sch.kicad_sch, EsolenoidA.kicad_sch, GSolenoidA.kicad_sch, Gslave Sch.kicad_sch, Master Sch.kicad_sch]
2024-12-09 updated plucking schematic to label line
    [SSSlave sch.kicad_sch]
2024-12-09 finished troubleshooting section
    [ASolenoidA.kicad_sch, Aslave Sch.kicad_sch, DSolenoidA.kicad_sch, Dslave Sch.kicad_sch, Eslave Sch.kicad_sch, EsolenoidA.kicad_sch, GSolenoidA.kicad_sch, Gslave Sch.kicad_sch]
2024-12-09 updated flowchart for string slave
2024-12-09 added updated flowchart for pluck slave
2024-12-09 added Bill of Materials
    [BOM.ods]
2024-12-10 updated bill of materials
    [BOM.ods]
2024-12-10 added flowcharts to presentation:
2024-12-10 added exported references from Kicad to a spreadsheet
    [BOM.ods, Kicad BOM.ods]
2024-12-10 finished BOM
    [BOM.ods, SSSlave sch.kicad_sch]
2024-12-10 updated BOM to include labor
    [BOM.ods, Project Hours.ods]
2024-12-10 changed transistor for schematic
    [ASolenoidA.kicad_sch, DSolenoidA.kicad_sch, EsolenoidA.kicad_sch, GSolenoidA.kicad_sch, PluckingPack.kicad_sch]
2024-12-10 added mechanical drawings to report
    [Project Hours.ods]
2024-12-10 began getting images for schematic appendix
    [ASolenoidA.kicad_sch, Aslave Sch.kicad_sch, DSolenoidA.kicad_sch, Dslave Sch.kicad_sch, Eslave Sch.kicad_sch, EsolenoidA.kicad_sch, GSolenoidA.kicad_sch, Gslave Sch.kicad_sch]
2024-12-10 added schematic to appendix
2024-12-10 updated presentation with serial commands also added command section to MIDI spreadsheet
    [Midi Notes and Real Notes.ods]
2024-12-10 finished presentation for current content to be covered
2025-01-09 began working on pcb layout deleted extra schematics for solenoid break out board
    [ASolenoidA.kicad_sch, Aslave Sch.kicad_sch, DSolenoidA.kicad_sch, Dslave Sch.kicad_sch, Eslave Sch.kicad_sch, EsolenoidA.kicad_sch, GSolenoidA.kicad_sch, Gslave Sch.kicad_sch]
2025-01-09 added traces for D processor began Pluck processor
    [Midi Bass Sch.kicad_pcb]
2025-03-10 changed solenoid schematic to include LED indicators
    [Eslave Sch.kicad_sch, EsolenoidA.kicad_sch, SSSlave sch.kicad_sch]
2025-03-10 added seperate schematic for solenoid breakout
    [Solenoid Breakout Board.kicad_pcb, Solenoid Breakout Board.kicad_sch]
2025-03-11 finished rev A pcb for breakout:
    [Solenoid Breakout Board.kicad_pcb, Solenoid Breakout Board.kicad_sch]
2025-03-11 created pcb for breakout working on pcb for main control board
    [Aslave Sch.kicad_sch, Dslave Sch.kicad_sch, Eslave Sch.kicad_sch, EsolenoidA.kicad_sch, Gslave Sch.kicad_sch, Master Sch.kicad_sch, Midi Bass Sch.kicad_pcb, Midi Bass Sch.kicad_sch]
2025-03-12 working in finishing Rev A pcb for motherboard
    [Gslave Sch.kicad_sch, Midi Bass Sch.kicad_pcb, Small Unit Breakout.kicad_pcb, Small Unit Breakout.kicad_sch]
2025-03-13 added profile for extrusion
    [2020 Extrusion.SLDPRT, P-Bass.SLDASM]
2025-03-14 added gerber zip files with motherboard and small breakout
    [Midi Bass Sch.kicad_pcb, Small Unit Breakout.kicad_pcb]
2025-03-14 updated motherboard pcb
    [Aslave Sch.kicad_sch, Eslave Sch.kicad_sch, Midi Bass Sch.kicad_pcb, PowerIn.kicad_sch, Small Unit Breakout.kicad_pcb]
2025-03-14 Working on first stages of CAD integration
    [P-Bass.SLDASM]
2025-03-14 added angled bracket for extrusions
    [90 Angle 2020 Bracket.SLDPRT]
2025-03-14 added short 2020 extrusion model
    [2020 Extrusion Short.SLDPRT, P-Bass.SLDASM]
2025-03-14 added new hours tracking sheet for new semester
    [P-Bass.SLDASM, Project Hours (6th).ods]
2025-03-14 began adding proposed frame to main assembly
    [P-Bass.SLDASM]
2025-03-15 began implementing cross fret bar
    [First Fret Bar.SLDPRT, P-Bass.SLDASM]
2025-03-15 added cross bar and defined main assembly
    [P-Bass.SLDASM, Top Cross Support.SLDPRT]
2025-03-17 added D and G strings
    [P-Bass.SLDASM]
2025-03-17 Extended Cage Length
    [2020 Extrusion.SLDPRT, P-Bass.SLDASM]
2025-03-17 added brace for bottom of cage
    [P-Bass.SLDASM]
2025-03-17 creating prelim plucking unit
    [P-Bass.SLDASM]
2025-03-18 changed bar and brace updated hours
    [First Fret Bar.SLDPRT, P-Bass.SLDASM, Project Hours (6th).ods, Top Cross Support.SLDPRT]
2025-03-18 added representive sponge model
    [2020 Extrusion Short.SLDPRT, P-Bass.SLDASM, Sponge Blank.SLDPRT]
2025-03-18 created mount for solenoids
    [P-Bass.SLDASM, Solenoid 2020 Mount.SLDPRT]
2025-03-18 added pickup slot to pickguard
    [P-Bass.SLDASM, Pick Guard.SLDPRT]
2025-03-18 added E and A strings to assem updated daily hours
    [P-Bass.SLDASM, Project Hours (6th).ods]
2025-03-19 added new model for small solenoid updated hours
    [4n Solenoid Body.SLDPRT, P-Bass.SLDASM, Project Hours (6th).ods]
2025-03-19 added pin for small solenoid
    [4n Solenoid Pin.SLDPRT, Project Hours (6th).ods]
2025-03-19 Added bracket to mount smaller solenoids
    [4n Solenoid Body.SLDPRT, 4n Solenoid Pin.SLDPRT, Bottom Support Bracket.SLDPRT, P-Bass.SLDASM, Small Mounting Bracket.SLDPRT]
2025-03-19 adding bracket for interface hardware
    [P-Bass.SLDASM]
2025-03-20 Created mounting brackets for plucking solenoids E and D Updated hours
    [2020 Extrusion Short.SLDPRT, P-Bass.SLDASM, Project Hours (6th).ods, Small Mounting Bracket D.SLDPRT, Small Mounting Bracket.SLDPRT]
2025-03-22 added new part for A mounting
    [P-Bass.SLDASM, Small Mounting Bracket A.SLDPRT]
2025-03-22 near complete with initial mechanical drafts
    [P-Bass.SLDASM]
2025-04-01 added mounting bracket for G solenoids reinforced brackets
    [Bottom Support Bracket.SLDPRT, Bottom Support Bracket.STL, P-Bass.SLDASM, Small Mounting Bracket G.SLDPRT, Top Cross Support.SLDPRT, Top Cross Support.STL]
2025-04-01 currently revising solenoid breakout to match new design
    [Solenoid Breakout Board.kicad_sch]
2025-04-02 revised schematic for breakout updating PCB to match
    [Solenoid Breakout Board.kicad_pcb, Solenoid Breakout Board.kicad_sch, SolenoidsEx.kicad_sch]
2025-04-02 replaced footprints on breakout to match new components
    [Solenoid Breakout Board.kicad_pcb, Solenoid Breakout Board.kicad_sch, SolenoidsEx.kicad_sch]
2025-04-03 finished rev B pcb for solenoid breakout
    [Solenoid Breakout Board.kicad_pcb]
2025-04-03 removed sheets of master schematic to match new design
    [Aslave Sch.kicad_sch, Dslave Sch.kicad_sch, Eslave Sch.kicad_sch, EsolenoidA.kicad_sch, Gslave Sch.kicad_sch, Midi Bass Sch.kicad_sch, PluckingPack.kicad_sch, SSSlave sch.kicad_sch]
2025-04-03 created and generated Rev. B of Motherboard
    [Eslave Sch.kicad_sch, Master Sch.kicad_sch, Midi Bass Sch.kicad_pcb, PowerIn.kicad_sch, SSSlave sch.kicad_sch]
2025-04-04 added rev b. zip files for new solenoid breakout
    [Solenoid Breakout Board-B_Cu.gbr, Solenoid Breakout Board-B_Mask.gbr, Solenoid Breakout Board-B_Silkscreen.gbr, Solenoid Breakout Board-Edge_Cuts.gbr, Solenoid Breakout Board-F_Cu.gbr, Solenoid Breakout Board-F_Mask.gbr, Solenoid Breakout Board-F_Silkscreen.gbr, Solenoid Breakout Board-NPTH-drl.gbr]
2025-04-04 added poweramp schematic
    [High Power Class AB-B_Cu.gbr, High Power Class AB-B_Mask.gbr, High Power Class AB-B_Paste.gbr, High Power Class AB-B_Silkscreen.gbr, High Power Class AB-Edge_Cuts.gbr, High Power Class AB-F_Cu.gbr, High Power Class AB-F_Mask.gbr, High Power Class AB-F_Paste.gbr]
2025-04-08 updated cad model for new solenoids
    [4n Solenoid Body.SLDPRT, 4n Solenoid Pin.SLDPRT, Bass Mount left.SLDPRT, Bass Mount.STL, First Fret Bar.STL, P-Bass.SLDASM, Small Mounting Bracket.SLDPRT, Small Mounting Bracket.STL]
2025-04-08 added hours log and cleaned main asm for slave program
    [JustinHours.xlsx]
2025-04-08 i think i found something related to the pcb issue
2025-04-08 tried opening kicad files but my local kicad is not up to date
2025-04-09 created test midi song for slave a, and addedd zach christensen's I2C protocol to help I2C troubleshooting
2025-04-15 updated and comments in some programs
    [Midi Notes and Real Notes.ods]
2025-04-16 updated fret bar model to be through hole
    [First Fret Bar.SLDPRT, First Fret Bar.STL, P-Bass.SLDASM, Small Mounting Bracket.SLDPRT]
2025-04-16 trying to figure out master program corruption
    [JustinHours.xlsx]
2025-04-17 fret slave program v1 + updated hours
    [JustinHours.xlsx]
2025-04-23 corrected linker and inc files updated status output pluck set status flag master
    [MidiMaster.asm, Pluck Slave.asm]
2025-04-24 added second stage of new eval method
2025-04-24 removed gerbers for small breakout
2025-04-24 updated main flowchart to match new design
2025-04-25 made modifications to conversion evaluation still fails
    [ESlave.asm, MidiMaster.asm]
2025-04-26 added new part for neck support
    [Neck Support Brace.SLDPRT, Neck Support Brace.STL, P-Bass.SLDASM]
2025-04-29 updated neck support brace to fit
    [Neck Support Brace.SLDPRT, Neck Support Brace.STL, P-Bass.SLDASM]
2025-04-29 added fret bars for 2nd and 3rd frets
    [2nd Fret Bar.SLDPRT, 3rd Fret Bar.SLDPRT, P-Bass.SLDASM]
2025-04-30 renamed Midi bass sch to Motherboard Sch
    [Eslave Sch.kicad_sch, Kicad BOM.ods, Master Sch.kicad_sch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]
2025-04-30 added bars for 4th to 9th frets
    [4th Fret Bar.SLDPRT, 5th Fret Bar.SLDPRT, 6th Fret Bar.SLDPRT, 7th Fret Bar.SLDPRT, 8th Fret Bar.SLDPRT, 9th Fret Bar.SLDPRT, P-Bass.SLDASM]
2025-04-30 updated flowcharts and names
    [Eslave Sch.kicad_sch, Motherboard Sch.kicad_sch, SSSlave sch.kicad_sch]
2025-04-30 adde more solenoids to main assembly
    [P-Bass.SLDASM]
2025-04-30 added stls for new models
    [2nd Fret Bar.STL, 3rd Fret Bar.STL, 4th Fret Bar.STL, 5th Fret Bar.STL, 6th Fret Bar.STL, 7th Fret Bar.STL, 8th Fret Bar.STL, 9th Fret Bar.STL]
2025-05-01 designed new bars and added stls updated pluck unit to match new solenoids
    [10th Fret Bar.SLDPRT, 10th Fret Bar.STL, 11th Fret Bar.SLDPRT, 11th Fret Bar.STL, 12th Fret Bar.SLDPRT, 12th Fret Bar.STL, 14th Fret Bar.SLDPRT, 16th Fret Bar.SLDPRT]
2025-05-01 added new bracket for muting solenoids
    [Muting Bracket.SLDPRT, P-Bass.SLDASM, Small Mounting Bracket G.STL]
2025-05-01 hours + added IR schematics + updated fret code header
    [FullIRSchematic.kicad_pcb, FullIRSchematic.kicad_sch, JustinHours.xlsx, Rx.kicad_pcb, Rx.kicad_sch, Tx.kicad_pcb, Tx.kicad_sch]
2025-05-02 added kicad main build for motherboard
2025-05-02 added new models for electonics case :
    [Motherboard PCB BLANK.SLDPRT, PCB Case Assem.SLDASM, PCB Standoff.SLDPRT, Solenoid PCB Blank.SLDPRT]
2025-05-02 added stls for higher even frets
    [14th Fret Bar.STL, 16th Fret Bar.STL, 18th Fret Bar.STL, 20th Fret Bar.STL, Muting Bracket.STL]
2025-05-03 added new pin headers to electronics case added din rail from autocad final
    [2.54mm Header 21-pin.SLDPRT, 2.54mm Header Single.SLDPRT, 2.54mm Right Header 21-pin 2x.SLDPRT, DIN Mounting Rail.SLDPRT, Motherboard PCB BLANK.SLDPRT, P-Bass.SLDASM, PCB Case Assem.SLDASM, PCB Mount.SLDPRT]
2025-05-04 designed new casing for breakout as well as prelim mounting solution for din rail
    [DIN Mounting Rail.SLDPRT, DIN Rail Mounts.SLDPRT, Fret Board Cage.SLDPRT, Fret Board Cage.STL, PCB Case Assem.SLDASM, PCB Mount.SLDPRT, Solenoid Hori Mount.SLDPRT, Solenoid Hori Mount.STL]
2025-05-04 began to update hours to current
    [Project Hours (6th).ods]
2025-05-06 added drawing sheet for muting braket
    [Muting Bracket Drawing.SLDDRW]
2025-05-06 added new drawings for neck support
    [Muting Bracket Drawing.SLDDRW, Muting Bracket.SLDPRT, Neck Support Brace Drawing.SLDDRW, Neck Support Brace.SLDPRT, Solenoid 2020 Mount.SLDPRT]
2025-05-06 added drawing for solenoid mount for 2020 rails
    [Solenoid 2020 Mount Drawing.SLDDRW, Top Cross Support Drawing.SLDDRW]
2025-05-06 added drawing sheet for top bracket
    [Top Cross Support Drawing.SLDDRW, Top Cross Support.SLDPRT]
2025-05-06 add drawing for E string plucking solenoid mounts
    [Small Mounting Bracket Drawing.SLDDRW, Small Mounting Bracket.SLDPRT, Top Cross Support Drawing.SLDDRW]
2025-05-06 added drawing for 4N solenoid
    [4n Solenoid Body Drawing.SLDDRW, 4n Solenoid Body.SLDPRT, Small Mounting Bracket Drawing.SLDDRW]
2025-05-06 added comments to pin blocks
    [4n Solenoid Pin Drawings.SLDDRW, 4n Solenoid Pin.SLDPRT]
2025-05-06 added drawing for bass mounting brackets
    [Bass Mount Drawing.SLDDRW, Bass Mount left.SLDPRT]
2025-05-06 added drawing for short extrusion pdfs for both 2020 extrusions added
    [2020 Extrusion Short Drawing.SLDDRW, 2020 Extrusion Short.SLDPRT]
2025-05-06 moved drawing sheets and added sheet for 2020 long and lower bracket also added stl for din rail mounts
    [2020 Extrusion 970mm Drawing.SLDDRW, 2020 Extrusion.SLDPRT, 25n Solenoid Simple Body Drawing.SLDDRW, Bottom Support Bracket Drawing.SLDDRW, Bottom Support Bracket.SLDPRT, Bridge Saddle Drawing.SLDDRW, DIN Rail Mounts.STL, P-Bass Body Drawing.SLDDRW]
2025-05-06 updating for merge
    [JustinHours.xlsx, Rx.kicad_sch, Tx.kicad_sch]
2025-05-06 updated BOM
    [BOM.ods]
2025-05-07 updated hours, created new 'main' branch
    [Project Hours (6th).ods]
2025-05-07 finished hours
    [Project Hours (6th).ods]
2025-05-07 added bom for current project revision
    [BOM V2.ods]
2025-05-07 added new models for muting unit to fit proper
    [90 Angle 2020 Bracket.STL, DIN Rail Mounts.SLDPRT, DIN Rail Mounts.STL, Muting Bracket.SLDPRT, Muting Bracket.STL, Muting Finger.SLDPRT, Muting Finger.STL, P-Bass.SLDASM]
2025-05-07 added flowchart for mechanical troubleshooting
2025-05-07 removed old schematic pdf
    [FullIRSchematic.kicad_sch, Project Hours (6th).ods]
2025-05-07 added images for individual schematic pages for motherboard
2025-05-07 added pcb sheets
    [Solenoid Breakout Board.kicad_pcb, Solenoid Breakout Board.kicad_sch]
2025-05-07 added new report to repo
    [Motherboard Sch.kicad_pcb]
