Masaharu41/Midi-Bass-Guitar/Images/Master Pic ain breadboard.jpg

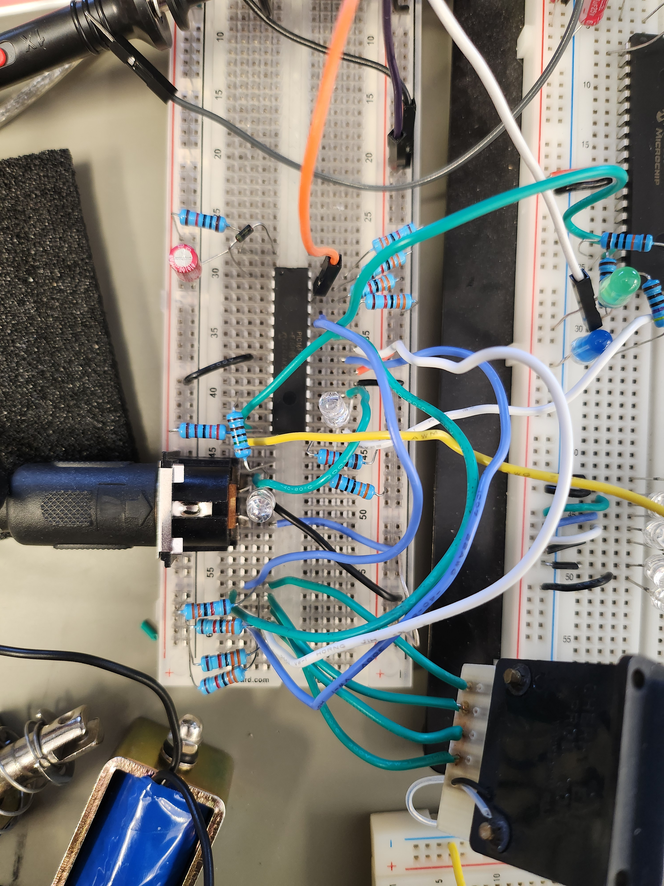
Images/Master Pic ain breadboard.jpg
